AgileRadioCom-LLC/ARC-Re-Packaging-Design/README.md

# RPKG
Repo for ArcSynerCom RPKG Files
# ARC-Re-Packaging-Design
