AgileRadioCom-LLC/ARC-Re-Packaging-Design/DECISIONS_LOG.md

# UZEV ADRV9009 Carrier — Decisions Log

This log captures every decision made that affects the design, with provenance.
Newest entries at the top. Each entry cites its source of truth.

## DEC-051 — Phase 8 netlist export complete
Date: 2026-06-17  |  Source: EEschema GUI, Tools → Generate Netlist File (KiCad format)
Status: COMPLETE. Netlist MD5: 7762ec8dbcc8da5028d237ab52b527b6

Exported as: Desktop/Netlist Files/4uzev_adrv9009_carrier.net (Jun 17 10:32 EDT)
Copied to:   uzev_carrier.net in project root (same MD5)
Tool: Eeschema 5.1.5+dfsg1-2build2, format version D, 192K, 175 components.

Verification:
  - All 8 Phase 7 footprints (FB1, J5, R68-R71, U6, U7) present and correct in netlist
  - Zero components with empty footprint field
  - KiCad (version D) format — ready for Pcbnew import

---

## DEC-050 — Phase 7 footprint assignment complete (power.sch)
Date: 2026-06-16  |  Source: Phase 7 audit; project UZEV_Connectors.pretty; system lib
Status: COMPLETE. power.sch MD5: 5cc2bc8720f66a9cf5d3e3c98180e88b

All 8 previously-MISSING F2 footprint fields in power.sch assigned atomically
via Python read-modify-write (os.replace). No other files changed.

Assignments made:
  FB1  (120R@100MHz 0603)       -> Inductor_SMD:L_0603_1608Metric        [system lib]
  J5   (USB_C_Receptacle)       -> UZEV_Connectors:USB_C_Receptacle_GCT_USB4135  [project lib]
  R68  (100k PG pull-up)        -> Resistor_SMD:R_0402_1005Metric        [system lib]
  R69  (100k PG pull-up)        -> Resistor_SMD:R_0402_1005Metric        [system lib]
  R70  (100k PG pull-up)        -> Resistor_SMD:R_0402_1005Metric        [system lib]
  R71  (100k PG pull-up)        -> Resistor_SMD:R_0402_1005Metric        [system lib]
  U6   (TPS25730D)              -> UZEV_Connectors:WQFN-38_TPS25730D     [project lib]
  U7   (TPS7A1633)              -> UZEV_Connectors:HVSSOP-8_TPS7A1633    [project lib]

All .kicad_mod files verified on disk before assignment. Zero MISSING, PLACEHOLDER,
or unresolved-library gaps remain in any sheet. Phase 7 complete.

---

## DEC-042 — 2026-06-12 — DEF-20 Edit 2b: EN daisy-chain rewire (DEF-20 CLOSED)

**Status:** APPLIED — ERC-25 0/0. Semantic net check passed.

**What:** Completed the §4.16 EN sequencing daisy-chain in power.sch. 11 ops:

(1) Added 4 × Text Labels naming the LDO PG nets at their pull-up nodes:
    L1_PG @ (7950,5600), L2_PG @ (7950,8300),
    L5_PG @ (27950,5600), L6_PG @ (27950,8300).
    These are required because KiCad Text Labels only name the net if the
    label coordinate sits on copper; without them the downstream EN labels
    would be electrically orphaned (same bug class as DEF-19 mid-span issue).

(2) Swapped 5 × SOM_PG_OUT GLabel → Text Label at B1–B5 EN far-ends:
    B1.EN (2600,5600) → L6_PG, B2.EN (2600,8300) → L1_PG,
    B3.EN (2600,11000) → L2_PG, B4.EN (12600,5600) → L2_PG,
    B5.EN (12600,8300) → L2_PG.

(3) Removed 2 × NoConn at B6.EN (23000,5600) and B7.EN (23000,8300).

(4) Added SOM_PG_OUT GLabel + wire (22600,5600)→(23000,5600) for B6.EN.

(5) Added L5_PG Text Label + wire (22600,8300)→(23000,8300) for B7.EN.

**Semantic net check (all PASS):**
- L6_PG: L6.PG(27950,8300) ↔ B1.EN(3000,5600) via label pair ✓
- L1_PG: L1.PG(7950,5600) ↔ B2.EN(3000,8300) via label pair ✓
- L2_PG: L2.PG(7950,8300) ↔ B3.EN + B4.EN + B5.EN via 4 labels ✓
- L5_PG: L5.PG(27950,5600) ↔ B7.EN(23000,8300) via label pair ✓
- SOM_PG_OUT: JX1.D47 (connectors.sch GLabel) ↔ B6.EN(23000,5600) ✓
              support_io.sch LED tap also on net ✓; no carrier pull-up added ✓

**Resulting §4.16 sequencing:**
- SOM_PG_OUT → B6.EN (G1: MGTRAVCC) → B7.EN (G1: MGTRAVTT) via L5_PG
- L6.PG → B1.EN (G2: MGTAVCC) → B2.EN (G2: MGTAVTT) via L1_PG
- L2.PG → B3.EN (G3: VCCO_HP_65) + B4.EN (G3: VCCO_HP_64) + B5.EN (G3: FMC_3P3V)
- MGTVCCAUX: passive tap off VCCO_HP_65 (Group 3, DS925-governed deviation — logged in DEF-20)

**File state:** power.sch PRE MD5=12e2bb6741618147d0cdcb2569b06f33 →
POST MD5=dcf8803f3f9b118bd183d47b4730725e (3812→3826 lines).

**Source:** Designer's Guide §4.16 p.37 (group order); DS925 p.65 (MGTAVCC before MGTAVTT).

---

## DEC-041 — 2026-06-12 — DEF-20 Edit 2a: LDO PG pull-up resistors R68–R71

**Status:** APPLIED — ERC-24 0/0.

**What:** Added 4 × 100kΩ pull-up resistors (R68–R71) on the PG pins of the
four LDOs that feed the DEF-20 sequencing chain (L1, L2, L5, L6). Each
pull-up connects pin1 to VIN (via GLabel) and pin2 to the LDO PG pin via a
two-segment wire (vertical stub + horizontal run). The four NoConn markers
previously suppressing ERC on those PG pins were removed.

**Why:** TPS7A85 PG is open-drain (type O in LDO_ENPG lib). An open-drain
output cannot drive a downstream EN input without an external pull-up to a
defined rail. Without these resistors the PG output is undefined high-Z when
the LDO is healthy, making the daisy-chain EN wiring (Edit 2b) non-functional.
Pattern mirrors existing BUCK PWRGD pull-ups R50–R53, R60, R67.

**Resistors placed (power.sch):**
- R68: P=(8700,5475), L1.PG=(7950,5600), VIN at pin1=(8700,5325)
- R69: P=(8700,8175), L2.PG=(7950,8300), VIN at pin1=(8700,8025)
- R70: P=(29000,5475), L5.PG=(27950,5600), VIN at pin1=(29000,5325)
- R71: P=(29000,8175), L6.PG=(27950,8300), VIN at pin1=(29000,8025)

**Wire clearances verified:** All horizontal runs pass through confirmed-clear
column gaps (C3, C19, C71, C78 gaps) and stop before FB-divider/remote-sense
columns at x=7950 and x=29500.

**UIDs:** 6C00011C–6C00011F (sequential after prior max 6C00011B).

**Footprint:** left empty pending Phase 7 sweep (DEC-028/029).

**File state:** power.sch PRE MD5=4f8ee3235c8896199ddbaddbdd203af3 →
POST MD5=12e2bb6741618147d0cdcb2569b06f33 (3748→3812 lines).

**Source:** TPS7A85 datasheet (open-drain PG specification); pattern from
R50–R53 (DEC-037) and R60/R67 (DEC-039).

**Next:** DEF-20 Edit 2b — daisy-chain EN rewiring (5 GLabel→TextLabel swaps
+ 7 new net connections). DEF-20 remains OPEN until 2b ERC passes.

---

## DEC-040 — 2026-06-12 — DEF-19 Edit 1 ERC fix: wire splits + stub NoConns

**Status:** APPLIED — ERC-22 0/0, save-cycle ERC-23 0/0. Verified stable.

**What:** Resolved 16 ErrType(2) "Pin not connected" errors introduced by
DEF-19 Edit 1 (B6/L5 MGTRAVCC + B7/L6 MGTRAVTT subcircuits). Two categories:

Part A — 12 cap pin mid-span errors (C68, C70, C71, C75, C77, C78, pins 1+2
each): root cause = pin tip fell mid-span on vertical wire stub (not at an
endpoint). Fix = split each wire at the pin coordinate into two collinear
sub-segments + explicit `Connection ~` junction marker at the split point.
Junction markers are required to survive KiCad GUI save; bare collinear seams
get re-merged (R50–R53 regression pattern, proven). All 12 pins are genuinely
connected — these were ERC flags only, not dead terminals.

Part B — 4 stub pin errors (B6.EN, B7.EN, L5.PG, L6.PG): root cause = one-
ended Text Label stub leaves the connected Input/Output pin flagged by ERC.
Fix = replace each wire+label pair with `NoConn ~` at the pin coordinate +
`Text Notes` preserving net name + "(DEF-20)" annotation for sequencing
traceability. Pattern matches existing L1–L4 PG/EN treatment.

**Script:** /tmp/def19_erc21_fix.py (atomic, os.replace, idempotency guard,
pre/post MD5). Pre-MD5: 44e850c0ee103e69fc867e278ea072a2.
Post-MD5: 4f8ee3235c8896199ddbaddbdd203af3. Lines: 3716 → 3748.

**Side finding logged as DEF-23** (pre-existing, out of scope here).

---

## DEC-035 — 2026-05-26 — Replace barrel jack J5 with USB-C PD input (HUSB238)

**Status:** APPLIED — audit 9/9 passed, ERC pending (GUI).

**Context:** Board needs a single standard power input. Barrel jacks are non-standard in field deployments; USB-C PD chargers (laptop bricks) are ubiquitous. Requirement: 12V primary supply, 15V fallback. No firmware — hardware-only PD negotiation.

**Decision:**
- Remove J5 (UZEV_Connectors:Barrel_Jack) from power.sch.
- Add USB-C receptacle (J5, re-used designator): GCT USB4135-GF-A, 16-pin mid-mount SMD, rated to 5A. Only VBUS, CC1, CC2, GND connected; SBU/D+/D- NC.
- Add HUSB238 PD sink controller (U6, Hynetek). Hardware pin-strap selects "highest available PDO ≤ 15V". On a 12V charger → 12V contract; on 15V/20V charger → 15V contract. No firmware. VOUT → VIN net (replaces barrel jack output).
- Add decoupling: 10µF/25V ceramic (C_VBUS) + 100nF/25V ceramic (C_VBUS2) on VBUS before HUSB238.
- HUSB238 CFG pins tied per datasheet table for "≤15V highest" profile (resistors to VSS or direct tie — confirmed from HUSB238 datasheet during implementation).
- Update text note line "Barrel jack -> VIN..." to "USB-C PD (HUSB238, 12V/15V) -> VIN...".

**Rationale:** HUSB238 is the simplest hardware-only PD sink — no I2C, no MCU. Single chip. CFG pins fully determine negotiated voltage. Widely used in open-hardware PD designs.

**Implementation steps:**
1. Add USB_C_Receptacle and HUSB238 symbols to UZEV_Connectors.lib (new DEF blocks).
2. Add USB_C_Receptacle and HUSB238 footprints to UZEV_Connectors.pretty/.
3. Edit power.sch: remove J5 barrel jack block + #PWR04 + its wire; add new USB-C + HUSB238 section.
4. Update phase7_prepcb_audit.py hashes.

**New components added to power.sch:**
- J5 — USB_C_Receptacle (USB4135-GF-A footprint) — replaces barrel jack
- U6 — HUSB238 (SOT-23-9_Hynetek_HUSB238 footprint)
- C60 — 10µF/25V 1210 on VBUS (bulk decoupling)
- C61 — 100nF/25V 0402 on VBUS (HF decoupling)
- R40 — 10kΩ 0402 PG pullup (VOUT → PG pin)
- #PWR062–#PWR066 (5 GND symbols)

**Implementation note:** `dec035_step3_sch.py` used a stamp-based block-removal regex that expanded across $Comp boundaries, accidentally deleting C4/C5/C6/#PWR01-03 (VIN rail caps). `dec035_step3_repair.py` restored these and renamed the VBUS decoupling caps from C7/C8 (collision with existing B3 buck caps) to C60/C61.

**HUSB238 CFG pins:** Tied to GND in schematic. Exact bit-table for "highest available ≤ 15V" must be confirmed from HUSB238 datasheet PDF before fab. Update schematic if CFG configuration differs from GND-tie.

**Files modified:**
- `UZEV_Connectors.lib`: md5=`63fe2e2e3c9c84424d2f50d959ecd432` size=65554
- `UZEV_Connectors.pretty/USB_C_Receptacle_GCT_USB4135.kicad_mod`: created
- `UZEV_Connectors.pretty/SOT-23-9_Hynetek_HUSB238.kicad_mod`: created
- `power.sch`: md5=`8eeabb3d55a62b4177046839b82a2275` size=51906
- `phase7_prepcb_audit.py`: hash table updated

---

## DEC-034 — 2026-05-26 — Add external buck converter circuit components to schematic

**Status:** APPLIED — all post-checks passed, phase7_prepcb_audit 9/9 passed.

**Context:** Buck_ENPG symbol (TPS54320 × 4 B1-B4, TPS54531 × 1 B5) had only VIN/GND/VOUT/EN/PG/FB pins in the schematic. External application circuit components (inductor, bootstrap cap, compensation network, soft-start cap, catch diode) were missing — required for PCB layout and BOM.

**Step 1 — Extend Buck_ENPG symbol (UZEV_Connectors.lib):**
Added 5 pins to Buck_ENPG DRAW block; body extended from S -300 300 300 -300 to S -300 450 300 -450:
- SW 7 — 500 350 200 L P (switched node, power)
- BOOT 8 — 0 650 200 D P (bootstrap, power)
- COMP 9 — -500 -250 200 R P (compensation, power)
- RT 10 — -500 -400 200 R I (freq-set resistor, input)
- SS 11 — 200 -650 200 U I (soft-start cap, input)
Script: `dec034_step1_lib.py`. Pre-md5: `55a6352265bd284d8ffab7a67f2f0e08`.
Post-md5: `6331f14394645f511d8ec71a2a17cd45` size=64487.

**Step 2 — Add external components to power.sch:**
Added 36 components + wires + junctions for all 5 bucks. Script: `dec034_step2_sch.py`.
Per-buck placement at (Px,Py) with pins at SW=(Px+500,Py-350), BOOT=(Px,Py-650), COMP=(Px-500,Py+250), RT=(Px-500,Py+400), SS=(Px+200,Py+650):

| Component | Value | Footprint | Count |
|---|---|---|---|
| IND1–IND5 | 4.7µH | Inductor_SMD:L_1210_3225Metric | 5 |
| C40–C44 (C_BOOT) | 100nF | C_0402_1005Metric | 5 |
| C45–C49 (C_COMP B1-B4) | 15nF / (B5) 2200pF | C_0402_1005Metric | 5 |
| C50–C54 (C_HF B1-B4) | 330pF / (B5) 22pF | C_0402_1005Metric | 5 |
| C55–C59 (C_SS) | 10nF | C_0402_1005Metric | 5 |
| R31–R35 (R_COMP B1-B4) | 1.78kΩ / (B5) 37.4kΩ | R_0402_1005Metric | 5 |
| R36–R39 (R_RT, B1-B4 only) | 100kΩ | R_0402_1005Metric | 4 |
| D2 (catch diode, B5 only) | CDBC540-G | Diode_SMD:D_SOD-123 | 1 |
| #PWR042–#PWR061 | GND | — | 20 |

COMP wire route: (Px-500,Py+250)→(Px-600,Py+350)→(Px-1900,Py+350) [y=Py+350 clears R_RT body at Py+400].
B5 RT pin: NoConn ~ 13000 8600.

**Step 2b — Fix ref collisions:**
C20-C39 conflicted with existing refs in adrv9009_signals.sch (C21-C28) and support_io.sch (C29, D1).
Script: `dec034_step2b_fixrefs.py` renamed C20-C39→C40-C59 and D1(stamp 6C000093)→D2.

**Stamp range used:** 0x6C00005E–0x6C000094 (55 stamps).

**Files modified:**
- `UZEV_Connectors.lib`: Buck_ENPG symbol extended. md5=`6331f14394645f511d8ec71a2a17cd45` size=64487
- `power.sch`: 36 components added. md5=`7c33f35db7145168e8f9760c04a47975` size=49068
- `phase7_prepcb_audit.py`: EXPECTED_HASHES updated for UZEV_Connectors.lib and power.sch

---

## DEC-033 — 2026-05-25 — Phase 7: Footprint corrections for B5, L1-L4, B1-B4

**Status:** APPLIED — static verification passed (0 empty footprints, old strings absent). ERC pending (GUI).

**Context:** Phase 7 footprint inventory revealed three footprint assignment errors in power.sch.
All corrections derived from TI primary-source package outline and land pattern drawings.

**Change 1 — B5 (TPS54531, FMC_3P3V rail, 5A buck):**
- Old: `Package_TO_SOT_SMD:PowerPAD_SO-8_EP_3.9x4.9mm_P1.27mm`
- New: `Package_SO:SOIC-8-1EP_3.9x4.9mm_P1.27mm_EP2.95x4.9mm_Mask2.71x3.4mm`
- Source: tps54531.pdf p.34, DDA0008B Package Outline — EP 2.95×4.9mm copper, 2.71×3.4mm mask.
  Old footprint had wrong EP geometry and wrong library prefix.

**Change 2 — L1-L4 (TPS7A85, 4A LDO × 4):**
- Old: `Package_DFN_QFN:VQFN-20-1EP_3.5x3.5mm_P0.5mm_EP2.1x2.1mm`
- New: `Package_DFN_QFN:QFN-20-1EP_3.5x3.5mm_P0.5mm_EP2x2mm`
- Source: tps7a85.pdf pp.46-47, RGR0020A Land Pattern Example — EP 2.0×2.0mm recommended.
  EP difference 0.05mm undersize; conservative and within IPC tolerance. Standard footprint
  already present in KISYSMOD.

**Change 3 — B1-B4 (TPS54320, 3A buck × 4, Architecture B):**
- Old: `Package_DFN_QFN:VQFN-14-1EP_3.5x4.5mm_P0.65mm_EP2.1x3.1mm` (wrong on all three
  dimensions: body was 3.5×4.5 not 3.5×3.5; pitch was 0.65 not 0.5; EP was 2.1×3.1 not 2.05×2.05)
- New: `UZEV_Connectors:VQFN-14-1EP_3.5x3.5mm_P0.5mm_EP2.05x2.05mm` (custom, created this session)
- Source: tps54320.pdf pp.40-41, RHL0014A Package Outline + Land Pattern Example.
  Pin arrangement 2+5+2+5 (top+left+bottom+right). Pin 1 at top-left confirmed by dotted
  surface mark and 45° chamfer. CCW numbering confirmed from land pattern figure. EP 2.05×2.05mm,
  signal pad size 0.24×0.6mm (top/bottom rows) and 0.6×0.24mm (left/right columns), pad reach
  1.65mm from center, pitch 0.5mm.
  Custom .kicad_mod written to UZEV_Connectors.pretty/ with segmented EP paste pads (4×0.75mm sq).

**Files modified:**
- `power.sch`: 9 footprint field substitutions (1 B5, 4 L1-L4, 4 B1-B4)
- `UZEV_Connectors.pretty/VQFN-14-1EP_3.5x3.5mm_P0.5mm_EP2.05x2.05mm.kicad_mod`: created

**Hashes post-DEC-033:**
- `power.sch`: md5=`126da442c9bdf1cb99d62f1e8e0778c3` size=32493

---

## DEC-032 — 2026-05-25 — ADD_REV1: Add micro-SD card slot (PS SD1, MIO45-51)

**Status:** APPLIED — ERC 14 confirmed 0 errors, 0 warnings.

**Context:** DEC-021 reserved the micro-SD slot as the sole carrier-side storage addition.
DEC-022 designated it DNP for flight builds. MIO45-51 on UltraZed-EV JX3 connector carry
PS SD1 (1.8V UHS-I interface). No SD1 circuitry existed on the board prior to this decision.

**Decision:** Add J8 (Micro_SD_Card_Det, Hirose DM3AT-SF-PEJM5 footprint) in support_io.sch.
Wire MIO45-51 from J3 stubs in connectors.sch to J8 via global labels. DNP J8 and ESD array
(PRTR5V0U2X or equiv) for flight builds per DEC-021.

**Signal mapping (PS SD1, MIO pin → JX3 ball → GLabel → J8 pin):**
| MIO | JX3 ball | GLabel | J8 pin |
|-----|---|---|---|
| 45  | A23 | SD1_CD_N  | DET_A (pin 10) |
| 46  | B24 | SD1_CLK | CLK (pin 5)  |
| 47  | A25 | SD1_CMD | CMD (pin 3)  |
| 48  | B26 | SD1_D0 | DAT0  (pin 7)  |
| 49  | A27 | SD1_D1 | DAT1  (pin 8)  |
| 50  | B28 | SD1_D2 | DAT2  (pin 1)  |
| 51  | A29 | SD1_D3 | DAT3/CD (pin 2) |

**Changes applied (atomic Python script `add_rev1_sd_card.py` + manual PWR_FLAG fix):**

| Sheet | Change |
|---|---|
| connectors.sch | Removed 7 NoConns on J3 MIO45-51 pins |
| connectors.sch | Added wire stubs + GLabels SD1_CD_N/CLK/CMD/D0-D3 on J3 MIO45-51 |
| support_io.sch | Added J8 Micro_SD_Card_Det at P=(3500,12800) |
| support_io.sch | Added power:+3V3 #PWR_SD01 at (2600,12700) for J8 VDD |
| support_io.sch | Added power:GND #PWR_SD02 at (2600,12900) for J8 VSS |
| support_io.sch | Added power:GND #PWR_SD03 at (4300,13300) for J8 SHIELD |
| support_io.sch | Added PWR_FLAG #FLG_SD01 at (2600,12700) to drive +3V3 net (ERC fix) |
| support_io.sch | Added 7 GLabel+wire pairs (SD1_* nets) connecting to J8 left-side pins |
| support_io.sch | Added NoConn at (2600,13300) for J8 DET_B (pin 9) |

**Files modified:**
- `connectors.sch`
  - Before md5: `4a62b831b36487f0c14ae96b93290207` (post-DEC-031)
  - After md5: `0377a743d1d3fc07bb2aeb4394f67ba2`
- `support_io.sch`
  - Before md5: `054467de6de13ad08470abd19f86b090`
  - After md5: `34c0a2aeb89bbd37e8e34374e4718a6d`

**ERC:** 14uzev_adrv9009_carrier.erc — 0 errors, 0 warnings
**Netlist:** 2uzev_adrv9009_carrier.net — all 7 SD1 nets verified (SD1_CLK: J3-B24+J8-5; SD1_CMD: J3-A25+J8-3; SD1_D0: J3-B26+J8-7; SD1_D1: J3-A27+J8-8; SD1_D2: J3-B28+J8-1; SD1_D3: J3-A29+J8-2; SD1_CD_N: J3-A23+J8-10)

**Bitstream impact:** None (schematic only; PS SD1 enabled in Zynq PS config, not PL).

---

## DEC-031 — 2026-05-25 — Fix tx_sync_1 net merge failure (direct naming)

**Status:** APPLIED — ERC 13 confirmed 0 errors, 0 warnings. Netlist verified.

**Context:** DEC-030 added GLabels around pre-existing floating wires in adrv9009_signals.sch
to bridge FMC_H31_LA28_P ↔ HP_DP_38_P and FMC_H32_LA28_N ↔ HP_DP_38_N. Despite identical
format to all working signals, KiCad 5.1.5 did not merge the nets — the four pins still
appeared as isolated one-node stubs in the netlist (nets 237/238/254/255). ERC also reported
all four pins as unconnected (ErrType 2). Root cause: the tx_sync_1 wires in
adrv9009_signals.sch pre-existed from DEC-007 as purely decorative floating stubs with no
labels; adding GLabels around pre-existing floating wires in this context did not produce
net merging in KiCad's legacy resolver.

**Fix:** Bypass adrv9009_signals.sch routing entirely. Give both connector stubs the same
GLabel name directly in connectors.sch so they merge on the connectors sheet without
requiring a cross-sheet bridge.

**Changes applied (atomic Python script `fix_dec031_tx_sync1_direct.py`):**

| Sheet | Change |
|---|---|
| connectors.sch | Renamed GLabel HP_DP_38_P → FMC_H31_LA28_P on J1-B36 stub at (6600,7050) |
| connectors.sch | Renamed GLabel HP_DP_38_N → FMC_H32_LA28_N on J1-B37 stub at (5400,7150) |
| adrv9009_signals.sch | Reverted DEC-030 GLabels: removed 4 GLabels, restored original floating wires + notes |

**Resulting net names:**
- `FMC_H31_LA28_P` — nodes: J4-H31, J1-B36
- `FMC_H32_LA28_N` — nodes: J4-H32, J1-B37
- `HP_DP_38_P` / `HP_DP_38_N` — eliminated from netlist

**Files modified:**
- `connectors.sch`
  - Before md5: `799a9828c934434be5dd4c1e49bcbca4` (DEC-030 state)
  - After md5: `4a62b831b36487f0c14ae96b93290207`
- `adrv9009_signals.sch`
  - Before md5: `254ff6d046b4a41afaf7bbee64680f1a` (DEC-030 state)
  - After md5: `e0d870dacab2bcf0028b8c255f9fb0f6`

**ERC:** 13uzev_adrv9009_carrier.erc — 0 errors, 0 warnings
**Netlist:** 1uzev_adrv9009_carrier.net — FMC_H31_LA28_P has J4-H31 + J1-B36; FMC_H32_LA28_N has J4-H32 + J1-B37

**Bitstream impact:** None (signal routing only).

---

## DEC-030 — 2026-05-22 — Fix tx_sync_1 missing GLabels and connector stubs

**Status:** APPLIED — ERC VERIFICATION REQUIRED

**Context:** CRIT-1 Sheet 3 audit (Step 4, transition doc) revealed that the ADRV9009
tx_sync_1 differential pair (FMC H31_LA28_P/H32_LA28_N → JX1 B36/B37) was completely
unrouted. DEC-007 placed tie wires at Y=6200 and Y=6450 in adrv9009_signals.sch but
omitted all four GLabels (FMC side and HP_DP side). Neither the FMC connector pin nor
the JX1 pin was wired in connectors.sch; both positions had NoConn flags from DEC-029.

**Root cause:** DEC-007 did not include tx_sync_1 in its signal set. The wire stubs were
placed but without net labels, leaving them as netlist-invisible floating wires.

**Authoritative mapping (from UZEV_Connectors.lib unit 2 lines 101–102):**
- JX1 B36 = HP_DP_38_P (lib: x=400, y=-1050, unit 2, P=(6000,6000))
- JX1 B37 = HP_DP_38_N (lib: x=-400, y=-1150, unit 2, P=(6000,6000))

**Changes applied (atomic Python script `fix_dec030_tx_sync1.py`):**

| Sheet | Change |
|---|---|
| adrv9009_signals.sch | Added GLabel FMC_H31_LA28_P at (12000,6200) orientation 0 |
| adrv9009_signals.sch | Added GLabel HP_DP_38_P at (13400,6200) orientation 2 |
| adrv9009_signals.sch | Added GLabel FMC_H32_LA28_N at (12000,6450) orientation 0 |
| adrv9009_signals.sch | Added GLabel HP_DP_38_N at (13400,6450) orientation 2 |
| connectors.sch | Removed NoConn at (23900,21000) — FMC H31 pin |
| connectors.sch | Removed NoConn at (23900,21100) — FMC H32 pin |
| connectors.sch | Added wire (23900,21000)→(23700,21000) + GLabel FMC_H31_LA28_P |
| connectors.sch | Added wire (23900,21100)→(23700,21100) + GLabel FMC_H32_LA28_N |
| connectors.sch | Removed NoConn at (6400,7050) — JX1 B36 pin |
| connectors.sch | Removed NoConn at (5600,7150) — JX1 B37 pin |
| connectors.sch | Added wire (6400,7050)→(6600,7050) + GLabel HP_DP_38_P |
| connectors.sch | Added wire (5600,7150)→(5400,7150) + GLabel HP_DP_38_N |

**Files modified:**
- `adrv9009_signals.sch`
  - Backup: `adrv9009_signals.sch.bak.before_dec030`
  - Before md5: `e0d870dacab2bcf0028b8c255f9fb0f6`
  - After md5: `254ff6d046b4a41afaf7bbee64680f1a`
- `connectors.sch`
  - Backup: `connectors.sch.bak.before_dec030`
  - Before md5: `f8a98eae84bb475b77ef83cc5effc7b4`
  - After md5: `799a9828c934434be5dd4c1e49bcbca4`

**Bitstream impact:** None (signal routing only; FPGA logic unchanged).

---

## DEC-029 — 2026-05-06 — NoConn flag sweep: all four sheets

**Status:** APPLIED

**Context:** ERC 10 confirmed 0 errors, 0 warnings. Final pre-netlist cleanup: added NoConn
markers to all unused connector and IC pins across all sheets to suppress future ErrType(2)
regression.

**NoConn counts added:**
| Sheet | File | Flags added |
|---|---|---|
| Connectors | connectors.sch | 753 |
| Power | power.sch | 35 |
| Support I/O | support_io.sch | 22 |
| ADRV9009 Signals | adrv9009_signals.sch | 0 (no unused pins) |

**Files modified:**
- `connectors.sch`: 753 `NoConn ~` lines appended
  - Backup: `connectors.sch.bak.before_dec029`
  - Before md5: `166f82731273d96b3b10ba57255747f0`
  - After md5: `f8a98eae84bb475b77ef83cc5effc7b4`
- `power.sch`: 35 `NoConn ~` lines appended
  - Backup: `power.sch.bak.before_dec029`
  - Before md5: `f8cdc93a8259730bfe302772a32c3bc2`
  - After md5: `4922751bd9b52f966b395b021c877bc9`
- `support_io.sch`: 22 `NoConn ~` lines appended
  - Backup: `support_io.sch.bak.before_dec029`
  - Before md5: `81f38d8fde00ad0a205b612d3806d728`
  - After md5: `054467de6de13ad08470abd19f86b090`

**ERC result:** ERC 10 (`10uzev_adrv9009_carrier.erc`, 2026-05-06) — 0 errors, 0 warnings.
DEF-11 closed. All sheets ERC-clean.

**Bitstream impact:** None.

---

## DEC-028 — 2026-05-06 — Phase 5c: Rfb feedback resistor networks added to power.sch

**Status:** APPLIED — closes DEF-11

**Context:** DEF-11 required Rfb divider networks for all 5 buck stages (TPS54320 × 4,
TPS54531 × 1) and all 4 LDO stages (TPS7A85 × 4) to set their respective output voltages.
18 resistors (R13–R30) in 9 Rfb divider pairs placed adjacent to their respective IC FB pins.
Lower resistor in each pair is 100kΩ; upper resistor sets the ratio. All use
`Resistor_SMD:R_0402_1005Metric` footprint.

**Rfb divider pairs (upper/lower, 100kΩ lower for all):**

| Refdes pair | Upper value | Target rail | IC | Formula target |
|---|---|---|----|---|
| R13 / R14 | 88.7kΩ / 100kΩ | VMGTAVCC_PRE = 1.5V | B1 TPS54320 | 0.8×(1+88.7/100) |
| R15 / R16 | 124kΩ / 100kΩ | VMGTAVTT_PRE = 1.8V | B2 TPS54320 | 0.8×(1+124/100) |
| R17 / R18 | 215kΩ / 100kΩ | VVCCO65_PRE = 2.5V | B3 TPS54320 | 0.8×(1+215/100) |
| R19 / R20 | 215kΩ / 100kΩ | VVCCO64_PRE = 2.5V | B4 TPS54320 | 0.8×(1+215/100) |
| R21 / R22 | 316kΩ / 100kΩ | FMC_3P3V = 3.3V | B5 TPS54531 | 0.8×(1+316/100) |
| R23 / R24 | 12.4kΩ / 100kΩ | MGTAVCC = 0.9V | L1 TPS7A85 | see note |
| R25 / R26 | 49.9kΩ / 100kΩ | MGTAVTT = 1.2V | L2 TPS7A85 | see note |
| R27 / R28 | 124kΩ / 100kΩ | VCCO_HP_65 = 1.8V | L3 TPS7A85 | see note |
| R29 / R30 | 124kΩ / 100kΩ | VCCO_HP_64 = 1.8V | L4 TPS7A85 | see note |

Note on TPS7A85 formula: TPS7A85 Vref = 1.21V; Vout = 1.21×(1 + Rupper/Rlower). Rail-to-
resistor pair assignment for L1–L4 inferred from schematic position; exact calculation
provenance not captured at time of application (logged retroactively).

**GND symbols added:** #PWRFB01–#PWRFB09 (one per divider pair, power:GND type).

**Files modified:**
- `power.sch`: 18 $Comp resistor blocks + 9 GND symbols + 9 wires added
  - Backup: `power.sch.bak.before_dec028`
  - Before md5: `fd2cceec6786c3b7208c30171019d2d4`
  - After md5: `f8cdc93a8259730bfe302772a32c3bc2`

**Bitstream impact:** None.

---

## DEC-027 — 2026-05-06 — Fix C10/C11 wire endpoints + add PWR_FLAG for GND net

**Status:** APPLIED — ERC VERIFICATION REQUIRED

**Context:** ERC 6uzev showed: (1) ErrType(3) #PWR012 Net 829 not driven. (2) ErrType(2) both
pins of C10 and C11 unconnected (MGTVCCAUX bypass caps). C10/C11 were placed by the DEC-019
rewrite script with wire endpoints at ±100 mils from center, but Device:C pins are at ±150 mils —
same 50-mil generator error pattern as DEC-017 resistors.

**Fixes applied (atomic Python script `fix_dec023_erc_errors.py`):**

| Fix | Change | File line |
|-----|---|---|
| C10 top wire | `1800 12800 1800 13000` → `1800 12800 1800 12950` | 689 |
| C10 bottom wire | `1800 13200 1800 13300` → `1800 13250 1800 13300` | 691 |
| C11 top wire | `2600 12800 2600 13000` → `2600 12800 2600 12950` | 716 |
| C11 bottom wire | `2600 13200 2600 13300` → `2600 13250 2600 13300` | 718 |
| GND PWR_FLAG | Added #FLG_V02 + #PWR041 at (4800,2900)/(4800,3100), wire (4800,2900)→(4800,3100) | ~130 |

**Caveat — #PWR012 ErrType(3):** Per DEC-026 precedent, isolated GND clusters require physical
wire ties (not just PWR_FLAGs) to merge into the global GND net. If Net 829 is a truly isolated
cluster rather than the undriven global GND net, the PWR_FLAG will not clear the ErrType(3).
A wire tie from (3500,11500) to the nearest proven-global GND node may be needed.

**Files modified:**
- `power.sch`: 4 wire corrections + 1 PWR_FLAG/GND pair + 1 wire added
  - Backup: `power.sch.bak.before_dec023`
  - Before md5: `2f028166e39c7a5a2d44cb800053879c` (DEC-026 state)
  - After md5: `24e76144fe0863d578843a83150ab76d`

**Bitstream impact:** None.

---

## DEC-026 — 2026-05-05 — Add GND tie wires for L1 and L4 LDO component GND nodes

**Status:** APPLIED

**Context:** ERC file 5 showed ErrType(3) Net 828 persisting at #PWR029 (L1 LDO GND,
7500,6050) despite DEC-025 duplicate-refdes fix. Root cause: L1 and L4 LDO component
GND pins connect only to their local GND symbol via a short stub wire — no physical wire
ties these clusters to the global GND network. KiCad 5 ERC does not auto-merge this
isolated cluster via the power:GND net-name mechanism for this specific topology. Fix
applied symmetrically to both L1 and L4 to prevent error migration.

**Wires added:**
- (7500,6050)→(8150,6050): L1 GND horizontal leg
- (8150,6050)→(8150,5850): L1 GND joins #PWR005 (L1 output cap GND)
- (17500,6050)→(18150,6050): L4 GND horizontal leg
- (18150,6050)→(18150,5850): L4 GND joins #PWR022 (L4 output cap GND)

**Files modified:**
- `power.sch`: 4 Wire Wire Line entries added
  - Backup: `power.sch.bak.before_dec026.20260505_162458`
  - New md5: `2f028166e39c7a5a2d44cb800053879c` (23859 bytes)

**Bitstream impact:** None.

---

## DEC-025 — 2026-04-30 — Rename duplicate #PWR001–#PWR004 second instances in power.sch

**Status:** APPLIED

**Context:** ERC file 4 (`4uzev_adrv9009_carrier.erc`) showed ErrType(3) persisting at
`#PWR0104` @ (190.50mm, 153.67mm) = (7500, 6050) mils in Sheet /Power/. KiCad internally
disambiguated the duplicate `#PWR004` (two instances: (2400,3100) and (7500,6050)) by
renaming the second to `#PWR0104` in the ERC report — treating it as a separate component
not merged into the global GND net. Root cause confirmed: duplicate `#PWR001`–`#PWR004`
refdes across VIN section and buck stage section, caused by the DEC-019 rewrite script
reusing VIN-section refdes for the B1/L1 stage symbols.

**Decision:** Rename SECOND instance of each duplicate to next available refdes (#PWR026–
#PWR029). First instances (in VIN section) retain their original references.

**Renames applied (by UID):**
| UID | Old ref | New ref | Position |
|-----|---|---|---|
| 6C00000E | #PWR001 | #PWR026 | (2800, 5850) — B1 bypass cap GND |
| 6C00000F | #PWR002 | #PWR027 | (3500, 6100) — B1 buck GND |
| 6C000011 | #PWR003 | #PWR028 | (5525, 5850) — B1/L1 filter cap GND |
| 6C000012 | #PWR004 | #PWR029 | (7500, 6050) — L1 LDO GND |

**Expected ERC impact:** ErrType(3) Net 828 clears. All GND symbols now have unique
references; KiCad merges all into global GND net without isolation.

**Files modified:**
- `power.sch`: 4 × F0 + L field renames (2-byte net change each)
  - Backup: `power.sch.bak.before_dec025.20260430_114015`
  - New md5: `8bf622bdc2e8f676081f33431419a8d3` (23711 bytes)

**Bitstream impact:** None (cosmetic/ERC only).

---

## DEC-024 — 2026-04-30 — Delete PWR_FLAG symbols #FLG_P01–#FLG_P05 from power.sch

**Status:** APPLIED

**Context:** ERC report (`3uzev_adrv9009_carrier.erc`) showed 5 ErrType(5) errors:
power output conflict on nets MGTAVCC (248), MGTAVTT (252), VCCO_HP_65 (269),
VCCO_HP_64 (264), FMC_3P3V (68). Root cause: DEC-019 defined custom `UZEV_Connectors_LDO_ENPG`
and `UZEV_Connectors_Buck_ENPG` symbols with Pin 3 VOUT as type `w` (Power output).
Retained legacy PWR_FLAG symbols (#FLG_P01–P05) on the same nets are also type `w`.
Two Power output pins on one net = ErrType(5) conflict.

**Decision:** Delete #FLG_P01–P05 (redundant PWR_FLAGs on LDO/Buck output nets). Retain
#FLG_V01 on VIN net — VIN has no other `w` driver, so #FLG_V01 is still required.

**Symbols deleted (by UID):**
| Refdes | UID | Net |
|---|-----|-----|
| #FLG_P01 | 6C00000C | MGTAVCC (L1 output) |
| #FLG_P02 | 6C000017 | MGTAVTT (L2 output) |
| #FLG_P03 | 6C000022 | VCCO_HP_65 (L3 output) |
| #FLG_P04 | 6C000031 | VCCO_HP_64 (L4 output) |
| #FLG_P05 | 6C00003B | FMC_3P3V (B5 output) |

**Expected ERC impact:** 5 ErrType(5) errors clear. ErrType(3) Net 828 and ErrType(2)
count unaffected by this change.

**Files modified:**
- `power.sch`: 5 × $Comp blocks removed (1308 bytes, 55 lines removed)
  - Backup: `power.sch.bak.before_dec024.20260430_103357`
  - New md5: `9c65dda45f38383c24edc5ea67c20973` (23709 bytes)

**Bitstream impact:** None (cosmetic/ERC only).

Format:
  ## YYYY-MM-DD HH:MM — ID — One-line summary
  **Decision**: What was decided
  **Source**: Where the authority came from
  **Rationale**: Why
  **Files touched**: Which files were modified (with backup names)
  **Verified by**: How the decision was checked

---

## 2026-04-29 — DEC-023 — DEF-12 fix: C4/C5/C6 duplicate refdes renamed; hash drift accepted

**Status:** VALID

**Decision (two parts):**

**Part A — DEF-12: duplicate refdes resolution in power.sch**
Three capacitors introduced by the DEC-019 rewrite script were assigned refdes C4/C5/C6,
colliding with the pre-existing VIN bulk caps of the same names. Renamed by UID:

| UID | Old refdes | Value | New refdes | Role |
|-----|---|---|---|---|
| 6C000018 | C4 | 100nF | C17 | Buck stage bypass cap |
| 6C00001B | C5 | 47uF  | C18 | Buck stage output cap |
| 6C00001E | C6 | 10uF  | C19 | Buck stage output cap |

Pre-existing C4 (33uF, uid=6C000002), C5 (33uF, uid=6C000003), C6 (100nF, uid=6C000004)
unchanged — these are VIN bulk input caps and retain their original refdes.

**Part B — hash drift acceptance for power.sch and support_io.sch**
Both files show hash changes from last logged values with no content regression:
- power.sch: logged 36675a02 (post DEC-019) → observed e27e72b4 → post-DEC-023 68d2f8c7.
  Content verified: Rev 2.0, 64 $Comp, correct wires/GLabels.
- support_io.sch: logged ac1a54d9 (post DEC-018) → observed 1f0c192e.
  Content verified: DEC-018 text fixes present (lines 88/407/409 correct), R6-R9 wiring intact,
  J7 all 6 pins connected. Drift is KiCad cosmetic re-save (same pattern as DEC-012, DEC-016).

**Source:** Schematic file parse; UID-targeted substitution; grep verification.

**Rationale:** Duplicate refdes causes ERC errors and BOM ambiguity. Rename to next
available refdes (C17–C19) is the minimal correct fix. Hash drift is cosmetic; content
integrity confirmed by element count, Rev field, and text grep.

**Files modified:**
- `power.sch`: F 0 renamed in 3 blocks; backup `power.sch.bak.before_dec023.20260429_145750`
  - Pre-edit md5:  e27e72b4955047253ba50e47003d020d
  - Post-edit md5: 68d2f8c782ca73a4c25d81c39a4bccdf  size=25019

**Bitstream impact:** None.

---

## 2026-04-29 — DEC-022 — SOM-onboard QSPI confirmed as primary boot source; SD card sole carrier-side addition

**Status:** ACTIVE

**Decision:**
- SOM-onboard QSPI flash (256Mb Micron, PS MIO0–5, not exposed to JX connectors) is the
  confirmed primary and sole boot storage for both development and production flight builds.
  It is vibration-tolerant (soldered on SOM), survives UAV flight environment, and is the
  standard FSBL/PetaLinux boot source for the UltraZed-EV platform.
- No carrier-side QSPI is required or possible (PS MIO0–5 not routed to JX).
- SD card slot (micro-SD, PS SD1 on MIO46–51) is the sole carrier-side storage addition
  for Rev 1. Purpose: Petalinux rootfs / development images / field firmware updates.
  DNP (Do Not Populate) for flight builds per DEC-021.
- eMMC deferred to Rev 2 (SOM onboard 4GB eMMC is available but not the primary boot
  path; carrier eMMC would require MIO pins already used or unavailable).

**Source:** Avnet UltraZed-EV Designer's Guide (SOM hardware block diagram);
UG1085 Chapter 29 (SD/eMMC MIO assignments); user directive 2026-04-29.

**Rationale:** Consolidates DEC-021 QSPI clarification. Eliminates ambiguity between
"QSPI on carrier" (impossible) and "QSPI boot available" (true via SOM). Documents SD
card as the single new carrier storage component, with clear DNP flight-build path.

**Files touched:**
- `zcu106_parity_audit.md`: QSPI Table 2 row note updated to standard wording;
  QSPI note block replaced with concise DEC-022 reference; summary table updated.
- `transition_docs/TRANSITION_2026-04-29.md`: Section 6 Step 2 updated with UG1085
  citation and SD1 MIO pin table; boot path note updated.
- `bringup_boot_flow.md`: Created — FSBL/QSPI/PetaLinux bring-up procedure.

**Bitstream impact:** None.

---

## 2026-04-29 — DEC-021 — Mission-driven scope triage: QSPI + SD added, eMMC/GbE/USB deferred

**Status:** ACTIVE

**Context:** UAV datalink mission use case drives interface scope. Bring-up via JTAG+Vitis.
Production flight requires autonomous boot from vibration-tolerant, soldered storage.

**Decision — dispositions locked:**

| Interface | Disposition | Rationale |
|---|---|---|
| JTAG (J7) | KEEP | Already in schematic (DEC-015/017). Required for bring-up. |
| UART (J6) | KEEP | Already in schematic. Required for console. |
| QSPI flash boot | PROVIDED_BY_SOM | UltraZed-EV SOM has 256Mb Micron QSPI soldered on module (PS MIO0–5). Vibration-tolerant, soldered. Satisfies flight boot requirement. MIO0–5 not on JX connectors, so carrier cannot and need not provide external QSPI. |
| SD card slot | ADD_REV1 | Dev convenience + field firmware updates. DNP for flight builds. Add micro-SD to support_io.sch, route MIO46–51 from JX3. |
| eMMC | DEFER_REV2 | SOM has 4GB onboard eMMC. External eMMC on carrier does not earn its complexity for this mission profile. |
| GbE | DEFER_REV2 | Useful for ground-station dev; not required for UAV flight operation. |
| USB 2.0 OTG | DEFER_REV2 | Useful for ground dev only. |
| I2C | NICE_TO_HAVE | Board-ID EEPROM useful; add if space permits. |
| PMBus | NICE_TO_HAVE | Power monitoring useful; add if space permits. |
| DisplayPort | DEFER_FOREVER | FBVB900E package does not bond out PS DP pins. |
| SATA | DEFER_FOREVER | PS GTR lanes not routed to JX on UltraZed-EV SOM. |

**Source:** User directive 2026-04-29. Cross-referenced against zcu106_parity_audit.md
(updated this session) and Avnet UltraZed-EV Designer's Guide Table 26 (MIO pin availability).

**Rationale:** QSPI boot is the only non-negotiable for autonomous flight operation.
The SOM already provides it. SD card gives field maintainability without mechanical
fragility risk (DNP for flight). Everything else is ground-station convenience and
deferred until Rev 2 proves the radio link.

**Files touched:**
- `zcu106_parity_audit.md`: Disposition column added to all three tables; QSPI moved
  from Table 3 (impossible) to Table 2 with PROVIDED_BY_SOM disposition + explanatory note;
  mission-driven disposition summary table added.
- `transition_docs/TRANSITION_2026-04-29.md`: Section 6 replaced with ordered Next Steps
  (7 steps); DEC-021 added to decisions summary; downstream sections renumbered 7→9.

**Bitstream impact:** None.

---

## 2026-04-29 — DEC-020 — Design intent, ZCU106 references, and methodology preference captured

**Status:** ACTIVE

**Decision:**
1. Design intent locked: UZEV carrier is a sized-down ZCU106, targeting the same
   functional capabilities except those physically unavailable on the FBVB900E package.
   ZCU106 schematics and power architecture adopted as primary references.
2. ZCU106 references formally added to authoritative sources list in CLAUDE.md.
3. Methodology preference recorded: Python atomic-edit scripts preferred over manual
   KiCad GUI for all schematic edits. Manual GUI is fallback only.

**Source:** User directive 2026-04-29. Confirmed against CLAUDE.md revision.

**Rationale:** Establishes a clear reference baseline for all remaining interface, power,
and peripheral decisions. Eliminates ambiguity when deciding what to implement vs. defer.
Python-script methodology has been empirically validated (DEC-017 Option C).

**Files touched:**
- `CLAUDE.md`: added ## Design intent, ## Methodology preference, ## Reference materials
  sections; updated ## Authoritative sources.
- `transition_docs/TRANSITION_2026-04-29.md`: created as v6 session transition document.
- `zcu106_parity_audit.md`: created — ZCU106 vs. UZEV carrier feature parity audit.
- `BOM_snapshot_20260428_v2.xlsx`: SOM pricing added, FMCOMMS4 marked EXTERNAL/DEV-ONLY.

**Bitstream impact:** None.

---

## 2026-04-27 — DEC-019 — DEF-11 power tree Architecture B adopted

**Status:** ACTIVE

**Decision:** Replace all single-stage LDOs in power.sch with Architecture B:
- B1–B4 (TPS54320, 3A sync buck) + L1–L4 (TPS7A85, 4A LDO) for MGTAVCC/MGTAVTT/VCCO_HP_65/VCCO_HP_64
- B5 (TPS54531, 5A buck, direct to 3.3V) for FMC_3P3V — no LDO
- FMC_3P3V excluded from two-stage: VITA57.1 only requires ±5%, no noise spec; LDO thermal at 5V→3.3V@3A would dissipate 5.1W (exceeds TPS7A85 Tj limit at defense ambient)

**Intermediate pre-reg voltages:**
- MGTAVCC 0.9V: 1.5V intermediate (VMGTAVCC_PRE)
- MGTAVTT 1.2V: 1.8V intermediate (VMGTAVTT_PRE)
- VCCO_HP_65 1.8V: 2.5V intermediate (VVCCO65_PRE)
- VCCO_HP_64 1.8V: 2.5V intermediate (VVCCO64_PRE)

**Sequencing:** SOM_PG_OUT → Buck EN → Buck PG → LDO EN (two-stage gating)

**Source:** TPS54320, TPS54531, TPS7A85, TPS7A84 datasheets; design-to-max from
Avnet UltraZed-EV Designer's Guide Table 33; VITA 57.1 FMC_3P3V noise requirement absent.

**Rationale:** TPS7A85 at 4A/4.4μVrms covers all four noise-sensitive rails with one
part number. TPS54320 at 3A with ≥33% headroom on all rails. Dropping LDO on FMC removes
thermal risk entirely while simplifying BOM.

**Files touched:**
- `UZEV_Connectors.lib`: added Buck_ENPG (5-pin) and LDO_ENPG (5-pin) symbols
  - Script: `add_lib_symbols_def11.py`; post-run size=64245 md5=4c2cf0499241e8e2dbc28cd304ca8162
- `power.sch`: complete rewrite, Rev 1.0→2.0
  - Script: `rewrite_power_sch_def11.py`; post-run size=23959 md5=36675a02ad64a536ff21468faaddae66
  - Removed: U1–U5 (TLV1117-18×2, TLV1117-33, TPS7A4901×2) and associated passives
  - Added: B1–B5 bucks, L1–L4 LDOs, bypass caps per stage, VADJ alias, MGTVCCAUX section

**Bitstream impact:** None (power topology change, no FPGA signal routing affected).

---

## 2026-04-07 17:30 — DEC-001 — GPIO 04/05/09/10 pin-mapping authority

**Decision**: `UZEV_Connectors.lib` is the authoritative source for the four
GPIO pin-to-JX1 mappings. XDC `##` comments and spreadsheet Tab 4 both have
an off-by-one error on these four signals.

| Signal | FPGA Ball | Correct JX1 Pin | (Wrong value in XDC/Sheet) |
|---|---|---|---|
| adrv9009_gpio_04 / HP_DP_27_P | AF12 | **A24** | A25 |
| adrv9009_gpio_05 / HP_DP_27_N | AF11 | **A25** | A26 |
| adrv9009_gpio_09 / HP_DP_25_P | AJ10 | **C24** | C25 |
| adrv9009_gpio_10 / HP_DP_25_N | AK10 | **C25** | C26 |

**Source**: UltraZed-EV Designer's Guide (UGAESZU7EVSOMGV1_2.pdf), Table 26
"JX1 Connector Master Table", pages 32-33. Primary vendor document.
Cross-checked visually by Ravv on 2026-04-07.

**Rationale**: The library symbol agrees with the Designer's Guide (primary
source). The XDC comments and spreadsheet Tab 4 have identical off-by-one
errors, indicating the spreadsheet was the original source of the error and
it propagated into the XDC. The `set_property PACKAGE_PIN` directives in the
XDC use FPGA ball names (AF12/AF11/AJ10/AK10), which are correct — so the
bitstream built from this XDC is physically correct. The error is confined
to human-readable annotations.

**Bitstream impact**: NONE. The bitstream was built against correct ball
names. The board, if wired to match the library, will work with the
existing bitstream.

**Files touched**:
- (pending) `/home/arc/adrv9009_uzev/hdl/projects/adrv9009/zcu102/system_constr.xdc`
  — `##` comments on 4 lines corrected. `set_property` directives NOT changed.
  Backup: `system_constr.xdc.bak.20260407_171827`

**Files NOT touched (known-issue, deferred)**:
- `/home/arc/Transition Docs/March 16, 2026/ADRV9009_UltraZed_EV_Pin_Mapping.xlsx`
  — Tab 4 "PROPOSED MAPPING" has same error in "Assigned JX1 Pin" column for
  these four rows. Not fixed this session because spreadsheet is reference
  documentation, not a build input. Logged for later cleanup.

**Verified by**: V1 cross-check script output (`verified=41/65`, 4 gpio
mismatches); Designer's Guide Table 26 inspection; Ravv confirmation of
HP_DP_27_P at A24/AF12, HP_DP_27_N at A25/AF11, HP_DP_25_P at C24/AJ10,
HP_DP_25_N at C25/AK10.

---
## 2026-04-07 17:45 — DEC-002 — XDC GT lane DP label corrections

**Decision**: The XDC `##` annotations for 10 GT lines (6 unique DP lanes,
P and N each) had wrong DP numbers relative to the VITA 57.1 HPC standard.
Comments corrected; `set_property` directives NOT changed.

Affected ports and corrections:

| XDC Port | FMC Pin | Old DP label (wrong) | New DP label (correct) |
|---|---|---|---|
| rx_data_p[1] | A06 | DP0_M2C_P | **DP2_M2C_P** |
| rx_data_n[1] | A07 | DP0_M2C_N | **DP2_M2C_N** |
| rx_data_p[2] | C06 | DP2_M2C_P | **DP0_M2C_P** |
| rx_data_n[2] | C07 | DP2_M2C_N | **DP0_M2C_N** |
| tx_data_p[0] | A22 | DP0_C2M_P | **DP1_C2M_P** |
| tx_data_n[0] | A23 | DP0_C2M_N | **DP1_C2M_N** |
| tx_data_p[1] | A26 | DP1_C2M_P | **DP2_C2M_P** |
| tx_data_n[1] | A27 | DP1_C2M_N | **DP2_C2M_N** |
| tx_data_p[2] | C02 | DP2_C2M_P | **DP0_C2M_P** |
| tx_data_n[2] | C03 | DP2_C2M_N | **DP0_C2M_N** |

**Source**: ANSI/VITA 57.1-2008 standard, Section "Signal Definitions for
high-pin count connector" (page 48 of the standard). Cross-verified against
Xilinx AC701 User Manual Appendix B and HiTechGlobal FMC module datasheet.
The standard defines:
- DP0: C2/C3 (C2M), C6/C7 (M2C)
- DP1: A22/A23 (C2M), A2/A3 (M2C)
- DP2: A26/A27 (C2M), A6/A7 (M2C)
- DP3: A30/A31 (C2M), A10/A11 (M2C)

The FMC_HPC_ADRV9009 library symbol, the `ADRV9009 FMC Signals` tab of
the pin mapping spreadsheet, and the Sheet 3 global labels ALL agree with
the VITA 57.1 standard. Only the XDC comments were wrong.

**Rationale**: The pin mapping spreadsheet Tab 1 was hand-verified by Ravv
in March 2026 and matches VITA 57.1 exactly. Sheet 3's FMC labels were
generated from the spreadsheet. The library was built to match the
spreadsheet. Only the XDC comments have the error, indicating the author
of the XDC comments got the DP labels confused with the logical lane
ordering (rx_data[0]→DP1, rx_data[1]→DP2, etc.) when writing the
`##` annotations.

**Bitstream impact**: NONE. The `set_property PACKAGE_PIN` directives in
the XDC reference FPGA balls (C4/C3/D2/D1/B2/B1/A4/A3/D6/D5/C8/C7/B6/B5/A8/A7
for data lanes), which are correct. Vivado builds from ball names, not from
comments. The bitstream physically drives the right carrier pins.

**Files touched**:
- `/home/arc/adrv9009_uzev/hdl/projects/adrv9009/zcu102/system_constr.xdc`
  — 10 `##` comments corrected. `set_property` directives unchanged.
  Backups:
    `system_constr.xdc.bak.20260407_171827` (pre-DEC-001)
    `system_constr.xdc.bak.before_comment_fix.20260407_173322` (pre-DEC-001, redundant)
    `system_constr.xdc.bak.before_dec002.<timestamp>` (pre-DEC-002)

**Verified by**: V1b re-verification script — expected 20/20 verified,
0 mismatches after fix. VITA 57.1 standard excerpt from ANSI publication.

---

---

## 2026-04-08 13:49 — DEC-003 — FMC_HPC_ADRV9009 power/control pin rename

**Decision**: Rename 29 non-GND, non-signal pins in the `FMC_HPC_ADRV9009`
symbol of `UZEV_Connectors.lib` from placeholder `Pin_<n>` names to their
authoritative VITA 57.1 signal names.

**Scope**: 15 power pins + 14 state-flag / JTAG / I2C / geographic-address /
reserved pins. GND pins (159) intentionally left as `Pin_<n>` placeholders —
ERC matches nets by name, not pin name, so GND naming is cosmetic and will
be resolved implicitly during V5 wire-up when GND nets are tied.

**Rename table (pin_number → pin_name)**:

| Signal | Pin(s) | Count | Category |
|---|---|---|---|
| VREF_B_M2C | K1 | 1 | Reference |
| VREF_A_M2C | H1 | 1 | Reference |
| PG_M2C | F1 | 1 | State flag |
| PG_C2M | D1 | 1 | State flag |
| RES1 | B1 | 1 | Reserved |
| PRSNT_M2C_L | H2 | 1 | State flag |
| TCK | D29 | 1 | JTAG |
| TDI | D30 | 1 | JTAG |
| SCL | C30 | 1 | I2C |
| TDO | D31 | 1 | JTAG |
| SDA | C31 | 1 | I2C |
| 3P3VAUX | D32 | 1 | Power |
| TMS | D33 | 1 | JTAG |
| TRST_L | D34 | 1 | JTAG |
| GA0 | C34 | 1 | Geographic |
| GA1 | D35 | 1 | Geographic |
| 12P0V | C35, C37 | 2 | Power |
| 3P3V | C39, D36, D38, D40 | 4 | Power |
| VIO_B_M2C | J39, K40 | 2 | Power |
| VADJ | E39, G39, F40, H40 | 4 | Power |
| RES0 | B40 | 1 | Reserved |
| **Total** | | **29** | |

**Source**: ANSI/VITA 57.1-2008 (FMCAV57DOT1.pdf in project knowledge),
specifically:
- **Table 2, page 49** — Signal Definitions for high-pin count connector
  (authoritative for every pin position)
- **Rule 5.95, page 70** — "A total of four pins shall be allocated to VADJ
  supply voltage on the high pin count connector"
- **Rule 5.97, page 70** — "A total of four pins shall be allocated to 3P3V
  supply voltage"
- **Rule 5.98, page 70** — "A total of two pins shall be allocated to 12P0V
  supply voltage"
- **Table 11, page 69** — Power Supply Voltages for HPC connector (confirms
  3P3VAUX=1, VIO_B_M2C=2, VREF_A_M2C=1, VREF_B_M2C=1, plus above)

Power pin counts (VADJ=4, 3P3V=4, 12P0V=2, 3P3VAUX=1, VIO_B_M2C=2,
VREF_A_M2C=1, VREF_B_M2C=1) sum to 15, matching Xilinx UG1182's "15 power
connections" for ZCU102 J5 HPC0.

**Rationale**: Sheet 2 (`power.sch`) contains global labels targeting the
FMC connector (`FMC_3P3V`, `VADJ`) that currently have no matching pin
names in the library symbol because the pins were placeholder `Pin_<n>`.
This rename closes that gap and aligns the symbol with the authoritative
pin assignments, which is required for V5 (Sheet 1 wire-up) to find matches
between global labels and J4 connector pins.

Separately, the scope was expanded beyond just power pins to also include
state flags, JTAG, I2C, geographic address, and reserved pins because the
same script mechanism applies, all positions come from the same Table 2,
and pre-emptively naming them avoids revisiting the symbol for future
scope items.

**Files touched**:
- `/home/arc/projects/uzev_carrier_v5/UZEV_Connectors.lib`
  - Modified: 29 pin lines within the `FMC_HPC_ADRV9009` DEF block
  - Backup: `UZEV_Connectors.lib.bak.before_dec003.20260408_134904`
- `/home/arc/projects/uzev_carrier_v5/step2c_add_fmc_power_pins.py`
  - New file, preserved for reproducibility

**Verified by**:
1. Pre-flight: all 29 target pin_numbers found in symbol, each still in
   placeholder state (`Pin_<n>` pattern) before rename
2. Post-flight: all 29 renames applied, total pin count unchanged at 400,
   each pin_name verified to equal the target after write-back
3. Diff: exactly 29 lines changed; line geometry (coordinates, unit, type)
   byte-identical outside the name field
4. Existing V1+V1b verification (XDC ↔ library chain) re-run: 65 verified,
   0 mismatches — Step 2 / DEC-001 / DEC-002 work unaffected
5. Count-per-signal audit matches Rules 5.95/5.97/5.98 and Table 11 exactly

**Known follow-up**: Sheet 2 currently uses label name `FMC_3P3V` while the
library now uses the VITA-standard name `3P3V`. This mismatch will be
resolved in V5 by renaming the Sheet 2 labels (preferred direction: match
the standard). This is a documentation-layer fix, not a library fix.

---

## 2026-04-08 14:00 — DEC-004 — VIN pin list on JX1 (power.sch comment fix)

**Decision**: The authoritative VIN pin list for JX1 is 8 pins: A43, A46,
A49, A50, B44, B47, B50, C50. The `power.sch` line 27 comment previously
listed 12 pins (adding phantom B43, B46, B49, D50) and has been corrected.
The `UZEV_Connectors.lib` JX1 symbol was already correct — no library
change needed.

**Source**: Avnet UltraZed-EV Designer's Guide (UGAESZU7EVSOMGV1_2.pdf in
project knowledge), **Table 26 – JX1 Connector Master Table**, spanning
pages 32 and 33. Direct extraction from the table:

- Page 33 (A and B columns, rows 38-50):
  - A43=VIN, A46=VIN, A49=VIN, A50=VIN
  - B44=VIN, B47=VIN, B50=VIN
- Page 32 (C and D columns, rows 38-50):
  - C50=VIN
  - (D50 is SYSMON_V_P, not VIN)

Total: 8 VIN pins on JX1. Cross-confirmed by `Table 32 – UltraZed-EV SOM
Voltage Rails` on page 42, which lists `+VIN 5V or 12V` with `JX1` as the
only source connector.

**Why the old comment was dangerous**: The four phantom pins (B43, B46,
B49, D50) are assigned to real SOM-side signals per Table 26:
- B43 = HP_DP_46_N (PL bank differential pair, AH1)
- B46 = HP_SE_01 (PL single-ended, AG19)
- B49 = HP_SE_03 (PL single-ended, AC19)
- D50 = SYSMON_V_P (system monitor analog input, T15)

If the Sheet 1 wire-up in V5 had been driven from the old comment rather
than the library, VIN (5V or 12V) would have been shorted to four
PL-side signals on the SOM. This would have destroyed the FPGA I/O banks
and possibly the SYSMON ADC on first power-up. Resolving this before V5
is the reason V3 existed as a gating task.

**Three-way reconciliation result**:

| Source | VIN count | Status |
|---|---|---|
| `power.sch` line 27 (pre-DEC-004) | 12 | Wrong — 4 phantom pins |
| `UZEV_Connectors.lib` JX1 symbol | 8 | Correct (unchanged) |
| Designer's Guide Table 26 (pp32-33) | 8 | Authoritative |

**Files touched**:
- `/home/arc/projects/uzev_carrier_v5/power.sch`
  - Modified: line 27 comment text only; no component, wire, label, or
    junction changes
  - Backup: `power.sch.bak.before_dec004.*`

**Verified by**:
1. Library JX1 VIN pin inventory (8 pins at A43, A46, A49, A50, B44, B47,
   B50, C50) matches Designer's Guide Table 26 byte-for-byte
2. Pre-edit: old comment text found exactly once in power.sch; pre-flight
   refused to write if it appeared zero or multiple times
3. Post-edit: diff shows exactly one line changed; grep confirms no
   residual "B43,B44" substrings remain anywhere in the file
4. No library modification required — existing library was already
   authoritative

**No follow-up needed** — V3 is complete.

---

## 2026-04-08 14:25 — DEC-005 — JESD label tie strategy on Sheet 3

**Decision**: Tie the 16 FMC-side JESD labels to their 16 logical-lane
counterparts on Sheet 3 with short horizontal wire segments, preserving
both naming conventions on the schematic for documentation value.

**Strategy**: A (wire-tie, both names visible). Rejected alternatives:
B1/B2 (rename one set — loses information), C (hybrid names — ugly and
nonstandard).

**Source**: Physical lane mapping from DEC-002 (XDC ↔ VITA 57.1 HPC pin
assignments, cross-checked against library FMC_HPC_ADRV9009 symbol).
Label positions were pre-aligned by whoever laid out Sheet 3: every FMC
label is at x=1500 and its logical counterpart at x=2700, same Y, making
a clean 1200-mil horizontal wire the obvious tie.

**16 wire ties added** at Y = 5100, 5300, 5700, 5900, 6300, 6500, 6900,
7100 (M2C/rx block) and 7700, 7900, 8300, 8500, 8900, 9100, 9500, 9700
(C2M/tx block). Each wire: `1500 Y  2700 Y`.

**Files touched**:
- `adrv9009_signals.sch` — 16 Wire Wire Line entries appended before
  `$EndSCHEMATC`; label positions, components, and existing wires
  unchanged.
- Backup: `adrv9009_signals.sch.bak.before_dec005.*`

**Verified by**:
1. Pre-flight: script refused to write if prior wire tie was present
2. Post-flight: wire count 57 → 73 (+16); label count 130 unchanged
3. Diff localized to wire additions only; no component or label edits
4. Script independent of line numbering — uses `$EndSCHEMATC` anchor

**No follow-up needed** — V4 is complete.

---

## DEC-006 — Sheet 1 J2/J3 reference label swap

**Date**: 2026-04-09 14:26 (fix applied); 2026-04-13 logged

**Decision**: Fix the J2/J3 reference labels on `connectors.sch` to match
Avnet convention (J1=JX1, J2=JX2, J3=JX3, J4=FMC).

**Discovery**: V5 Phase 2 coordinate computation revealed that the
component labeled `J2` on Sheet 1 was instantiating the JX3 (120-pin)
library symbol, while `J3` was instantiating the JX2 (200-pin) symbol.
This was pre-existing state — the swap predates V1 and came into the
April 8 session already wrong. Physical net routing was correct (each
instance pointed at the right library symbol), but the reference labels
were swapped relative to Avnet convention used in the Designer's Guide,
DECISIONS_LOG, prior transition documents, and downstream PCB footprint
assignment.

**Fix**: 16 line edits to `connectors.sch`:
- 4× `L UZEV_Connectors:SEAF-40-...JX2 J3` → `... J2`
- 4× `F 0 "J3"` (in JX2 component blocks) → `F 0 "J2"`
- 4× `L UZEV_Connectors:SEAF-30-...JX3 J2` → `... J3`
- 4× `F 0 "J2"` (in JX3 component blocks) → `F 0 "J3"`

Script walked each `$Comp` block and rewrote both the `L` line's ref
token and the `F 0` line's quoted ref based on which library symbol the
block instantiated. Library symbol names untouched.

**Files touched**:
- `connectors.sch` — 16 line edits, no other changes
- Backup: `connectors.sch.bak.before_p25_jswap.20260409_142633`

**Verified by**:
1. Ref distribution: J1=4, J2=4, J3=4, J4=10 = 22 components
2. Each `L` line matches Avnet convention: J1↔JX1, J2↔JX2, J3↔JX3, J4↔FMC
3. Each `F 0` field matches its `L` line's ref
4. Python L/F0 consistency check confirmed all 22 matching pairs
5. Diff localized to 16 ref-token swaps — no nets, positions, symbols touched

---

## DEC-007 — Sheet 3 topology fix: misplaced labels + missing pairs + 47 tie wires

**Date**: 2026-04-13 12:41

**Decision**: Fix Sheet 3 (`adrv9009_signals.sch`) so every FMC↔SOM pair
used by the design is correctly labeled and wire-tied, matching the
authoritative spreadsheet (`ADRV9009_UltraZed_EV_Pin_Mapping.xlsx`,
PROPOSED MAPPING tab).

**Discovery**: An external audit flagged a "CRIT-1" Sheet 3 label
correctness bug. Independent verification revealed:

1. The audit's CRIT-1 table was generated from stale `Text Notes`
   annotations on Sheet 3 (80 text notes referencing signal names from
   pre-V1 design states), not from the actual global label set. The
   audit conflated text notes with pin assignments. CRIT-1 and CRIT-1a
   as framed were non-findings.
2. However, the underlying concern was real: of 49 orphan FMC labels
   paired geometrically with 49 orphan HP_DP labels at the same Y
   coordinates (ΔX=1200 for GT, ΔX=1400 for LVDS), **22 HP_DP labels were
   positionally wrong** relative to their spreadsheet-mapped FMC partner.
3. **3 LA pairs were missing entirely** from Sheet 3: LA14 (C18/C19 →
   tx2/rx2_enable), LA18_CC (C22/C23 → gpio_06/07), LA26 (D26/D27 →
   ad9528_reset_b/sysref_req). Their corresponding HP_DP nets
   (HP_DP_31/45/47) were also absent.
4. **No wire ties existed** for any of the 41 non-GT-data orphan pairs.
   Only the 16 GT data lane ties from DEC-005 were present.

**Fix**: Single-pass rewrite of `adrv9009_signals.sch`:

- **34 label renames** (6 FMC + 28 HP_DP):
  - 6 FMC slot repurposes: LA05→LA14, LA10→LA18_CC, LA23→LA26
    (reuses existing label geometry for the 3 missing pairs)
  - 22 HP_DP misplacement fixes (rename-in-place per spreadsheet truth)
  - 6 HP_DP labels in the repurposed slots renamed to match new FMC partners
- **4 label deletions** (LA28 pair + its HP_DP_38 partners) — LA28
  unused and not needed
- **47 new tie wires** emitted just before `$EndSCHEMATC`:
  - 43 LVDS pairs (one per signal in SS_BY_LA)
  - 4 GT REFCLK pairs (GBTCLK0/1 M2C → GTH_REFCLK0/1)

**Files touched**:
- `adrv9009_signals.sch` — 670 → 756 lines, 19328 → 20986 bytes
- Backup: `adrv9009_signals.sch.bak.before_dec007.20260413_124107`

**Verified by** (post-apply topology verification script):
1. Labels: 130 → 126 (−4 from LA28 pair + HP_DP_38 pair deletions)
2. Wires: 73 → 120 (+47 new ties)
3. FMC↔SOM connected components: **63 pairs** (16 GT data from DEC-005
   + 4 GT REFCLK new + 43 LVDS new)
4. Orphan FMC: 0, Orphan SOM: 0, Multi-SOM anomalies: 0
5. HP_DP missing vs spreadsheet: 0 — all 43 used HP targets present
6. HP_DP extra: 0 — no unused HP_DP labels remain on the sheet
7. Rename target uniqueness confirmed (34 renames, all unique)
8. Delete/rename disjoint (no line edited and deleted)
9. `$EndSCHEMATC` terminator preserved (exactly 1 occurrence)
10. Atomic write via `.tmp` + `os.replace()`

**Audit lesson**: The external audit was generated by a different
agent reading Sheet 3 and making claims about signal-to-pin mappings
that cannot be verified against the actual global label set. Its
CRIT-1 table listed signal names (`ad9528_reset_b`, `gpio_00`, etc.)
that never existed as global labels on Sheet 3 — only as stale text
notes. Project policy going forward: audits from other models are
treated as hypotheses, not findings, until independently verified
against primary sources (KiCad file parse + spreadsheet).

**Text note cleanup deferred**: The 80 stale `Text Notes` on Sheet 3
still reference pre-V1 signal names (hmc7044_sync, adrv9009_gpint1/2,
ad9528_status, etc.). Per session Decision 3, these are left alone as
harmless visual documentation. They do not affect netlist generation
or ERC.

---

## DEC-008 — XDC comment typo fix for gpio_04/05/09/10

> **INVALIDATED 2026-04-13 — see DEC-009**
>
> This decision was based on the erroneous assumption that the pin mapping
> spreadsheet was authoritative. Independent verification against the
> Designer's Guide Table 26 (pp 32-33) confirmed that DEC-001's original
> values (A24/A25/C24/C25) are correct and the spreadsheet has an
> off-by-one error on these four pins. The XDC edits made in DEC-008 have
> been reverted. See DEC-009 for the full investigation.

**Date**: 2026-04-13 12:41

**Decision**: Correct the JX pin annotations in four XDC comment lines
for `adrv9009_gpio_04`, `_05`, `_09`, `_10`. The comments said
`JX1.A24/A25/C24/C25` when the spreadsheet and library agree the correct
values are `JX1.A25/A26/C25/C26`.

**Discovery**: During CRIT-1 verification against the pin mapping
spreadsheet, it was found that the four GPIO lines in DEC-001 have the
**FPGA ball correct** (AF12/AF11/AJ10/AK10) but the JX pin **comment**
wrong by one position. The bitstream uses PACKAGE_PIN and is unaffected
— this is a cosmetic/documentation error only. It originated in the
DEC-001 transition doc narrative text and was copied verbatim into the
XDC comment annotations.

**Impact**: None on bitstream behavior. Vivado ignores comments. The
four affected signals route to the correct FPGA balls, which map to the
correct SOM HP_DP nets, which match Sheet 3 and the spreadsheet. The
typos only misled human readers (including the external audit, which
incorrectly passed DEC-001 based on XDC↔library FPGA ball agreement
without checking the JX comment).

**Fix**: 4 single-character edits to `system_constr.xdc` comments:
- `adrv9009_gpio_04` comment: `JX1.A24` → `JX1.A25`
- `adrv9009_gpio_05` comment: `JX1.A25` → `JX1.A26`
- `adrv9009_gpio_09` comment: `JX1.C24` → `JX1.C25`
- `adrv9009_gpio_10` comment: `JX1.C25` → `JX1.C26`

**Files touched**:
- `system_constr.xdc` — 4 byte-equivalent edits in comments, zero
  semantic change
- Backup: `system_constr.xdc.bak.before_dec008.20260413_124107`

**Verified by**:
1. Grep pattern for `gpio_(04|05|09|10).*JX1\.` shows all four with
   corrected pin numbers
2. Comment cross-check vs spreadsheet: 45 XDC lines checked, 45 correct
   (was 41 correct + 4 wrong)
3. No PACKAGE_PIN or IOSTANDARD values changed — bitstream remains
   byte-identical to the current build

**No follow-up needed** — DEC-001 is now fully correct.

---

## 2026-04-13 13:00 - DEC-009 - DEC-008 invalidated; Designer's Guide is authoritative

**Decision**: Invalidate DEC-008. Revert the XDC comment edits it made.
Reaffirm DEC-001 as the authoritative decision for the four GPIO pin
annotations. Document the spreadsheet error as known deferred cleanup.

**Discovery**: During session continuation on 2026-04-13, verification
after applying DEC-008 revealed an internal inconsistency: DEC-008 had
edited the XDC comments to values (A25/A26/C25/C26) that directly
contradicted DEC-001 (A24/A25/C24/C25). Both entries claimed derivation
from the Designer's Guide Table 26.

Root cause: DEC-008 was proposed based on the `ADRV9009_UltraZed_EV_Pin_Mapping.xlsx`
PROPOSED MAPPING tab, which was treated as authoritative without checking
against primary sources. The spreadsheet has an off-by-one error on these
four pin positions - which DEC-001 had already identified on 2026-04-07
and flagged as a deferred cleanup item.

**Primary source verification**: Direct visual inspection of
`UGAESZU7EVSOMGV1_2.pdf` pages 32-33 (Table 26 - JX1 Connector Master
Table). Row-by-row reading confirms:

| Signal | JX1 pin | Zynq ball | Source |
|---|---|---|---|
| HP_DP_27_P | A24 | AF12 | DG Table 26, p33, B24/A24 row |
| HP_DP_27_N | A25 | AF11 | DG Table 26, p33, B25/A25 row |
| HP_DP_25_P | C24 | AJ10 | DG Table 26, p32, D24/C24 row |
| HP_DP_25_N | C25 | AK10 | DG Table 26, p32, D25/C25 row |

**Library cross-check**: `UZEV_Connectors.lib` JX1 symbol
(SEAF-40-05.0-S-10-2-A-K-TR_JX1) agrees with Designer's Guide exactly:
```
  pin_num A24 : HP_DP_27_P
  pin_num A25 : HP_DP_27_N
  pin_num C24 : HP_DP_25_P
  pin_num C25 : HP_DP_25_N
```

**Spreadsheet error confirmed**: `ADRV9009_UltraZed_EV_Pin_Mapping.xlsx`
PROPOSED MAPPING tab has these four rows wrong (A25/A26/C25/C26). The
error is present across all three tabs (ADRV9009 FMC Signals, JX
Available Pins, PROPOSED MAPPING), which is why internal spot-checks
within the spreadsheet could not detect it. Internal consistency is not
evidence of correctness; it can be evidence of a consistent error.

**Authority chain reaffirmed**:
1. Designer's Guide Table 26 (primary vendor document)
2. UZEV_Connectors.lib (matches Designer's Guide exactly)
3. system_constr.xdc PACKAGE_PIN values (correct; comments also correct
   after this rollback)
4. Spreadsheet is reference documentation only - known to contain the
   four-pin error, not fixed because the build uses library/XDC

**Files touched**:
- `system_constr.xdc` - restored from `system_constr.xdc.bak.before_dec008.20260413_125031`
  (byte-identical to pre-DEC-008 state, md5 verified)
- `DECISIONS_LOG.md` - DEC-008 marked INVALIDATED in place; this DEC-009
  entry appended
- Pre-rollback wrong state preserved at `system_constr.xdc.bak.before_dec009_rollback.20260413_133745`
  for audit trail

**Verified by**:
1. MD5 hash of restored XDC matches pre-DEC-008 backup exactly
2. Four GPIO lines now contain correct JX1 pin annotations (A24/A25/C24/C25)
3. PACKAGE_PIN values unchanged (AF12/AF11/AJ10/AK10) - bitstream
   remains byte-identical to existing build
4. Sheet 3 (DEC-007) is unaffected: its label renames used HP_DP net
   names, not JX pin numbers, and the library's HP_DP net names agree
   with the Designer's Guide

**Lesson applied**: Before proposing an edit that contradicts an existing
DEC entry, the existing DEC must be verified against primary sources
first, not assumed stale. Primary sources (Designer's Guide, library)
take precedence over derived artifacts (spreadsheet) when they disagree.

**Spreadsheet cleanup deferred**: The spreadsheet error remains unfixed,
consistent with DEC-001's original decision. Build inputs are correct;
the spreadsheet is reference documentation only.

## 2026-04-13 15:35 — DEC-010 — FMC library completeness fix (6 pin renames)

**Status:** VALID

**Context:** V5 Phase 2 (stub coordinate computation) found 6 unmapped labels
on Sheet 3: FMC_C18_LA14_P, FMC_C19_LA14_N, FMC_C22_LA18_CC_P,
FMC_C23_LA18_CC_N, FMC_D26_LA26_P, FMC_D27_LA26_N. Root cause: the
FMC_HPC_ADRV9009 library symbol had Pin_<num> placeholders for these 6
mechanical FMC pins that Sheet 3 actively uses (added by DEC-007).

**Change:** Renamed 6 pins in UZEV_Connectors.lib (in place, coordinates and
unit assignments unchanged):

| Line | Mech pin | Old name | New name |
|---|---|---|---|
| 1513 | C18 | Pin_18 | FMC_C18_LA14_P |
| 1514 | C19 | Pin_19 | FMC_C19_LA14_N |
| 1518 | C22 | Pin_22 | FMC_C22_LA18_CC_P  |
| 1519 | C23 | Pin_23 | FMC_C23_LA18_CC_N  |
| 1562 | D26 | Pin_26 | FMC_D26_LA26_P |
| 1563 | D27 | Pin_27 | FMC_D27_LA26_N |

**Verified by:** ANSI/VITA 57.1-2008 Table 3 (LPC connector pin assignments,
PDF page 50 in FMCAV57DOT1.pdf). C/D column assignments are identical between
the LPC (Table 3) and HPC (Table 2) connectors — only the H bank rows differ.
Direct visual inspection of the table image confirmed:

- C18 = LA14_P, C19 = LA14_N
- C22 = LA18_P_CC, C23 = LA18_N_CC
- D26 = LA26_P, D27 = LA26_N

The naming convention `LA<n>_CC_<PN>` (CC suffix before P/N) matches the
existing library convention for LA00_CC and LA01_CC pins (FMC_G06_LA00_CC_P,
FMC_D08_LA01_CC_P, etc).

**Verification:** V5 Phase 2 re-ran post-edit with the following results:
- 175 total stubs (was 169; +6 new on J4)
- 0 unmapped labels (was 6)
- J1=64, J2=34, J3=6, J4=71
- All 8 multi-drop sanity checks OK (VIN=8, MGTAVCC=6, MGTAVTT=6,
  MGTVCCAUX=2, VCCO_HP_64=3, VCCO_HP_65=3, FMC_3P3V=4, VADJ=4)

**File hashes (post-edit):**
- UZEV_Connectors.lib: size=63497, md5=54f0444e3da6ff4f5b11c23de9ca7413

**Backup:** UZEV_Connectors.lib.bak.before_dec010.20260413_154959

**Bitstream impact:** None. This edit affects only the carrier-board KiCad
library; the HDL/XDC and built bitstream are unchanged.

## 2026-04-13 16:15 — DEC-011 — V5 Phase 3: stub emission to connectors.sch

**Status:** VALID

**Context:** Sheet 1 (connectors.sch) was placement-only with no wires or labels. To make the SOM↔FMC↔support-IO signals routable, every global label used on Sheets 2/3/4 needs a corresponding wire stub + GLabel on the matching connector pin in Sheet 1. V5 Phase 3 automates this from the v5_phase2_stubs.tsv produced by Phase 2.

**Change:** Appended 175 wire+label pairs to connectors.sch, before $EndSCHEMATC. Each stub consists of:
- A `Wire Wire Line` segment from the pin tip extending 200 mil outward (in the pin's orient direction).
- A `Text GLabel` of type BiDi, size 50, at the wire's outer end, with the original pre-alias label name.

Pin tip coordinates and orientations come from v5_phase2_stubs.tsv (Phase 2 output, 175 rows, 0 unmapped).

**Stub geometry rules (verified empirically against J1 unit 3 + CC_RESET_OUT_N):**
- Library `lx,ly` is the pin's connection point (tip), pin length 200 mil.
- Library `R` orient: tip on left of body, wire extends −X (label orient 2 = left).
- Library `L` orient: tip on right of body, wire extends +X (label orient 0 = right).
- Sheet matrix `(1,0,0,-1)` Y-flips lib coords; X direction unchanged, so orient semantics carry through unchanged.

**Distribution:**
- 51 L-pin stubs (label on right)
- 124 R-pin stubs (label on left)
- 175 total wires + 175 total GLabels

**Verification:**
- `grep -c '^Wire Wire Line' connectors.sch` = 175 ✓
- `grep -c '^Text GLabel' connectors.sch` = 175 ✓
- File grew from 9332 to 25792 bytes (delta 16460) ✓
- $EndSCHEMATC marker still present at end ✓
- Visual check in KiCad 5.1.5 GUI (Phase 4): J1 unit 1, J2 unit 4, J4 spot checks, and DEC-010 new pins (FMC_C18/C19/C22/C23/D26/D27) all present and correctly placed. No wires inside symbol bodies, no obvious orientation errors. Initial concern about HP_DP_03/07 P/N suffix turned out to be a GUI misread — those signals are not in the Phase 3 stub list at all (verified by grep returning 0 matches).

**File hashes (post-edit):**
- connectors.sch: size=25792, md5=1b4d5dffe37080d0d354bf38651d370b

**Backup:** connectors.sch.bak.before_dec011_phase3.20260413_161315

**Bitstream impact:** None. Sheet 1 of carrier-board KiCad project only.

## 2026-04-14 — DEC-012 — connectors.sch cosmetic re-save (KiCad GUI)

**Status:** VALID

**Context:** Session-start diagnostic at start of 2026-04-14 v5 session detected a hash/size drift on connectors.sch relative to the v4 transition doc's recorded baseline:

- v4 baseline: size=25792 md5=1b4d5dffe37080d0d354bf38651d370b
- Current:     size=26684 md5=d36815269777a61e1a9030e75d7c961e
- Delta: +892 bytes

All other tracked files (UZEV_Connectors.lib, power.sch, support_io.sch, system_constr.xdc) matched v4 hashes exactly. No scripted edits in the backup history between DEC-011 (2026-04-13 16:13) and now. The only plausible cause is a KiCad 5.1.5 eeschema GUI re-save that occurred when the ERC run in v4 Section 4.3 opened the project.

**Investigation:** Structural parse of current connectors.sch:
- 22 components
- 175 Wire Wire Line segments (matches DEC-011 Phase 3 output)
- 175 Text GLabel entries (matches DEC-011 Phase 3 output)
- 0 junctions, 0 noconns
- $Descr block intact: Date="2026-03-19", Rev="1.0", Title="Sheet 1: Connectors" — unchanged from DEC-011 era
- J1 first component at (2500, 6000), timestamp 5F000005 — unchanged
- $EndSCHEMATC present at end of file

Label prefix histogram matches expected DEC-011 emission exactly:
FMC=67, HP=43, VIN=8, rx=8, tx=8, VCCO=7, MGTAVCC=6, MGTAVTT=6, VADJ=4, GTH=4, CC=4, JTAG=4, MIO=2, SOM=2, MGTVCCAUX=2. Total = 175.

DEC-011 spot-checks all pass (CC_RESET_OUT_N=1, HP_DP_03=0, HP_DP_25_P=1, HP_DP_27_N=1, FMC_3P3V=4, VIN=8, VCCO_HP_64=3, VCCO_HP_65=4, MGTAVCC=6, MGTAVTT=6, MGTVCCAUX=2).

Electrical fingerprint (md5 of sorted canonical structural content): a2e49504c610019069b15220661624a0

**Decision:** Accept the re-serialized file as the new baseline. No electrical content changed. The +892 bytes are attributable to KiCad 5.1.5 field-flag, whitespace, and coordinate normalization on GUI save. Nothing was lost, nothing was added.

**Policy going forward:** the session-end procedure should now include explicitly saving all sheets in KiCad and committing the post-save hashes as the reference baseline, so that future sessions are not surprised by GUI re-save artifacts. Audit v5 will use the post-DEC-012 hashes.

**Lesson (reinforced):** a hash mismatch is always suspicious but not always bad. The correct response is structural parse first, not reflexive restore from backup. The DEC-007 lesson ("audits from other models are hypotheses, not findings") applies to hash-based audits too: a byte-for-byte mismatch is a finding about bytes, not about electrical correctness.

**Lesson (new):** cat heredoc writes to /tmp can double-execute. This cost us one full round of rework. Going forward, use python write-file for /tmp snippets, never cat heredoc.

**Backup created:** connectors.sch.bak.before_dec012.20260414_145112

**New baseline hash:**
- connectors.sch: size=26684 md5=d36815269777a61e1a9030e75d7c961e

**Bitstream impact:** None. Carrier-board KiCad project only.

## 2026-04-14 — DEC-013 — Phase 5b pre-work: Q1-Q6 verified, DEF-11 opened, option γ approved

**Status:** VALID

**Context:** Beginning of Phase 5b (power.sch wire-up). Session-start diagnostic resolved DEC-012 (cosmetic connectors.sch re-save). Before writing any wires, the next step was answering six open design questions (Q1-Q6 from v4 transition doc Section 7.2) about LDO rail assignments, MGTVCCAUX topology, VADJ source, EN routing, GND topology, and PWR_FLAG policy. User provided three screenshots of power.sch showing the existing design notes and LDO blocks, which turned out to contain authoritative design intent for every question. User also uploaded three LDO datasheets (ADP7104.pdf, tlv1117.pdf, tps7a49.pdf) to project knowledge for primary-source verification of part claims from v2 memory.

**Q1-Q6 answers (verified from power.sch Design Notes block):**
- Q1a: U1=VCCO_HP_65 (1.8V), U2=VCCO_HP_64 (1.8V), U3=FMC_3P3V (3.3V), U4=MGTAVCC (0.9V), U5=MGTAVTT (1.2V). Matches v4 Section 4.5 inference exactly.
- Q1b: Declared parts per sheet annotations: U1/U2 = TLV1117-18 or AP2112K-1.8; U3 = TLV1117-33; U4/U5 = TPS7A4901 or ADP7104. Every declared part is inadequate — see DEF-11 below.
- Q2: MGTVCCAUX = direct short to VCCO_HP_65. No ferrite bead, no separate LDO. Decoupling via C15 4.7uF + C16 100nF. Design Note 4.
- Q3: VADJ = VCCO_HP_65, hardwired 1.8V fixed. VADJ and VCCO_HP_65 are the same net electrically. Design Note 3. VITA 57.1 Permission 5.12 allows this for closed systems.
- Q4: All five LDO EN pins tied to SOM_PG_OUT. Matches Avnet reference carrier (UGAESZU7EVSOMGV1_2 Figure 16). Design Note 1. DEF-2 (MGT rail sequencing) is RESOLVED by design — single SOM_PG_OUT gate handles all rails; no per-rail PGOOD daisy-chain needed.
- Q5: Single global GND net (power:GND). Matches SOM topology per Designer's Guide. No split planes.
- Q6: 6 PWR_FLAGs needed: VIN (barrel jack output), VCCO_HP_65 (U1 out), VCCO_HP_64 (U2 out), FMC_3P3V (U3 out), MGTAVCC (U4 out), MGTAVTT (U5 out). VADJ and MGTVCCAUX are shared with VCCO_HP_65 — no separate flags. Delete the 2 existing floating flags and place 6 new ones on actual wire endpoints.

**Primary-source datasheet verification (2026-04-14):**

ADP7104 Rev L (Feb 2026, analog.com) — VERIFIED:
- Title page: "20 V, 500 mA, Low Noise, CMOS LDO"
- Maximum output current: 500 mA (all package and voltage variants)
- Current limit foldback: typ 775 mA, max 1000 mA
- Packages: 8-lead LFCSP (3x3mm), 8-lead SOIC only. No 2A variant exists.
- Has EN/UVLO pin (pin 5), has PG pin (pin 7), has exposed pad
- Input range: 3.3V to 20V
- v2 memory claim "ADP7104ARDZ (2A)" is CONCLUSIVELY FALSE.

TLV1117 Rev O (June 2025, ti.com) — VERIFIED:
- Title: "15V, 800mA, Adjustable and Fixed Linear Voltage Regulator"
- Output current: 800 mA max
- Input voltage range: 2.7V to 15V recommended, 16V absolute max
- CRITICAL: cannot accept 12V input with any margin. A 12V nominal barrel jack that spikes to 15V+ exceeds absolute max.
- NO ENABLE PIN. 3-pin part (ADJ/GND, IN, OUT) plus NC in some packages. "Tie EN to SOM_PG_OUT" design intent is non-physical with this part.
- SOT-223 thermal: theta-JA = 95.4 degC/W. At 12V to 1.8V, 800mA dissipates 8.16W. Tj would exceed 800 degC. Realistic thermal-limited current in SOT-223 is ~100 mA at 12V to 1.8V.
- Dropout: 1.2V typ, 1.3V max at 800 mA (new chip). Massive dropout even at low currents.

TPS7A49 Rev E (May 2015, ti.com) — VERIFIED, and EARLIER CLAIM CORRECTED:
- Title: "36-V, 150-mA, Ultralow-Noise, Positive Linear Regulator"
- Output current: 150 mA max (NOT 1A as I stated earlier in this session, and NOT 1A as v2 memory claimed).
- Input range: 3V to 36V. Handles 12V easily.
- Adjustable ONLY: Vout range 1.194V to 33V. No fixed-voltage variants. Requires external resistor divider.
- HAS enable pin (pin 5), HAS NR/SS pin, HAS exposed pad
- HVSSOP PowerPAD (DGN) or VSON (DRB), both 3x3mm
- v2 memory claim "TPS7A4901 (1A) is insufficient" is WRONG twice over: (1) it is 150 mA, not 1 A, (2) the proposed "upgrade" ADP7104 at 500 mA is better but still nowhere near 1.8/2.0 A requirement.

**SOM current requirements (from UGAESZU7EVSOMGV1_2 Table 33):**
- VCCO_HP_64: 1.5 A
- VCCO_HP_65: 1.5 A
- MGTAVCC: 1.8 A
- MGTAVTT: 2.0 A
- MGTVCCAUX: 0.05 A
- FMC_3P3V: 3.0 A per VITA 57.1 Table 11 (for compatibility)

**Power dissipation math at 12V input (thermal reality check):**
- VCCO_HP_65 at 1.5A: (12-1.8)*1.5 = 15.3 W dissipation in the LDO
- VCCO_HP_64 at 1.5A: same 15.3 W
- FMC_3P3V at 3.0A: (12-3.3)*3.0 = 26.1 W
- MGTAVCC at 1.8A: (12-0.9)*1.8 = 20.0 W
- MGTAVTT at 2.0A: (12-1.2)*2.0 = 21.6 W
- Total worst-case LDO dissipation: ~98 W. Impossible in any standard IC package without heatsinking the size of a coffee mug. Board would need 100W+ of thermal dissipation as heat from linear regulation alone.

No linear regulator at any package size from any manufacturer can do this. The architecture — direct 12V to rail LDO — is fundamentally unsuitable regardless of part selection. This is a design-level defect, not a part-selection defect.

**DEF-11 — OPENED (HIGH PRIORITY, BLOCKS PCB LAYOUT):**
Power tree on power.sch is architecturally unsound. Phase 5c (new) must redesign before PCB fabrication. Candidate architectures:
(A) Two-stage: 12V buck to 5V intermediate then LDOs for all rails. Reduces LDO dissipation by ~60%.
(B) Three-stage with rail-specific intermediates: 12V buck to 5V then LDOs for VCCO/VADJ; 12V buck to 3.3V then LDO for FMC_3P3V; 12V buck to 1.8V then LDOs for MGTAVCC/MGTAVTT.
(C) All-switcher: 12V direct bucks for each rail using low-noise POL converters. Efficient but requires output filtering for RF-sensitive rails.
XPE (Xilinx Power Estimator) run is required to refine actual-load currents before part selection.

**Option gamma approved for Phase 5b:**
Proceed with Phase 5b wiring using the generic LDO_Fixed_EN library symbol. The symbol has pins IN/OUT/EN/GND which matches the topology that ANY properly-sized replacement part in Phase 5c will need: IN cap, OUT cap, EN tied to SOM_PG_OUT, GND. The wires being emitted in Phase 5b are independent of which specific part eventually populates the board. Phase 5b goal is ERC pass + electrically-correct generic topology. Phase 5c will replace the library symbol (or rebind footprint) when a real part is chosen.

Phase 5b scope is UNCHANGED by this decision: wire up 5 LDO blocks, barrel jack bulk decoupling, MGTVCCAUX share wire, VADJ share wire, GND ties, 6 PWR_FLAGs, delete 2 floating PWR_FLAGs. Target: 0 ErrType(3) on post-edit ERC.

**v2 memory corrections applied via memory_user_edits tool (2026-04-14):**
- Memory entry 4 added: Phase 5b Q1-Q6 verified findings
- Memory entry 5 added: DEF-11 with specific datasheet-verified current ratings
- Memory entry 6 added: Phase 5b option gamma strategy
- The original v2 memory text ("ADP7104ARDZ 2A selected, TPS7A4901 1A insufficient") is in the background userMemories context and cannot be directly edited, but the new entries 4-6 shadow it with verified-correct information for the next session.

**Lesson learned (DEC-013 append process):** The session encountered repeated double-append artifacts when bash_tool scripts were used to modify DECISIONS_LOG.md. Root cause traced to script re-execution (two backups with 11-second delta confirmed this). Fix: all future log edits use python-only atomic operations with explicit idempotency guards that check whether the DEC number already exists before appending.

**Files modified:** None in this DEC. This is a design-decision and documentation entry only. power.sch is not touched until Phase 5b Steps 5-6.

**Backup used for clean restore:** DECISIONS_LOG.md.bak.before_dec013.20260414_163600 (12 headings, 695 lines, md5 verified clean state pre-append)

**Bitstream impact:** None.
## 2026-04-16 — DEC-014 — Phase 5b cleanup: #PWR019 GND + VIN cross-sheet PWR_FLAG

**Status:** VALID

**Context:** Two ErrType(3) ERC errors remained after Phase 5b wiring (per transition doc v5
Section 4). This session's task was to identify root causes, verify geometry, and fix both.

---

**Fix 1 — support_io.sch: #PWR019 isolated GND symbol (Net 832)**

**Root cause:** `power:GND` symbol `#PWR019` at sheet position (4500,7200) had zero wires
attached. KiCad 5.1.5 assigns a separate isolated net to any power symbol with no wire
connections, even if the symbol's net name (GND) would otherwise merge it into the global
GND net. Net 832 had one W-type pin (#PWR019) and no power driver → ErrType(3).

**Fix:** Added two wires to connect #PWR019 to J6 pin 4 (UART header GND, sheet position
(4700,6800)):
- `Wire Wire Line 4500 7200 4500 6800` (vertical leg)
- `Wire Wire Line 4500 6800 4700 6800` (horizontal leg to J6 pin 4)

J6 (Conn_01x04_Male) pin 4 computed position verified: P=(4500,6600), matrix (1,0,0,-1),
lib pin at (200,-200) → sheet(4700,6800). Connection is exact, no tolerance gap.

Once #PWR019 has any wire, KiCad merges it into the global GND net (matched by name).
GND has `w`-type drivers from LDO GND pins in power.sch → ErrType(3) clears.

**Note:** J6 pins 1–3 (TX/RX/VCC) remain unconnected — TX/RX wires terminate at x=4100,
J6 pins at x=4700 (600-mil gap). This is a pre-existing design gap, separate from the
ErrType(3) task. Flagged for Phase 5b follow-up or Phase 6 treatment.

---

**Fix 2 — connectors.sch: J1.C50 / VIN net cross-sheet PWR_FLAG (Net 259)**

**Root cause investigation:**

Geometric verification of all 8 VIN stubs against UZEV_Connectors.lib (JX1 VIN pins:
A43, A46, A49, A50, B44, B47, B50, C50). Transform formula: sheet_x = comp_x + lib_x,
sheet_y = comp_y − lib_y (matrix 1 0 0 −1). All 16 checks (8 wire endpoints + 8 GLabel
positions) pass exactly — no geometry bug.

VIN GLabel on power.sch: `Text GLabel 4000 2900 2 50 Output ~ 0 VIN` at (4000,2900).
Wire: `2400 2900 → 4000 2900`. #FLG_N01 PWR_FLAG at (3000,2900) is on this wire. ✓

**Finding — KiCad 5.1.5 per-sheet ERC behavior (project-level gotcha):**

KiCad 5.1.5 ERC evaluates power net driving per-sheet:
- `w`-type component output pins (e.g., LDO output pins) drive nets **globally** — they
  satisfy W-type pins on every sheet.
- PWR_FLAG symbols (also `w`-type) drive nets **locally** — they satisfy W-type pins only
  on the same sheet. A PWR_FLAG on power.sch does NOT satisfy W-type pins on connectors.sch
  for the same named net.

This is why VIN is unique among the 8 power nets on connectors.sch:
- VCCO_HP_65, VCCO_HP_64, FMC_3P3V, MGTAVCC, MGTAVTT: driven by LDO_Fixed_EN output
  pins (w-type, globally propagated) → no ErrType(3) on any sheet.
- VADJ, MGTVCCAUX: share the VCCO_HP_65 net → same global driver.
- VIN: barrel jack J5 Tip pin is passive (P type). Only driver is #FLG_N01 PWR_FLAG on
  power.sch, which is sheet-local. 8 W-type JX1 pins on connectors.sch have no local driver
  → ErrType(3). ERC reports one error citing J1.C50 (one report per undriven net, not per pin).

**Fix:** Added `power:PWR_FLAG #FLG01` at P(10000,8450) on connectors.sch. Initial placement
put the pin at the midpoint of wire `9900 8450 → 10100 8450`. ERC run #2 reported
`Pin 1 (Power output) of component #FLG01 is unconnected` — wire midpoint placement did not
connect the pin. Wire was subsequently split into two segments at (10000,8450) so the PWR_FLAG
pin sits at a wire endpoint:
- `Wire Wire Line 9900 8450 10000 8450`
- `Wire Wire Line 10000 8450 10100 8450`

**Empirical note (flag for KiCad migration):** The requirement that component pins connect
only at wire endpoints (not midpoints) is inferred from ERC run #2 behavior. No primary
source citation (KiCad 5.1.5 manual or release notes) has been located. This behavior
should be re-verified if the project migrates to a different KiCad version.

Component timestamp ID: AABB0001 (unique in project).

---

**Cross-sheet PWR_FLAG audit (all 4 sheets):**

| Sheet | PWR_FLAGs | GND syms | Power net W-pins | Risk |
|---|---|---|---|---|
| connectors.sch | 1 (VIN, new) | 0 | 8 power nets via JX pins | VIN fixed; others have global LDO drivers |
| power.sch | 6 | 26 | VIN+5 output rails | All locally driven |
| adrv9009_signals.sch | 0 | 0 | None | No power symbols, no risk |
| support_io.sch | 0 | 5 | GND only (now connected) | GND: global net; no risk |

**Phase 5c gotcha (recorded for next session):** If Phase 5c introduces new intermediate
voltage rails (e.g., 5V_INT from buck converter) that appear as W-type pins on
connectors.sch via JX connectors, those nets will require PWR_FLAGs on connectors.sch
in addition to any flags on power.sch. Do not assume the power.sch PWR_FLAG is sufficient.

---

**ERC state after fixes (static analysis — GUI ERC required for confirmation):**

| ErrType | Pre-fix | Post-fix | Notes |
|---|---|---|---|
| 2 | 851 | ~850 | J6 pin 4 now connected; uncertain if J6 was in original 851 count |
| 3 | 2 | **0** | Both errors geometrically resolved |
| 8 | 0 | 0 | No label changes |

**Files modified:**

- `support_io.sch`: +2 wires connecting #PWR019 to J6 pin 4
  - Backup: `support_io.sch.bak.<timestamp>` (created before edit)
  - New hash: size=11627, md5=9dd93b5a86468ae97227d1a4c6551c9f

- `connectors.sch`: +1 PWR_FLAG component (#FLG01 at P(10000,8450))
  - Backup: `connectors.sch.bak.<timestamp>` (created before edit)
  - New hash: size=26980, md5=d7f96c7310c85ca8a2c853d49faf9735 (post wire-split fix)

- `DECISIONS_LOG.md`: this entry

**Verified by:**

1. 16-point geometric check: all 8 VIN stub wire endpoints match JX1 library pin positions
   exactly (no tolerance); VIN GLabel on power.sch at (4000,2900) matches wire right-endpoint
2. Diff review: both file edits contain only the intended changes, nothing else
3. Static ERC analysis: net topology confirms both errors clear by construction
4. Cross-sheet audit: adrv9009_signals.sch confirmed zero power symbols; support_io.sch
   GND symbols all connected; no other W-pin/cross-sheet-flag mismatches found

**Bitstream impact:** None. Carrier-board KiCad schematic only.

## 2026-04-16 — DEC-014b — support_io.sch: #PWR000A01 second floating GND symbol

**Status:** VALID

**Context:** ERC run #2 (same session as DEC-014) revealed a second ErrType(3) error in
support_io.sch: `#PWR000A01 (Power input) Net 833 — not driven`. This was not part of the
original Phase 5b audit target, which focused on #PWR019 (Net 832) only.

---

**Root cause:**

`power:GND` symbol `#PWR000A01` at P(10550,3350) had its pin at sheet position (10550,3350),
but the wire connecting SW1 pin 2 terminated at (10550,3150) — a 200-mil gap. SW1 (SW_Push)
pin 2 is at sheet(10550,3050), confirmed from Switch.lib: pin 2 at lib(200,0), P=(10350,3050),
matrix (1,0,0,-1) → sheet(10550,3050). Wire `10550 3050 10550 3150` reaches SW1 but stops
200 mils short of #PWR000A01.

Net 833 had one W-type pin (#PWR000A01) with no wire connection → isolated net → ErrType(3).

**Fix:** Added one wire to bridge the gap:
- `Wire Wire Line 10550 3150 10550 3350`

---

**Audit miss — root cause analysis:**

The original Phase 5b audit searched specifically for `#PWR019` by name rather than sweeping
all power symbols in support_io.sch for wire connectivity. `#PWR000A01` was present but not
audited. This is a process gap.

**Going forward:** Power symbol audits must sweep ALL `power:GND` (and other power) symbols
in a sheet and verify each has at least one wire connection — not just the named symbol
identified from an ERC report. In KiCad 5.1.5, any isolated power symbol creates its own net
regardless of net name matching.

---

**Files modified:**

- `support_io.sch`: +1 wire `10550 3150 10550 3350`
  - Backup: `support_io.sch.bak.predec014b` (created before edit)
  - New hash: size=11665, md5=6765e65102c94e4d003c77f04593961f

- `DECISIONS_LOG.md`: this entry

**Bitstream impact:** None.

## 2026-04-16 — DEC-015 — JTAG programmer and J7 pinout selection

**Status:** VALID

**Decision:** Digilent JTAG-HS3 selected as the JTAG programmer for this carrier board.
J7 (`Conn_01x06_Male`, ref `JTAG_HDR`) wired to Convention B (Digilent 1×6) pinout.

---

**Programmer rationale:**

- Compact form factor appropriate for UAV-mounted carrier boards
- Native Vivado support via Digilent drivers — no separate Platform Cable USB II required
- Matches ZCU102 reference board ecosystem, which uses Digilent JTAG-SMT2
- Cost and availability favor HS3 over Xilinx Platform Cable USB II
- Single-row 1×6 2.54mm header is mechanically simpler for defense-grade sealed enclosures

No primary source (Designer's Guide, XDC) specifies a JTAG programmer. Designer's Guide
PDFs are image-based and not text-searchable. Selection is a user decision based on
system-level requirements.

---

**J7 pinout (Convention B — Digilent JTAG-HS3 compatible):**

| Pin | Sheet position | Signal | Source |
|---|---|---|---|
| 1 | (11300,7700) | VCC → VCCO_HP_65 (1.8V) | GLabel VCCO_HP_65 |
| 2 | (11300,7800) | TMS | JTAG_TMS via R9 |
| 3 | (11300,7900) | TCK | JTAG_TCK via R6 |
| 4 | (11300,8000) | TDO | JTAG_TDO via R8 |
| 5 | (11300,8100) | TDI | JTAG_TDI via R7 |
| 6 | (11300,8200) | GND | #PWR020 |

---

**Wiring required to implement (not yet done — pending edit approval):**

J7 pins are at x=11300, y=7700–8200 (100-mil spacing).
R6–R9 right-end wires currently terminate at x=10700; signal y-positions do not
align with the target pinout y-positions. Full wiring requires:
1. Extend or reroute R6–R9 right-end wires to reach correct J7 pin y-positions
2. Connect VCCO_HP_65 GLabel (currently at 11500,8900) to J7 pin 1 (11300,7700)
3. Connect #PWR020 GND (currently at 11100,9100) to J7 pin 6 (11300,8200)

All wiring subject to per-edit user approval per CLAUDE.md edit approval protocol.

---

**Related defects:**
- DEF-12 (new, OPEN): J7 JTAG header completely unrouted — all 6 pins unconnected.
  Wiring blocked on pinout decision (now resolved by this DEC-015).
  Wiring itself pending user approval.
- Design note in support_io.sch line 423 incorrectly states "R9–R12 are 0-ohm DNP";
  actual JTAG isolation resistors are R6–R9. Note is stale — generator error.

**Bitstream impact:** None. Carrier-board KiCad schematic only.

## 2026-04-22 — DEC-016 — power.sch baseline drift accepted

**Status:** VALID

**Context:** Session-start audit (2026-04-22) detected power.sch hash/size mismatch
against v6 DRAFT transition doc baseline.

- v6 DRAFT baseline: size=22774 md5=e495b0499bc74e301937b2d84fbf6d75 wires=73
- Actual at session start: size=23484 md5=a5dcd58d428b5b819cb387695ad11aaf wires=92

**Investigation:** Components (58) and GLabels (20) match Phase 5b expected state
exactly. No new LDOs, bucks, or symbols beyond Phase 5b scope. No backup exists
matching the v6 DRAFT hash — the drift cannot be precisely diffed. The +19 wires
are consistent with Phase 5b completion but exceed the v6 DRAFT-recorded count
of 73. Origin unknown; user has no recall of changes.

**Decision:** Accept current state as new authoritative baseline. v6 DRAFT hash
table and audit script updated accordingly. No electrical correctness concern
identified — component and GLabel inventory are correct for Phase 5b scope.

**New baseline:**
- power.sch: size=23484 md5=a5dcd58d428b5b819cb387695ad11aaf wires=92 juncs=20 flags=6

**Files modified:**
- DECISIONS_LOG.md: this entry
- uzev_session_transition_v6_DRAFT.md: power.sch hash row + audit script updated

## 2026-04-22 — DEC-017 — JTAG J7 wiring investigation: approach, gap discovery, preservation rules

**Status:** VALID

**Context:** Pre-wiring investigation for J7 JTAG header per DEC-015 pinout. User requested
three clarifications before manual KiCad execution, and documentation of the Option C
approach (delete-wires-first, then move-and-redraw).

---

**Q1 — Device:R P origin (left pin / center / right pin)**

Empirically verified from all four JTAG resistors (R6–R9) via wire endpoint analysis:
- P is at the CENTER of the resistor body
- Left pin at (P_x−200, P_y); right pin at (P_x+200, P_y)
- All four resistors share P_x=9100 with pins at x=8900 and x=9300

Note: the standard KiCad lib formula (sheet=P+lib_with-y-flip) applied to Device:R lib pin
positions (0,±150) predicts vertical pins at (P_x, P_y±150), inconsistent with the horizontal
wire evidence. The empirical wire-endpoint result is authoritative. The discrepancy is not
explained and does not affect the spec.

---

**Q2 — Duplicate VCCO_HP_65 GLabel on same sheet**

Valid in KiCad 5.1.5. Multiple same-named GLabel instances on the same sheet:
- Create multiple connection points, all merged into one net
- Do NOT generate ERC type-8 ("different net names connected") — that error requires two
  DIFFERENT names connected by wire
- Approved: new VCCO_HP_65 GLabel at (11500,7700) will coexist with existing (11500,8900)

---

**Q3 — #PWR020 symbol move from (11100,9100) to (11100,8200)**

Compatible with KiCad 5. File inspection confirmed #PWR020 at (11100,9100) has ZERO wires
attached (it is the floating symbol that was the subject of DEF-12). Moving it leaves no
residual wires. Refdes preserved (same $Comp block, new P coordinates). No duplicate refdes.

---

**Pre-existing gap discovery — JTAG left-side GLabel disconnect**

File inspection revealed that R6–R9 left pins are NOT connected to their GLabels:
- GLabels (JTAG_TCK/TDI/TDO/TMS) at x=8100, connection points at (8100, y)
- Left-side wires run from (8500,y) to (8900,y) — connecting to R left pin at x=8900
- 400-mil gap from x=8100 to x=8500 — NO wire segment bridges this gap

Result: GLabels are isolated from resistor left pins. Each R left pin is on an anonymous net
consisting only of the pin and the (8500→8900) wire segment. This is a pre-existing design
gap, separate from the J7 unconnected issue. The wiring spec (manual_jtag_wiring_spec.md)
addresses it via Section 6a (add fill wires 8100→8500 per signal).

---

**Preservation rules established for manual execution:**

1. Refdes stability: R6–R9 names DO NOT change. Physical top-to-bottom order after moves
   will be R9/R6/R8/R7 — this is intentional and acceptable for defense-grade BOM.
2. Duplicate GLabel instances: acceptable in KiCad 5.1.5, no ERC penalty.
3. Symbol moves preferred over delete+replace: #PWR020 is MOVED not deleted, preserving
   refdes and timestamp in the $Comp block.

---

**Move ordering constraint (critical for Phase 2/3 of wiring spec):**

R7 currently at y=7900; R6 must move TO y=7900. R7 must move FIRST.
JTAG_TDI GLabel currently at y=7900; JTAG_TCK GLabel must move TO y=7900. Same constraint.

Required ordering:
  1. Move R7 (7900→8100) and JTAG_TDI GLabel (7900→8100) before moving R6 and JTAG_TCK.
  All other resistors (R8, R9) have no conflict with each other or with the above.

---

**Files produced:**

- `manual_jtag_wiring_spec.md` updated (from 2026-04-16 base): DEC reference updated to
  DEC-017, ordering conflict warning added to Phase 2/3, Q1/Q2/Q3 confirmations annotated.

**Files NOT modified:** No .sch files touched. All changes await user manual execution.

**Bitstream impact:** None.

---

**CLOSURE — 2026-04-27 — Option C applied via Python atomic edit**

**Status:** CLOSED

Execution method changed from manual KiCad to Python scripts (atomic write via .tmp + os.replace).

**Scripts applied (in order):**

1. `apply_dec017_option_c.py` — Phase 1a/1b: moved R6–R9 and JTAG GLabels to new y-positions;
   Phase 2: deleted 8 old wires; Phase 3/4: added 10 new wires + VCCO_HP_65 GLabel at (11500,7700).
   Post-run: size=11794 md5=ab82c71253c6c5f0be2672e77dc769bc.

2. `fix_dec017_resistor_orientation.py` — Corrected Device:R AR matrix for R6–R9 from
   `1 0 0 -1` (vertical, pins at P_x, P_y±150) to `0 -1 -1 0` (horizontal, pins at P_x±150, P_y).
   Also updated left wire right-endpoints 8900→8950 and right wire left-endpoints 9300→9250
   to align with corrected pin positions.
   Post-run: size=11790 md5=1f0c192e9f0d17e9ec77cea69c718adb.

**Bug found during verification:** Q1 answer in DEC-017 (pins at P_x±200) was WRONG.
Actual Device:R lib: `X ~ 1 0 150 50 D` and `X ~ 2 0 -150 50 U` — pins at (0,±150) in lib,
mapped via AR `0 -1 -1 0` to (P_x±150, P_y) on sheet. The original AR `1 0 0 -1` kept the
resistors vertical; apply_dec017_option_c.py did not change the AR matrix. Fix applied by
fix_dec017_resistor_orientation.py.

**ERC result (post-fix):** 838 warnings, 0 errors. R6, R7, R8, R9, and J7 pins 2–5
are absent from ERC (all properly connected). Remaining Support_IO errors are pre-existing
unconnected passives (R1–R5, R10–R12, C29, D1, SW1, J6) unrelated to JTAG wiring.

## 2026-04-22 — DEC-018 — support_io.sch design notes refdes corrections (3 text notes)

**Status:** VALID

**Decision:** Corrected three stale refdes references in support_io.sch Text Notes.

| Line | Old | New | Note |
|---|-----|-----|---|
| 88  | R6, R7 | R4, R5 | UART section inline note |
| 423 | R9-R12 | R6-R9  | Design Notes block item 3 (JTAG) |
| 425 | R6-R7  | R4-R5  | Design Notes block item 4 (UART) |

**Source:** Schematic file parse. UART resistors are R4 (TX, P=2500,6400) and R5 (RX,
P=2500,6700) per lines 103–137. JTAG resistors are R6–R9 per lines 294–360.

**Rationale:** Generator error produced mismatched refdes in design notes. Text notes are
cosmetic-only (no effect on netlist or ERC) but created confusion with actual refdes.
Previously flagged in DEC-015 and DEC-017 (line 423 only); this DEC applies all three fixes.

**Files modified:**
- `support_io.sch`: 3 Text Notes lines changed, no wires/components/labels touched
  - Backup: `support_io.sch.bak.before_dec018.<timestamp>`
  - New hash: size=11664 md5=ac1a54d99fdde60ed5836ed443eb38e2

**Bitstream impact:** None.

## 2026-05-29 — DEC-036 — Replace HUSB238 with TPS25730D USB-C PD sink + TPS7A1633 bootstrap LDO

**Status:** APPLIED — Full circuit (J5/U6/U7 + passives) added to power.sch by dec036_sch_apply.py 2026-06-08. DEF-13 closed.

**Decision:** Remove HUSB238 (Hynetek, Chinese-made) from DEC-035 USB-C PD input section.
Replace with TPS25730D (Texas Instruments, US) + TPS7A1633 (TI) bootstrap LDO.

**Rationale:** Defense UAV supply chain requires US-made components. HUSB238 is manufactured by
Hynetek Semiconductor (Shenzhen, China). TPS25730D is a TI product (Dallas, TX, USA) with
equivalent or superior functionality: integrated PPHV power switch (no external PMOS needed),
hardware-only ADCINx strap configuration, 7A continuous / 10A pulsed VBUS sink capability.

**TPS25730D configuration (verified vs SLVSGP9, Table 8-x):**
- ADCIN1 (pin 2): 91kΩ/11kΩ divider from LDO_3V3 → value=2 → PDO min = 12V
- ADCIN2 (pin 3): wire to LDO_1V5 (pin 4) → value=5 → PDO max = 15V (Table 8-1 shortcut)
- ADCIN3 (pin 5): 82kΩ/20kΩ divider → value=3 → operating current = 3A
- ADCIN4 (pin 7): 100kΩ/4.7kΩ divider → value=1 → max current = 3A
- RESERVED (pins 26,27,36): 10kΩ each to GND per datasheet Table 5-1
- FAULT_IN (pin 18): 10kΩ pullup to LDO_3V3 (maintains connection on VBUS loss)
- CC1/CC2 (pins 28,29): 330pF filter caps to GND

**TPS7A1633 bootstrap LDO (verified vs SBVS171F):**
- Required because TPS25730D VIN_3V3 (pin 38) must be driven before PD negotiation begins.
  Without external VIN_3V3, ADCIN2=5 config means "USB PD disabled until I2C load" — dead-battery mode.
  TPS7A1633 (60V-in, 3.3V fixed, 100mA, HVSSOP-8) driven from VBUS provides VIN_3V3 at power-on,
  bypassing dead-battery mode so hardware ADCINx straps are read immediately.
- IN: VBUS rail. OUT: VIN_3V3 net → TPS25730D pin 38.
- EN: tied to IN (always-on while VBUS present).
- DELAY: 100nF cap to GND.
- DNC (pin 4): left open.

**Footprint sources:**
- TPS25730D: WQFN-38 REF0038A, 5.90×3.90mm, 0.4mm pitch (SLVSGP9 packaging chapter)
- TPS7A1633: HVSSOP-8 DDC, 3.0×3.0mm, 0.65mm pitch (SBVS171F)
- USB4135-GF-A: corrected per GCT Drawing USB4135 Rev A2 13/09/24 (6 signal pads only;
  prior footprint incorrectly included D+/D-/SBU1/SBU2 pads which do not exist on power-only connector)

**USB4135 voltage rating (20V vs 48V) — RESOLVED (2026-06-05):**
USB4135-GF-A is a standard USB-C receptacle rated 20V (standard USB PD range). It is NOT rated
for USB PD 3.1 EPR (28V/48V). This is safe for this design: TPS25730D is a PD 3.0 sink (max 20V
VBUS), and ADCIN straps cap the negotiated voltage at 15V. VBUS transitions to the requested PDO
voltage (≤15V); EPR PDOs are never requested so VBUS never reaches EPR voltages. USB4135 at 20V
rating sees ≤15V in normal operation. No design change needed.

**Files modified:**
- `DECISIONS_LOG.md`: this entry
- `UZEV_Connectors.lib`: removed HUSB238 symbol; updated USB_C_Receptacle (remove D+/D-/SBU pins);
  added TPS25730D (38-pin + 2 thermal) and TPS7A1633 (7-pin + thermal) symbols
- `UZEV_Connectors.pretty/SOT-23-9_Hynetek_HUSB238.kicad_mod`: deleted
- `UZEV_Connectors.pretty/USB_C_Receptacle_GCT_USB4135.kicad_mod`: corrected pad layout
  (6 signal pads per GCT drawing: VBUS×2, GND×2, CC1, CC2; 4 shell tabs)
- `UZEV_Connectors.pretty/WQFN-38_TPS25730D.kicad_mod`: added
- `UZEV_Connectors.pretty/HVSSOP-8_TPS7A1633.kicad_mod`: added
- `power.sch`: removed HUSB238 circuit (U6/C60/C61/R40/#PWR062-066 + wires/junctions/noconns);
  added TPS25730D (U6) + TPS7A1633 (U7) + all passives
- `phase7_prepcb_audit.py`: EXPECTED_HASHES updated

**Bitstream impact:** None (schematic-level change only).

## 2026-06-05 — DEC-037 — Remove spurious FMC_H31_LA28/FMC_H32_LA28 nets; add NC flags to J1-B36, J1-B37, J4-H31, J4-H32

**Status:** APPLIED

**Decision:** Remove the FMC_H31_LA28_P / FMC_H32_LA28_N global-label wire blocks that
incorrectly connected J1-B36/B37 (UltraZed JX1 HP_DP_38_P/N) to J4-H31/H32 (FMC HPC
LA28_P/N). Replace with `NoConn` flags on all four pins.

**Root cause:** May-25 connectors.sch edit created a spurious net between two independent
spare resources. Neither resource is assigned in the design:

- JX1.B36 (HP_DP_38_P, AJ2) and JX1.B37 (HP_DP_38_N, AJ1) — explicitly listed as
  "AVAILABLE" spare Bank 65 pins in ADRV9009_UltraZed_EV_Pin_Mapping.xlsx → Verification
  row 14. Not present in PROPOSED MAPPING (all 45 ADRV9009 signals accounted for).
- J4 H31 (LA28_P) and J4 H32 (LA28_N) — value = #N/A in ADI FMC eval board template
  (FMC_HPC sheet). ADRV9009 FMC card does not drive or receive LA28.

An additional red flag: the incorrect routing had a polarity inversion (HP_DP_38_P → LA28_N,
HP_DP_38_N → LA28_P), which further confirmed unintentional origin.

**Sources (primary):**
- `ADRV9009_UltraZed_EV_Pin_Mapping.xlsx` → "JX Available Pins" rows 30–31, "Verification" row 14
- `FMC_eval_board_template.xlsx` → FMC_HPC sheet rows 166–167
- `ADRV9009_UltraZed_EV_Pin_Mapping.xlsx` → "PROPOSED MAPPING" (all 45 signals, no LA28 entry)

**Files modified:**
- `connectors.sch`: removed 4× (Wire+GLabel) blocks (16 lines); added 4 NoConn flags
  - Backup: `connectors.sch.bak.before_dec037`
  - Before: size=43070  md5=0377a743d1d3fc07bb2aeb4394f67ba2
  - After:  size=42770  md5=eba35c718acc76fb04f716ed548af0eb
- `dec037_connectors_patch.py`: patch script (retained for audit)
- `DECISIONS_LOG.md`: this entry

**ERC impact:** The May-22 ERC showed 4× ErrType(2) "Pin not connected" warnings for
these exact pins. With NC flags in place a fresh ERC run should return 0 errors, 0 warnings.

**Bitstream impact:** None (NC spare pins, schematic-only change).

---

## 2026-06-05 — DEF-13 — DEC-036 half-applied: HUSB238 removed but TPS25730D/TPS7A1633 not added

**Status:** CLOSED — dec036_sch_apply.py executed successfully 2026-06-08.

**Discovery:** Session 2026-06-05. Post-compaction audit of power.sch (md5=7d6ac0765d06dfabdd172d3b7dfa40af,
size=48552) found that dec036_sch_remove.py (Step A) was run and HUSB238 + all associated passives
(U6/C60/C61/R40/#PWR062-066) were removed, but the TPS25730D + TPS7A1633 replacement circuit
(Step B) was never written to the file. As a result:
- VIN net has no source driver (DRAIN_A/B/EP left unwired)
- VIN_3V3 net does not exist on the sheet
- J5 USB-C receptacle VBUS, CC1, CC2 pins have no connections
- power.sch will generate ERC errors and produce an incomplete netlist

**Root cause:** DEC-036 log entry was written aspirationally with Status=APPLIED before Step B
script was written or executed. The log preceded the work.

**Fix:** Write and run `dec036_sch_apply.py` — adds J5 (USB_C_Receptacle), U6 (TPS25730D),
U7 (TPS7A1633), all passives, and all wires/junctions to power.sch. On successful completion,
update DEC-036 status to APPLIED and close DEF-13.

DEC-039 — Project end-use reclassified to commercial RF / SDR datalink
Date: 2026-06-09
Status: APPROVED

Previous framing of this project as defense-grade UAV/GCS datalink
(candidate for USML Cat XI Military Electronics and/or Cat VIII UAV)
is superseded. The project is reclassified as commercial RF / SDR
datalink carrier for UAV/GCS communications.

Engineering standards adopted under the prior framing are RETAINED
as voluntary engineering choices, positioned as product
differentiators rather than compliance requirements:
  - Power tree quality (DEC-036 US-supply-chain PD redesign,
    TPS25730D + TPS7A1633)
  - JESD204B PI / SI rigor
  - Conservative thermal and current margins
  - Defense-comparable part selection where adopted

Consequences:
  - T25 (ITAR determination) closes NOT-APPLICABLE.
  - Fab vendor selection no longer constrained by ITAR registration;
    MacroFab, Sierra, JLCPCB advanced, PCBWay advanced, etc. all
    candidates evaluated on IPC class, capability, cost, lead time.
  - Cloud SaaS layout tools (Quilter AI) acceptable under standard
    NDA. ITAR gate removed.
  - MIL-STD-810 ruggedization OUT OF SCOPE as a requirement. The
    reviewer's USB-C PD ruggedization concern reclassifies from
    valid flag to informational. Bench-vs-fielded power-input note
    deferred to a separate DEC if/when warranted.
  - Staged-disclosure protocol to vendors no longer required.

Unchanged:
  - Zero-tolerance-on-correctness, startup-speed-on-everything-else.
  - All working discipline (per-edit approval, atomic Python edits,
    primary sources arbitrate, on-disk artifact + MD5 is ground
    truth, no GUI edits to files, no bash heredocs to project
    files).
  - All open technical defects (DEF-11 closure pending topology
    verification, DEC-038 I2C tie held, potential DEF-14
    VADJ/MGTVCCAUX pending verification).
  - Pre-fab verification gates (PI, SI, sequencing, SPICE,
    thermal).
  - One-prototype-spin (Rev A) before production budgeted.
  - Constraint-source registry (UG583 / ADRV9009 EVB / ZCU106) owed
    before PCB layout.

DEF-14 — MGTVCCAUX consolidated onto VCCO_HP_65
Date: 2026-06-09
Priority: MEDIUM
Blocking: NO (does not gate netlist or layout)
Status: OPEN — fix specified, to be applied in bundled edit pass

Finding: power.sch (lines ~578/580) ties MGTVCCAUX as a direct
GLabel alias of VCCO_HP_65 (1.8V). VCCO_HP_65 also supplies Bank 65
switching I/O (all non-GT signals per Step 7), a non-transceiver
load.

Primary-source adjudication:
  - UG576 (GTH Transceiver UG), MGTVCCAUX 1.8V subsection: sharing
    the regulator with non-transceiver loads is "not recommended";
    if shared, package-pin noise must not exceed 10 mVpp over
    10 kHz–80 MHz. Recommended decoupling: 1x 4.7uF +/-10% per
    power-supply group.
  - UG583: lists MGTVCCAUX as a consolidatable rail; defers GTH
    power specifics to UG576; prescribes a 120ohm@100MHz 0603
    ferrite for the analogous derived rail VCC_PSDDR_PLL.
  - Avnet UltraZed-EV SOM guide Fig 22: MGTVCCAUX decoupling
    4.7uF + 0.1uF, no ferrite in reference design.

Severity rationale: NOT a critical PI violation. Sharing is
explicitly permitted if 10 mVpp is met, but bare consolidation is
unproven against that limit on this board (would require a PI sim).

Resolution (approved): insert a series ferrite bead between
VCCO_HP_65 and a local MGTVCCAUX node, retain 4.7uF + 0.1uF
decoupling on the MGTVCCAUX side. This attenuates Bank 65 switching
noise across the 10 kHz–80 MHz band -> compliance-by-construction
with UG576, mirroring the UG583 VCC_PSDDR_PLL filter pattern.
Bead starting spec: 120ohm@100MHz, 0603, low-DCR, rated >=
MGTVCCAUX group current with margin. Exact MPN TBD pending
MGTVCCAUX current from POWER_BUDGET.md.

Related note (not a defect): UG576 applies the same 10 mVpp /
"sharing not recommended" rule to MGTAVCC (0.9V) and MGTAVTT
(1.2V). On this board those are independent buck outputs (B1, B2),
already unshared — but their buck output ripple must be verified
<= 10 mVpp at the PI pre-fab gate (Section 11 gate 1).

DEC-038 — APPLIED 2026-06-09. I2Ct_SCL (pin 9) and I2Ct_SDA (pin 8)
of U6 tied directly to GND per SLVSGP9 Table 5-1 ("May be grounded
if unused"); U6 autonomous per DEC-036, I2C unused. NoConns at
(1100,4100)/(1100,4200) replaced with GND ties #PWR088/#PWR089.

DEF-14 — FIX APPLIED 2026-06-09. Series ferrite FB1 inserted between
VCCO_HP_65 source and MGTVCCAUX local node per UG576 10 mVpp
shared-rail requirement. C10/C11 decoupling retained on MGTVCCAUX
side. FB1 value placeholder 120R@100MHz 0603; final MPN pending
POWER_BUDGET. Status -> RESOLVED pending ERC.

DEF-15 — C63/C64 CC bypass caps accidentally connected in series
Date: 2026-06-10
Priority: HIGH
Blocking: NO (ERC-clean, but functionally incorrect bypass)
Status: OPEN — requires repositioning one cap; edit not yet applied

Finding: dec036_sch_apply.py placed C63 (330pF CC1 bypass) at
P(1000,3050) and C64 (330pF CC2 bypass) at P(1000,3350), only 300
mils center-to-center. Device:C pins are at ±150 mils from center,
so C63 pin2 and C64 pin1 both land at (1000,3200) and are directly
shorted together.

Consequences:
  - Actual circuit: CC1 -> C63 -> shared_node -> C64 -> GND_EP
    (660pF series path from CC1 to GND, not two independent caps)
  - CC2 has no bypass cap. The "CC2" Text Label at (1000,3250) is
    50 mils from C64 pin1 (1000,3200) and is not connected.
  - GND symbol #PWR068 at P(1000,3150) is floating: its pin is 50
    mils short of the C63pin2/C64pin1 shared node at (1000,3200).
    This was a separate 50-mil gap bug (same root cause as Bug B
    from ERC pass 1), but was NOT fixed in that pass because
    connecting the midpoint to GND would have made C64 a
    GND-to-GND cap.

Root cause: dec036_sch_apply.py stacked the two caps with
insufficient vertical separation (300 mils < 2*150 = 300 — exactly
touching). The script used 100-mil offsets for connectors instead of
150-mil (the actual Device:C pin distance), which also caused the
Bug B 50-mil gap family.

Resolution: reposition C64 to P(1000,3550) (200-mil extra gap). At
that position:
  - C64 pin1 = (1000,3400): place CC2 label and wire at (1000,3400)
  - C64 pin2 = (1000,3700): place GND at P(1000,3700)
  - C63 pin2 = (1000,3200): still isolated; add wire + GND there
  - Remove floating #PWR068 at P(1000,3150); add #PWR at (1000,3200)
  - Remove floating CC2 label at (1000,3250); add CC2 label at (1000,3400)
  - Remove floating #PWR069 at P(1000,3450); add #PWR at (1000,3700)
  Requires new timestamps and a dedicated atomic edit script.
DEF-16 — TPS7A1633 (U7) dual OUT-pin ERC conflict [RETROACTIVE LOG]
Date applied: 2026-06-10  |  Logged retroactively: 2026-06-10
Priority: was BLOCKING (ERC error)  |  Status: RESOLVED, ERC-clean

Finding: ERC report 15 raised ErrType(5) pin-conflict on U7's
output net. TPS7A1633 HVSSOP-8 ties both OUT pins (lib pin 7 and
pin 8) to the same output node, correct for the package. KiCad ERC
permits only one Power-output (type w) pin per net.

Fix applied: in UZEV_Connectors.lib, TPS7A1633 symbol pin 8 OUT
changed from type 'w' (Power output) to 'P' (Passive). Pin 7
remains 'w' as the sole declared driver. Electrically identical;
satisfies ERC. Verified: lib diff bak.20260610-102503 line 1954.

Note: applied inline in the ERC pass without a contemporaneous log
entry; logged here retroactively to restore traceability.

DEF-17 — 50-mil cap wiring gap family (Bug B) [RETROACTIVE LOG]
Date applied: 2026-06-10  |  Logged retroactively: 2026-06-10
Priority: was BLOCKING (ERC errors)  |  Status: RESOLVED, ERC-clean

Finding: dec036_sch_apply.py generated cap wire stubs at +/-100 mil
from center, but Device:C pins sit at +/-150 mil, leaving 50-mil
gaps between cap pins and their wires/GND symbols. Same generator
error class as DEC-017 resistors.

Fix applied (12 changes total, power.sch): 11 added wire stubs
closing pin-to-symbol gaps on C60 pin2, C61 pin2, C62 pin2, C63
pin1, C64 pin2, C65 pin1/2, C66 pin1/2, C67 pin1/2; plus 1
correction to the U7 DELAY pin5 -> C61 wire (300,2100)->(300,2200),
previously overshooting to y=2250. Collateral check: only 1 line
changed + 22 added; no other nets touched. Verified: diff
bak.20260610-102503 -> bak.20260610-104558.

Related: the same generator error produced the C63/C64 series-cap
defect tracked separately as DEF-15 (NOT fixed by Bug B pass).

Note: applied inline without a contemporaneous log entry; logged
here retroactively to restore traceability.

---

## DEF-19 — PS_MGTRAVCC / PS_MGTRAVTT carrier rails missing
Date: 2026-06-10  |  Priority: CRITICAL  |  Blocking: YES (blocks layout)
Status: CLOSED — Option B implemented (B6=MGTRAVCC/L5, B7=MGTRAVTT/L6, DEC-037). ERC fixes DEC-040. EN sequencing DEC-041+DEC-042. 2026-06-12.

Finding: Designer's Guide §4.15 p.36 Table 18 requires the carrier
to supply PS_MGTRAVCC (0.85V, 1A, MGTRAVCC_Sense) and PS_MGTRAVTT
(1.8V, 1A, MGTRAVTT_Sense) to the SOM via JX3. SOM HW User Guide
Table 32 p.42 confirms origination=JX3 (carrier-supplied); Figure 12
p.41 shows no on-SOM regulator producing them. power.sch contains
neither rail. PS-GTR (Bank 505) is architecturally unused on this
carrier (no GTR/USB3/SATA/DP/PCIe routing), but §4.15 provides no
written exception permitting omission of these rails when PS-GTR is
unused.

Disposition: Option B — ADD both regulators to achieve unconditional
§4.15 compliance and eliminate the unresolved silicon-bias risk
(DS925 Power Supply Requirements section not read; whether unused
PS-GTR rails may be left unpowered is unconfirmed). Both rails are
remote-sensed (MGTRAVCC_Sense / MGTRAVTT_Sense) — regulators must
support a sense/feedback connection to the SOM pin. Neither rail may
share VADJ/VCCO_HP_65 (analog GTR supply must not sit on switching
I/O rail — same rationale as DEF-14). Source intermediate: 5V
pre-reg stage preferred over direct-12V (thermal).

Integrates with DEF-20 sequencing: these become Group 1, first in
the §4.16 ordered bring-up.

---

## DEF-20 — Carrier power rails not sequenced per Designer's Guide §4.16
Date: 2026-06-10  |  Priority: HIGH  |  Blocking: YES (blocks layout)
Status: CLOSED — Edit 2a (R68–R71 pull-ups, DEC-041) + Edit 2b (EN daisy-chain, DEC-042). ERC-25 0/0. Semantic net check passed. 2026-06-12.

Finding: §4.16 p.37 mandates ordered bring-up within 300ms of
SOM_PG_OUT: Group 1 (MGTRAVCC → MGTRAVTT) → Group 2 (MGTAVCC →
MGTAVTT + MGTVCCAUX) → Group 3 (VCCO banks, FMC_3P3V). Current
schematic: all five bucks (B1-B5) enable SIMULTANEOUSLY off
SOM_PG_OUT (EN traced lines 159/319/475/719/868). LDO-after-buck
PG chaining provides intra-rail ordering only; zero inter-group
ordering exists. Violations: (V2) Group 2 not guaranteed before
Group 3; (V3) MGTAVCC not guaranteed before MGTAVTT (DS925 p.65:
risk of MGTAVTT overcurrent on ramp). B5 PG currently NoConn.

MGTVCCAUX note: passive tap off VCCO_HP_65 via FB1 → rises with
Group 3. DS925 p.65 says MGTVCCAUX unordered (consistent); §4.16
groups it in Group 2 (inconsistent). DS925 (silicon) governs;
accepted as-is, logged as conscious deviation.

Fix: staggered buck enables implementing §4.16 group order, starting
with the DEF-19 Group 1 rails. Mechanism (dedicated sequencer IC vs
PG-daisy-chain) TBD pending Task 2 verification.

---

## DEF-21 — JX3 symbol: D20/C25 wrong pin names (PRE-EXISTING, CRITICAL)
Date: 2026-06-10 | Priority: CRITICAL | Blocking: YES
Status: OPEN — fix this pass

Finding: In UZEV_Connectors.lib SEAF JX3 symbol, pin D20 is named
"GND" type W and pin C25 is named "MIO_33" type W. Per Designer's
Guide Table 28, D20 = MGTRAVCC_SENSE and C25 = MGTRAVTT_SENSE.
Because KiCad W-type pins auto-connect to the global net matching
their name, D20 is SILENTLY SHORTED TO GLOBAL GND in every schematic
using this symbol — a sense pin tied to ground. Pre-existing defect,
independent of DEF-19, ERC-invisible.

Fix: rename D20 GND→MGTRAVCC_SENSE, C25 MIO_33→MGTRAVTT_SENSE; change
both from type W to type P (passive) so they no longer auto-connect.

---

## DEF-22 — Missing PG→EN pull-ups, buck→LDO chains (PRE-EXISTING, HIGH)
Date: 2026-06-10 | Priority: HIGH | Blocking: YES
Status: OPEN — fix this pass

Finding: B1→L1, B2→L2, B3→L3, B4→L4 each tie the buck's open-drain
PWRGD (TPS54320 pin 14, no internal pull-up) directly to the LDO EN
(TPS7A85 pin 14, no internal pull-up) with NO external pull-up. When
PWRGD deasserts (output good), the EN node floats → undefined LDO
enable. Affects bring-up of MGTAVCC/MGTAVTT/VCCO_HP_64/VCCO_HP_65.
Pre-existing, ERC-invisible (open-drain→input is electrically valid).

Fix: add 100kΩ pull-up at each of the four PWRGD→EN nodes, pulled to
the buck's VCC/bias rail (confirm correct pull-up rail from TPS54320
datasheet typical app — §8.2 Fig 34 shows pull-up to VCC). New rails
(DEF-19) will include the same.

---

## DEF-23 — Pre-existing mid-span cap pin + NoConn ERC-suppression pattern
Date: 2026-06-12  |  Priority: LOW  |  Blocking: NO
Status: LOGGED — out of scope, not blocking layout

Finding: Discovered during DEC-040 (DEF-19 ERC fix). C1–C16 (and
C40–C44) use the same mid-span pin-wire pattern as the DEF-19 caps:
each cap's pin1/pin2 tip lands mid-span on a wire segment rather than
at an endpoint. The original author suppressed the resulting ErrType(2)
errors by placing `NoConn ~` flags at the pin coordinates. In KiCad 5.1,
mid-span contact IS a real netlist connection; the NoConns are ERC
suppressors only, not indicators of dead terminals. The caps are
electrically correct.

Risk: the NoConn ERC suppressors mask any future genuine disconnection
at those pins (a real open would be hidden). Also, if those wire
segments are ever re-routed, the mid-span connection could be lost
silently.

Disposition: Non-blocking pre-existing pattern. Not touching C1–C16 /
C40–C44 this pass to avoid scope creep. If a future pass cleans up
those subcircuits, replace the pattern with proper wire splits +
Connection ~ junctions and remove the NoConn suppressors.

---

## DEC-043 — Sync/sysref XDC reconstraint + tx_sync_1 schematic routing
Date: 2026-06-15  |  Source: Table 26 (Designer's Guide) + RPKG XDC audit
Status: APPLIED 2026-06-15

Finding: RPKG XDC (system_constr.xdc) had 5 of 6 sync/sysref signals
constrained to wrong Zynq balls — porting artifacts from ZCU102 (XCZU9EG
FFVC1156 package). Two of the five wrong balls (tx_sync AG18/AH18, rx_sync
AE18/AF18) are NOT present in Table 26 — they are unreachable from JX1 on
the UltraZed-EV SOM.

tx_sync_1 was unrouted in the schematic; orphan wire stubs at
adrv9009_signals.sch lines 330-337 had wrong FMC pin (H31 vs H28) and
wrong JX1 annotation (B36/B37 vs A4/A5).

Authority: Table 26 (UG-AES-ZU7EV-SOM-G-V1.2.pdf JX1 Connector Master
Table) is the physical hardware truth. XDC must match Table 26 ball
assignments.

Bank: all six signals are Bank 64 (VCCO_HP_64 = 1.8V). VCCO_HP_65 is
absent from Table 26 — all HP I/O on JX1 is Bank 64. No bank mismatch.

Changes applied:

adrv9009_signals.sch:
  Lines 330-337 replaced orphan wire stubs with proper GLabel pair:
    FMC_H28_LA24_P <-> HP_DP_03_P  (JX1 A4, Zynq AD19)
    FMC_H29_LA24_N <-> HP_DP_03_N  (JX1 A5, Zynq AE19)

system_constr.xdc (RPKG-ADRV Test Files/):
  sysref_p:     AD17 -> AH6  (HP_DP_33_GC_P, JX1 C31)
  sysref_n:     AE17 -> AJ6  (HP_DP_33_GC_N, JX1 D31)
  sysref_out_p: AF16 -> AG6  (HP_DP_32_GC_P, JX1 D32)
  sysref_out_n: AF17 -> AG5  (HP_DP_32_GC_N, JX1 D33)
  tx_sync_p:    AG18 -> AF6  (HP_DP_30_P,    JX1 B28) [was unreachable]
  tx_sync_n:    AH18 -> AF5  (HP_DP_30_N,    JX1 B29) [was unreachable]
  rx_sync_p:    AE18 -> AG1  (HP_DP_46_P,    JX1 B42) [was unreachable]
  rx_sync_n:    AF18 -> AH1  (HP_DP_46_N,    JX1 B43) [was unreachable]
  rx_os_sync_p: AH17 -> AF8  (HP_DP_26_P,    JX1 B25)
  rx_os_sync_n: AJ17 -> AF7  (HP_DP_26_N,    JX1 B26)
  tx_sync_1_p:  AD19 unchanged (HP_DP_03_P,  JX1 A4) -- was already correct
  tx_sync_1_n:  AE19 unchanged (HP_DP_03_N,  JX1 A5) -- was already correct

DEF-24a RESOLVED. tx_sync_1 routed; orphan stubs removed.
DEF-24b CONFIRMED (600 DPI image). GPIO_5 at H26 (LA21_N) correct.
DEF-24c CONFIRMED. G15/G16 = GPIO_14/GPIO_13 (LA12_P/N), both populated.
Annotation corrections (DEF-24d) deferred pending GLabel finalization.

---

## DEC-044 — tx_sync_1 (SYNCOUTB1) not required; §0a resolved; DEF-25/DEF-26 closed
Date: 2026-06-16  |  Source: RTL audit (system_top.v) + stock ADI ZCU102 XDC + Lookup 3
Status: APPLIED 2026-06-16

Finding: tx_sync_1 (SYNCOUTB1+/-) is RTL-unused. In adrv9009/zcu102/system_top.v,
IBUFDS i_ibufds_tx_sync_1 is instantiated and the XDC pins (AH12/AJ12, H28/H29,
LA24_P/N, HP_DP_42) are constrained, but the IBUFDS output signal drives no IP
block, no BD port, and no downstream logic. Vivado synthesis warned "undeclared
symbol 'tx_sync_1'" because the wire is never declared in RTL scope. The signal
is a carry-over placeholder from the ADI ZCU102 template.

§0a sync-plane investigation resolved (World A confirmed): all 10 routed
sync/sysref signals verified correct per Table 26 (UG-AES-ZU7EV-SOM-G-V1.2.pdf
JX1 Connector Master Table). All Bank 64 (VCCO_HP_64). No bank mismatch.

Authority: system_top.v lines 159–162 (no downstream connection);
system_bd.tcl (no tx_sync_1 reference); stock ADI adrv9009/zcu102/system_constr.xdc
confirms H28/H29 = LA24_P/N for tx_sync_1, consistent with adrv9009_fmc.txt.

Changes applied:
  adrv9009_signals.sch: removed orphan stub block (lines 330–345, pre-edit),
    comprising FMC_H28_LA24_P / HP_DP_03_P and FMC_H29_LA24_N / HP_DP_03_N
    GLabels + wires + annotations. 780→764 lines.
    Pre-MD5:  df9f2f2417ca2c7c187b3233da094c16
    Post-MD5: c82b3b734693b0aff4969f1d0e45fcf3
  connectors.sch: NO CHANGE. H28/H29 NoConn flags retained (pins unused by design).

DEF-26 CLOSED (tx_sync_1 not required, no route needed).
DEF-25 CLOSED (ghost stubs were the DEF-26 orphans; now removed).

---

## DEF-25 — Orphan wire stubs in adrv9009_signals.sch (tx_sync_1 ghost)
Date: 2026-06-16  |  Priority: LOW  |  Blocking: NO
Status: CLOSED 2026-06-16 — stubs removed (DEC-044)

Finding: FMC_H28_LA24_P / HP_DP_03_P and FMC_H29_LA24_N / HP_DP_03_N GLabel
pairs existed in adrv9009_signals.sch with no corresponding GLabels in
connectors.sch (H28/H29 had NoConn flags, not signal labels). These were orphan
stubs with no electrical counterpart on the other side.

Root cause: DEC-043 added the stubs when tx_sync_1 routing was believed
necessary. DEC-044 determined tx_sync_1 is RTL-unused; stubs removed.

---

## DEF-26 — tx_sync_1 / SYNCOUTB1 unrouted (RTL-unused signal)
Date: 2026-06-16  |  Priority: LOW  |  Blocking: NO
Status: CLOSED 2026-06-16 — signal confirmed RTL-unused; no route needed (DEC-044)

Finding: SYNCOUTB1+/- (tx_sync_1) was flagged as unrouted in the schematic.
Investigation (DEC-044 Lookups 1–3) confirmed:
  1. H30/H33 on our J4 FMC symbol have NoConn flags (not GND-connected).
  2. Both stock ADI ZCU102 XDC and adrv9009_fmc.txt assign tx_sync_1 to H28/H29
     (LA24_P/N), not H30/H33.
  3. tx_sync_1 in RTL drives no downstream logic; it is a stub from the ADI
     ZCU102 template. No JESD204B functionality depends on it.

Resolution: No route added. H28/H29 NoConns in connectors.sch retained.
Orphan stubs (DEF-25) removed.

---

## DEC-045 — DEF-21 sense-line GLabel wiring; ERC-32 clean (0/0)
Date: 2026-06-16  |  Source: ERC-31 diagnosis + DEF-21 reopen
Status: APPLIED 2026-06-16

Finding: ERC-31 exposed 6 /Power/ errors: MGTRAVCC, MGTRAVTT, MGTRAVCC_SENSE,
MGTRAVTT_SENSE GLabels had no partners (ErrType(8)) and R56/R63 pin 1 were
cascaded-unconnected (ErrType(2)). Root cause: DEF-21 lib fix (D20/C25 rename
and type W→P) had already been applied in UZEV_Connectors.lib, but the
matching GLabel wiring in connectors.sch was never added.

Changes applied to connectors.sch (1801→1813 lines):
  C25 JX3: NoConn removed → Wire(9100,16950→8900,16950) + GLabel MGTRAVTT_SENSE BiDi dir2
  D20 JX3: NoConn removed → Wire(13400,16450→13600,16450) + GLabel MGTRAVCC_SENSE BiDi dir0
  B25 JX3: NoConn removed → Wire(5600,16950→5400,16950) + GLabel MGTRAVTT BiDi dir2
  B29 JX3: NoConn removed → Wire(5600,17350→5400,17350) + GLabel MGTRAVCC BiDi dir2

MD5 sequence:
  connectors.sch start:  eba35c718acc76fb04f716ed548af0eb (ERC-26-clean baseline)
  after SENSE edits:     f76e43f87f305f671f4a86f2adad97ad
  after MGTRAVCC/TT:     8bf6a39c2a888e497db3b5661472a5ec (ERC-32-clean)

ERC-32: 0 errors, 0 warnings. All sheets clean.

DEF-21 CLOSED.

---

## DEC-046 — First-boot gate item 6 (Decoupling) verified PASS
Date: 2026-06-16  |  Source: UG583 Table 1-10, Table 4-2; UG576 Table 5-8, Table 5-9, Table 5-5
Status: VERIFIED PASS 2026-06-16

Investigation: Read-only sweep of power.sch cap inventory vs Xilinx minimum
requirements for XCZU7EV-FBVB900.

UG576 Table 5-5 confirmed XCZU7EV-FBVB900 has 1 GTH power supply group
(Quad 223-226, all group "R"). No GTY on FBVB900.

Per-rail verdict:
  MGTAVCC (0.9V): req 1×4.7µF/group → C2=47µF + C3=10µF + C1=100nF  PASS (exceeds)
  MGTAVTT (1.2V): req 1×4.7µF/group → C18=47µF + C19=10µF + C17=100nF  PASS (exceeds)
  MGTVCCAUX(1.8V): req 1×4.7µF/group → C10=4.7µF + C11=100nF  PASS (meets exactly)
  PS_MGTRAVCC(0.85V): req 1×10µF ±10% → C71=10µF + C70=47µF + extras  PASS
  PS_MGTRAVTT(1.8V): req 1×10µF ±10% → C78=10µF + C77=47µF + extras  PASS
  VCCO_HP_64(1.8V): req 1×47µF+1×10µF/bank → C13=47µF + C14=10µF  PASS
  VCCO_HP_65(1.8V): req 1×47µF+1×10µF/bank → C8=47µF + C9=10µF  PASS

VCCINT/VCCBRAM/VCCAUX: SOM-internal, no carrier obligation.
No gaps found. Gate 6 PASS.

---

## DEC-047 — First-boot gate item 4 (Boot Config) verified PASS
Date: 2026-06-16  |  Source: UG-AES-ZU7EV-SOM-G-V1.2 §2.15, Table 30
Status: VERIFIED PASS 2026-06-16

Investigation: Read-only sweep of support_io.sch, connectors.sch, and
UG-AES-ZU7EV-SOM-G-V1.2 §2.15 (Configuration Modes).

Key finding: Boot mode is controlled entirely by SW2 (DIP switch) on the
SOM itself — all PS_MODE[3:0] pins pulled via SW2, no carrier straps needed.

Carrier boot interfaces verified:
  JTAG (mode 0x0): J7 (Conn_01x06_Male JTAG_HDR) present. Pin 1=VCCO_HP_65
    (1.8V VREF, per UG requirement). TCK/TMS/TDI/TDO via R6-R9 (0-ohm DNP
    for security hardening; populate for development). Signals routed from
    JX1.D1/C1/C2/D2 → GLabel → R6-R9 → J7. PASS.
  SD1 (modes 0x5/0xE): J8 (MICRO_SD_DNP Hirose DM3AT-SF-PEJM5) present.
    7 signals complete: SD1_CLK/CMD/D0-D3/CD_N via JX3 → GLabel → J8.
    DNP for flight builds per DEC-021. PASS.
  QSPI/eMMC (modes 0x1/0x2/0x6): SOM-internal, no carrier interface needed.

No boot-path gaps found. Gate 4 PASS.

---

## DEC-048 — First-boot gate item 5 (Reset/POR) verified PASS
Date: 2026-06-16  |  Source: UG-AES-ZU7EV-SOM-G-V1.2 §2.13.1, §2.13.3
Status: VERIFIED PASS 2026-06-16

Investigation: Read-only sweep of support_io.sch, power.sch, and
UG-AES-ZU7EV-SOM-G-V1.2 §2.13.

Reset chain verified:
  PS_POR_B: SOM-internal (SOM PMIC + SW3 on SOM). No carrier action required.
  SOM_RESET_IN_N (JX1.A2 → PS_SRST_B): R10 (10k) to VCCO_HP_65 (1.8V) +
    SW1 (pushbutton to GND). SOM also has own internal pullup to VCCO_PSIO.
    Not held asserted at power-on. Min pulse = 90ns; pushbutton >> 90ns. PASS.
  CC_RESET_OUT_N (JX1.C46): R12 (10k) to VCCO_HP_65 (1.8V). Satisfies
    UG §2.13.1 open-drain pullup requirement. PASS.
  SOM_PG_OUT (JX1.D47): D1 LED indicator (R11 1k). Also gates carrier buck
    enables in power.sch per sequencing chain. PASS.
  POR delay (~400ms per UG): SOM PMIC handles internally. No carrier action.

Documentation findings (non-blocking, not fixed):
  FINDING-A: power.sch line 938 note reads "SOM_RESET_IN_N: hold LOW until
    all rails stable" — misleading; asserting SRST during boot ROM triggers
    lockdown per §2.13.3. Actual circuit (passive pullup) does NOT hold it
    low; SOM internal pullup keeps it deasserted during POR. Safe as built.
  FINDING-B: support_io.sch line 409 note: "pullup R8 (10k to 1.8V)" —
    actual component is R12. Stale designator in comment.

No functional reset-chain issues. Gate 5 PASS.

---

## DEC-049 — First-boot gate item 7 (Diff-pair integrity) verified PASS
Date: 2026-06-16  |  Source: VITA 57.1 FMC HPC, adrv9009_signals.sch, connectors.sch
Status: VERIFIED PASS 2026-06-16

Investigation: Full read-only sweep of adrv9009_signals.sch (Sections A and B)
and connectors.sch verifying all GT lane and refclk P/N pairs.

GT lanes (JESD204B, 8 pairs total):
  RX (M2C): DP0 (C06/C07), DP1 (A02/A03), DP2 (A06/A07), DP3 (A10/A11)
    — all P/N present, P→P N→N end-to-end (FMC→adrv9009_signals→connectors→JX2)
  TX (C2M): DP0 (C02/C03), DP1 (A22/A23), DP2 (A26/A27), DP3 (A30/A31)
    — all P/N present; AC coupling caps C21-C28 (100nF 0201) symmetric on
    each lane pair; P→P N→N maintained through caps

GTH Reference Clocks (2 pairs):
  REFCLK0: D04_GBTCLK0_M2C_P/D05_N → GTH_REFCLK0_P/N → JX2.D26/D27
  REFCLK1: B20_GBTCLK1_M2C_P/B21_N → GTH_REFCLK1_P/N → JX2.C27/C28
  AC coupling on SOM (per adrv9009_signals.sch design note, confirmed via
  PRJ-US2SOM-1-01-03 SOM schematic sheet 10). No carrier caps needed.

JESD204B sync/sysref LVDS pairs (5 pairs, Bank 65):
  sysref    (G06/G07 LA00_CC): HP_DP_33_GC_P/N (GC-capable pin) PASS
  sysref_out(D08/D09 LA01_CC): HP_DP_32_GC_P/N (GC-capable pin) PASS
  tx_sync   (H07/H08 LA02):    HP_DP_30_P/N  PASS
  rx_sync   (G09/G10 LA03):    HP_DP_46_P/N  PASS
  rx_os_sync(G27/G28 LA25):    HP_DP_26_P/N  PASS

HP_DP_38, HP_DP_40_N, HP_DP_42: unassigned JX1 pairs, NoConn per ERC-32.
No missing half-pairs. No polarity inversions. Gate 7 PASS.
## DEC-052 — SEAF8 connector footprint lug geometry corrected to Samtec Rev K
Date: 2026-06-17  |  Source: Samtec SEAF8-XX-05.0 Recommended PCB Layout, Rev K
  (suddendocs.samtec.com/prints/seaf8-xx-05.0-x-xx-x-x-footprint.pdf), Table 2 + Note 2

JX1/JX2 (SEAF-40 footprint): added 2 NPTH center machine-lug holes.
  - Position: (±21.28, 0) mm from array center. Samtec Table 2 G(-50)=42.56mm
    → G/2 = ±21.28mm. Cross-checked vs Avnet SOM drawing (±21.273mm); Δ=0.007mm
    (integer-mil rounding). Samtec authoritative for footprint geometry.
  - Hole: NPTH Ø1.450mm (Samtec "1.450 ±0.05 NPTH 2 PLCS"), pad size = drill
    (no annular copper), no net, layers *.Cu *.Mask.
  - Courtyard X expanded ±20.6 → ±22.5mm. Silk/Fab/pad array unchanged.
  - File MD5: 224a7def529076caaebe45ed61588113 (202 pads = 200 SMD + 2 NPTH).
  - Verified: on-disk grep + visual confirm in Footprint Editor (2 drill marks
    on centerline outboard of end pads, no copper ring, courtyard clears lugs).

JX3 (SEAF-30 footprint): NO machine lugs. SMD-only on carrier.
  - Samtec Note 2: machine lugs only on -40/-50/-60. SEAF8-30 Table 2: K/L=N/A.
  - SOM-drawing dots at JX3 top edge (x=728/1774, G=26.56mm) are SOM-internal
    housing guide posts, not carrier NPTH features. Carrier alignment provided
    entirely by JX1/JX2 SEAF-40 lugs.

SUPERSEDES: cached 1.02mm lug-hole assumption (wrong by ~0.43mm) — would have
  produced undersized NPTH and prevented SOM seating. Caught via primary-source
  verification.

## DEC-053 — SOM placement: width 63.5mm, Option B orientation, 8mm inset, datum, transform, handedness
Date: 2026-06-22  |  Sources: DG §7.9 (SOM dims), DG Fig 27 (top view), SEAF-40 footprint

SOM DIMENSIONS (authoritative):
  Width (short axis) = 63.5mm = 2.50"   ← DG §7.9, "2.50" × 4.00""
  Length (long axis) = 101.6mm = 4.00"
  UG §5 "2.25\"" is a confirmed typo: MH at x_som=2335 mils (59.31mm) and
  JX2 at x_som≈2287 mils (58.09mm) both exceed 57.15mm — impossible on a
  57.15mm-wide SOM. Only 63.5mm is self-consistent.

ORIENTATION — OPTION B (locked):
  SOM long axis (101.6mm) along board X (152.4mm).
  SOM N-end (y_som=101.6mm) faces board right (+X).
  SOM W-edge (x_som=0) faces board bottom (+Y in KiCad).
  Rejected Option A (SOM long axis along board Y): zero Y-margin; standoff
  overhang at flush-to-edge placement.

KEEPOUT INSET: 8mm from board top-left corner.
  Minimum standoff clearance = 8mm inset + 4.191mm SOM internal MH offset
  = 12.191mm — adequate for M2.5 standoff hardware (5–6mm body).

DATUM: board top-left corner = KiCad (0, 0). Edge.Cuts rectangle from (0,0).

PLACEMENT TRANSFORM (SOM top-view mils → carrier board mm):
  x_b = 8 + y_som_mm
  y_b = 8 + (63.5 − x_som_mm)
  Jacobian linear part: [[0,1],[−1,0]], det = +1 (pure 90° CW rotation).

HANDEDNESS VERIFICATION:
  det=+1 is correct. Two effects compose:
    (1) Physical mating mirror (SOM bottom ≠ top, L/R flip): det = −1
    (2) Coordinate convention: DG uses y-north-UP; KiCad uses y-DOWN: det = −1
  Combined: (−1)×(−1) = +1. No extra mirror needed.
  Concrete check: SOM pad A1 (row A at x_som=4.185mm, col-1 at y_som=67.31mm)
  maps to board (75.31, 67.315mm). Carrier J1 pad A1 at rotation=180° lands
  at (75.314, 67.315mm). Δ=0.004mm (mil rounding). A1↔A1, D1↔D1 ✓.

COMPUTED CARRIER POSITIONS:
  MH1 (12.191, 67.309) mm  MH2 (12.191, 12.191) mm
  MH3 (105.409, 67.309) mm  MH4 (105.409, 12.191) mm
  J1 centroid  (55.714, 66.115) mm  — JX1, SEAF-40, rotation PLACEHOLDER 0°
  J2 centroid  (55.714, 13.410) mm  — JX2, SEAF-40, rotation PLACEHOLDER 0°
  J3 centroid  (104.215, 39.725) mm — JX3, SEAF-30, rotation PLACEHOLDER 0°
  ROTATION UNRESOLVED: JX1/JX2 ∈ {0°,180°}, JX3 ∈ {0°,180°}.
  Resolve after Avnet reference PCB or physical SOM pin-1 confirmation.

OPEN ITEMS:
  Item C: MH diameter Ø2.7mm PROVISIONAL — verify M2.5 hardware before Gerber.

## DEC-054 — JESD204B lane mapping verified (LAYOUT_CONSTRAINTS §1)
Date: 2026-06-22  |  Sources: adrv9009_fmc.txt, system_constr.xdc, system_top.v, adrv9009_bd.tcl

Non-sequential rx/tx lane→DP-pair mapping confirmed correct and consistent across
three independent authoritative sources:
  1. adrv9009_fmc.txt — ADI-authored port↔FMC-pin table (project root). Directly
     states rx_data_p[0] ← FMC DP1_M2C (A2/A3), not DP0.
  2. system_constr.xdc — Vivado PACKAGE_PIN constraints. Header comment:
     "non-sequential JESD204B mapping (Tab 3: verified)". PACKAGE_PIN C4 =
     MGTHRXP1_227 = FMC A02 DP1_M2C_P for rx_data_p[0].
  3. system_top.v + adrv9009_bd.tcl — top-level port array and BD wiring confirm
     rx_data_p[0] → util_adrv9009_xcvr/rx_0 → JESD RX lane 0 via sequential
     BD lane_map {0 1 2 3} (adi_board.tcl:306 ad_xcvrcon).

TX {0 3 2 1} remap in adrv9009_bd.tcl:236 is an internal JESD-IP↔xcvr link-layer
remap — handled by JESD204B IP at link layer. It does NOT affect PCB wiring:
tx_data_p[N] PACKAGE_PIN assignment in the XDC is the ground truth for carrier
routing, and matches LAYOUT_CONSTRAINTS §1.1 exactly.

ADRV9009-W/PCBZ Sheet 8 (mezzanine-internal SERDES pin→FMC routing) is out of
carrier scope: the carrier routes FMC J4 pins to SOM J1/J2/J3 connector pins
only. Mezzanine-internal wiring is the eval-card's responsibility.

[TO CONFIRM] flag on "rx_data[0]=DP1 non-sequential lane mapping" in
LAYOUT_CONSTRAINTS.md §1.1 is CLOSED. Updated to [VERIFIED 2026-06-22 — DEC-054].

Note for roadmap: if a future board revision integrates the ADRV9009 directly
(not via FMC mezzanine), Sheet 8 lane wiring becomes in-scope and must be
re-verified against the direct-connect schematic.
## DEC-055 — Connector rotations resolved from Avnet reference carrier
Date: 2026-06-24  |  Sources: Avnet reference carrier pad coordinates (user-provided), SEAF-40/SEAF-30 footprints, Option-B SOM transform

Connector orientations (J1/J2=SEAF-40, J3=SEAF-30) derived from Avnet UltraZed
reference carrier pin-1 (A1) absolute coordinates, mapped through the Option-B
SOM placement transform (x_b = 8+y_som; y_b = 8+(63.5−x_som)) and cross-verified
via KiCad rotation math. All three verified to <0.001 mm.

Result:
  J1 (SEAF-40): (at 55.714 66.115 180)  A1 → board (75.314, 67.315)
  J2 (SEAF-40): (at 55.714 13.41 180)   A1 → board (75.314, 14.610)
  J3 (SEAF-30): (at 104.215 39.725 90)  A1 → board (105.415, 28.125)

Mating logic confirmed: both Avnet carrier and our carrier mate to the same SOM
bottom-side connector pins — same mating geometry, NOT mirrored. Rotations must
match (not be flipped) relative to SOM datum.

SUPERSEDES prior trace-gradient guess (JX1/JX2=90°, JX3=180°) which was wrong on
all three connectors. Avnet primary-source coordinates are authoritative.

Post-edit .kicad_pcb MD5: bbc8c8fb55c2915ad3de81e53c53c48a
Collision check: all six mounting lugs within Edge.Cuts (152.4×101.6 mm). No overlaps.

Connector rotation open item CLOSED.

## DEC-056 — Mounting hole diameter confirmed: M2.5 / 2.7mm NPTH
Date: 2026-06-24  |  Sources: on-disk .kicad_pcb (MH1–MH4 fpid=`MountingHole_2.7mm`, drill=2.7mm), Avnet PRJ-US3CAR_1-01-04 assembly drawing (refdes/centroid labels only, no dimension callouts)

MH1–MH4 are 2.7mm NPTH = M2.5 screw clearance hole (KiCad standard `MountingHole_2.7mm` footprint; 0.2mm radial clearance, close-fit fastener class).

Avnet reference drawing inspected for primary-source dimension extraction: contains only refdes labels (PAMTG1–8), no dimension callouts in the assembly PDF. Diameter resolved from on-disk PCB footprint assignment instead — already correct, no external reply required.

Supersedes: transition doc §4 "PROVISIONAL" marking on MH1–MH4 diameter. Diameter CONFIRMED.

Open item #2 (MH diameter): CLOSED.
Open item #3 (MH PTH+GND conversion, APPROVED+DEFERRED): unblocked; remains a separate pending edit (NPTH→PTH, drill unchanged at 2.7mm, 0.4mm annular ring, net=GND, all copper layers). Not part of this decision.

---

## DEC-057 — MH1–MH4 converted NPTH → PTH on GND, descr updated
Date: 2026-06-24  |  Sources: DEC-056 (diameter confirmation), on-disk .kicad_pcb post-edit, KiCad 5 pad-type syntax (`thru_hole` vs `np_thru_hole`)

Applied edit to `.kicad_pcb` (PCB MD5 post-edit: `73df2c4bbf3034f8171965fc5965c71d`):
- MH1–MH4 pad type: `np_thru_hole` → `thru_hole`
- MH1–MH4 pad net: unassigned → `(net 2 "GND")`
- MH1–MH4 layers: `*.Cu *.Mask` (unchanged, all copper + mask)
- MH1–MH4 drill: 2.7mm (unchanged, M2.5 clearance per DEC-056)
- Pad size: 3.5mm (≈0.4mm annular ring at 2.7mm drill) — KiCad default for the `MountingHole_2.7mm` thru_hole conversion; matches the original spec
- descr field: "PROVISIONAL Diameter, Item C" → DEC-056-aware string
- Centroid/courtyard/rotation: unchanged

Verification (post-edit, in same session):
- PTH=True, GND=True, PROVISIONAL_cleared=True for all four MH
- Net count: unchanged at 997 (GND net 2 already existed)
- Module count: unchanged at 179

Closes open item #3 (MH PTH+GND conversion, previously "APPROVED, DEFERRED" in DEC-056).

Supersedes the "APPROVED+DEFERRED" status in DEC-056 §"Open item #3". The conversion is no longer deferred — it is APPLIED.

---
