AgileRadioCom-LLC/ARC-Re-Packaging-Design/COMPONENT_INVENTORY.md

# UZEV Carrier — Component Inventory with Purpose

Total real components: 150

Purpose marked "CONFIRM" = not pinned by DEC log/datasheet; needs design-intent confirmation before third-party sign-off.

| Ref | Value | Footprint | Sheet | Purpose |
|---|---|---|---|---|
| B1 | TPS54320 | VQFN-14-1EP_3.5x3.5mm_P0.5mm_EP2.05x2.05mm | power | Buck regulator block — 12V→intermediate rail |
| B2 | TPS54320 | VQFN-14-1EP_3.5x3.5mm_P0.5mm_EP2.05x2.05mm | power | Buck regulator block — 12V→intermediate rail |
| B3 | TPS54320 | VQFN-14-1EP_3.5x3.5mm_P0.5mm_EP2.05x2.05mm | power | Buck regulator block — 12V→intermediate rail |
| B4 | TPS54320 | VQFN-14-1EP_3.5x3.5mm_P0.5mm_EP2.05x2.05mm | power | Buck regulator block — 12V→intermediate rail |
| B5 | TPS54531 | SOIC-8-1EP_3.9x4.9mm_P1.27mm_EP2.95x4.9mm_Mask2.71x3.4mm | power | Buck regulator block — 12V→intermediate rail |
| C1 | 100nF | C_0402_1005Metric | power | Decoupling cap (inferred — CONFIRM net/IC) |
| C2 | 47uF | C_1210_3225Metric | power | Bulk cap (inferred — CONFIRM rail) |
| C3 | 10uF | C_0805_2012Metric | power | Bulk cap (inferred — CONFIRM rail) |
| C4 | 33uF | C_1210_3225Metric | power | Capacitor (inferred — CONFIRM) |
| C5 | 33uF | C_1210_3225Metric | power | Capacitor (inferred — CONFIRM) |
| C6 | 100nF | C_0402_1005Metric | power | Decoupling cap (inferred — CONFIRM net/IC) |
| C7 | 100nF | C_0402_1005Metric | power | Decoupling cap (inferred — CONFIRM net/IC) |
| C8 | 47uF | C_1210_3225Metric | power | Bulk cap (inferred — CONFIRM rail) |
| C9 | 10uF | C_0805_2012Metric | power | Bulk cap (inferred — CONFIRM rail) |
| C10 | 4.7uF | C_0805_2012Metric | power | Capacitor (inferred — CONFIRM) |
| C11 | 100nF | C_0402_1005Metric | power | Decoupling cap (inferred — CONFIRM net/IC) |
| C12 | 100nF | C_0402_1005Metric | power | Decoupling cap (inferred — CONFIRM net/IC) |
| C13 | 47uF | C_1210_3225Metric | power | Bulk cap (inferred — CONFIRM rail) |
| C14 | 10uF | C_0805_2012Metric | power | Bulk cap (inferred — CONFIRM rail) |
| C15 | 100nF | C_0402_1005Metric | power | Decoupling cap (inferred — CONFIRM net/IC) |
| C16 | 47uF | C_1210_3225Metric | power | Bulk cap (inferred — CONFIRM rail) |
| C17 | 100nF | C_0402_1005Metric | power | Decoupling cap (inferred — CONFIRM net/IC) |
| C18 | 47uF | C_1210_3225Metric | power | Bulk cap (inferred — CONFIRM rail) |
| C19 | 10uF | C_0805_2012Metric | power | Bulk cap (inferred — CONFIRM rail) |
| C21 | 100nF | C_0201_0603Metric | adrv9009_signals | Decoupling cap (inferred — CONFIRM net/IC) |
| C22 | 100nF | C_0201_0603Metric | adrv9009_signals | Decoupling cap (inferred — CONFIRM net/IC) |
| C23 | 100nF | C_0201_0603Metric | adrv9009_signals | Decoupling cap (inferred — CONFIRM net/IC) |
| C24 | 100nF | C_0201_0603Metric | adrv9009_signals | Decoupling cap (inferred — CONFIRM net/IC) |
| C25 | 100nF | C_0201_0603Metric | adrv9009_signals | Decoupling cap (inferred — CONFIRM net/IC) |
| C26 | 100nF | C_0201_0603Metric | adrv9009_signals | Decoupling cap (inferred — CONFIRM net/IC) |
| C27 | 100nF | C_0201_0603Metric | adrv9009_signals | Decoupling cap (inferred — CONFIRM net/IC) |
| C28 | 100nF | C_0201_0603Metric | adrv9009_signals | Decoupling cap (inferred — CONFIRM net/IC) |
| C29 | 100nF | C_0402_1005Metric | support_io | Decoupling cap (inferred — CONFIRM net/IC) |
| C40 | 100nF | C_0402_1005Metric | power | Decoupling cap (inferred — CONFIRM net/IC) |
| C41 | 100nF | C_0402_1005Metric | power | Decoupling cap (inferred — CONFIRM net/IC) |
| C42 | 100nF | C_0402_1005Metric | power | Decoupling cap (inferred — CONFIRM net/IC) |
| C43 | 100nF | C_0402_1005Metric | power | Decoupling cap (inferred — CONFIRM net/IC) |
| C44 | 100nF | C_0402_1005Metric | power | Decoupling cap (inferred — CONFIRM net/IC) |
| C45 | 15nF | C_0402_1005Metric | power | Capacitor (inferred — CONFIRM) |
| C46 | 15nF | C_0402_1005Metric | power | Capacitor (inferred — CONFIRM) |
| C47 | 15nF | C_0402_1005Metric | power | Capacitor (inferred — CONFIRM) |
| C48 | 15nF | C_0402_1005Metric | power | Capacitor (inferred — CONFIRM) |
| C49 | 2200pF | C_0402_1005Metric | power | HF filter cap (inferred — CONFIRM net) |
| C50 | 330pF | C_0402_1005Metric | power | HF filter cap (inferred — CONFIRM net) |
| C51 | 330pF | C_0402_1005Metric | power | HF filter cap (inferred — CONFIRM net) |
| C52 | 330pF | C_0402_1005Metric | power | HF filter cap (inferred — CONFIRM net) |
| C53 | 330pF | C_0402_1005Metric | power | HF filter cap (inferred — CONFIRM net) |
| C54 | 22pF | C_0402_1005Metric | power | HF filter cap (inferred — CONFIRM net) |
| C55 | 10nF | C_0402_1005Metric | power | Capacitor (inferred — CONFIRM) |
| C56 | 10nF | C_0402_1005Metric | power | Capacitor (inferred — CONFIRM) |
| C57 | 10nF | C_0402_1005Metric | power | Capacitor (inferred — CONFIRM) |
| C58 | 10nF | C_0402_1005Metric | power | Capacitor (inferred — CONFIRM) |
| C59 | 10nF | C_0402_1005Metric | power | Capacitor (inferred — CONFIRM) |
| C60 | 10uF | C_0805_2012Metric | power | Bulk cap (inferred — CONFIRM rail) |
| C61 | 100nF | C_0402_1005Metric | power | Decoupling cap (inferred — CONFIRM net/IC) |
| C62 | 10uF | C_0805_2012Metric | power | Bulk cap (inferred — CONFIRM rail) |
| C63 | 330pF | C_0402_1005Metric | power | HF filter cap (inferred — CONFIRM net) |
| C64 | 330pF | C_0402_1005Metric | power | HF filter cap (inferred — CONFIRM net) |
| C65 | 47uF | C_1210_3225Metric | power | Bulk cap (inferred — CONFIRM rail) |
| C66 | 100nF | C_0402_1005Metric | power | Decoupling cap (inferred — CONFIRM net/IC) |
| C67 | 100nF | C_0402_1005Metric | power | Decoupling cap (inferred — CONFIRM net/IC) |
| D1 | GREEN | LED_0603_1608Metric | support_io | Diode (confirm: protection/indicator) |
| D2 | CDBC540-G | D_SOD-123 | power | Diode (confirm: protection/indicator) |
| IND1 | 4.7uH | L_1210_3225Metric | power | CONFIRM |
| IND2 | 4.7uH | L_1210_3225Metric | power | CONFIRM |
| IND3 | 4.7uH | L_1210_3225Metric | power | CONFIRM |
| IND4 | 4.7uH | L_1210_3225Metric | power | CONFIRM |
| IND5 | 4.7uH | L_1210_3225Metric | power | CONFIRM |
| J1 | JX1 | SEAF-40-05.0-S-10-2-A-K-TR_200P | connectors | Connector (confirm: SOM/FMC/JTAG/SD) |
| J1 | JX1 | SEAF-40-05.0-S-10-2-A-K-TR_200P | connectors | Connector (confirm: SOM/FMC/JTAG/SD) |
| J1 | JX1 | SEAF-40-05.0-S-10-2-A-K-TR_200P | connectors | Connector (confirm: SOM/FMC/JTAG/SD) |
| J1 | JX1 | SEAF-40-05.0-S-10-2-A-K-TR_200P | connectors | Connector (confirm: SOM/FMC/JTAG/SD) |
| J2 | JX2 | SEAF-40-05.0-S-10-2-A-K-TR_200P | connectors | Connector (confirm: SOM/FMC/JTAG/SD) |
| J2 | JX2 | SEAF-40-05.0-S-10-2-A-K-TR_200P | connectors | Connector (confirm: SOM/FMC/JTAG/SD) |
| J2 | JX2 | SEAF-40-05.0-S-10-2-A-K-TR_200P | connectors | Connector (confirm: SOM/FMC/JTAG/SD) |
| J2 | JX2 | SEAF-40-05.0-S-10-2-A-K-TR_200P | connectors | Connector (confirm: SOM/FMC/JTAG/SD) |
| J3 | JX3 | SEAF-30-05.0-S-10-2-A-K-TR_120P | connectors | Connector (confirm: SOM/FMC/JTAG/SD) |
| J3 | JX3 | SEAF-30-05.0-S-10-2-A-K-TR_120P | connectors | Connector (confirm: SOM/FMC/JTAG/SD) |
| J3 | JX3 | SEAF-30-05.0-S-10-2-A-K-TR_120P | connectors | Connector (confirm: SOM/FMC/JTAG/SD) |
| J3 | JX3 | SEAF-30-05.0-S-10-2-A-K-TR_120P | connectors | Connector (confirm: SOM/FMC/JTAG/SD) |
| J4 | FMC_HPC_ADRV9009 | Samtec_FMC_ASP-134602-01_10x40_P1.27mm_Vertical | connectors | Connector (confirm: SOM/FMC/JTAG/SD) |
| J4 | FMC_HPC_ADRV9009 | Samtec_FMC_ASP-134602-01_10x40_P1.27mm_Vertical | connectors | Connector (confirm: SOM/FMC/JTAG/SD) |
| J4 | FMC_HPC_ADRV9009 | Samtec_FMC_ASP-134602-01_10x40_P1.27mm_Vertical | connectors | Connector (confirm: SOM/FMC/JTAG/SD) |
| J4 | FMC_HPC_ADRV9009 | Samtec_FMC_ASP-134602-01_10x40_P1.27mm_Vertical | connectors | Connector (confirm: SOM/FMC/JTAG/SD) |
| J4 | FMC_HPC_ADRV9009 | Samtec_FMC_ASP-134602-01_10x40_P1.27mm_Vertical | connectors | Connector (confirm: SOM/FMC/JTAG/SD) |
| J4 | FMC_HPC_ADRV9009 | Samtec_FMC_ASP-134602-01_10x40_P1.27mm_Vertical | connectors | Connector (confirm: SOM/FMC/JTAG/SD) |
| J4 | FMC_HPC_ADRV9009 | Samtec_FMC_ASP-134602-01_10x40_P1.27mm_Vertical | connectors | Connector (confirm: SOM/FMC/JTAG/SD) |
| J4 | FMC_HPC_ADRV9009 | Samtec_FMC_ASP-134602-01_10x40_P1.27mm_Vertical | connectors | Connector (confirm: SOM/FMC/JTAG/SD) |
| J4 | FMC_HPC_ADRV9009 | Samtec_FMC_ASP-134602-01_10x40_P1.27mm_Vertical | connectors | Connector (confirm: SOM/FMC/JTAG/SD) |
| J4 | FMC_HPC_ADRV9009 | Samtec_FMC_ASP-134602-01_10x40_P1.27mm_Vertical | connectors | Connector (confirm: SOM/FMC/JTAG/SD) |
| J5 | USB_C_Receptacle | (none) | power | USB-C receptacle — power input (VBUS/GND/CC1/CC2) |
| J6 | UART_HDR | PinHeader_1x04_P2.54mm_Vertical | support_io | Connector (confirm: SOM/FMC/JTAG/SD) |
| J7 | JTAG_HDR | PinHeader_1x06_P2.54mm_Vertical | support_io | Connector (confirm: SOM/FMC/JTAG/SD) |
| J8 | MICRO_SD_DNP | microSD_HC_Hirose_DM3AT-SF-PEJM5 | support_io | Connector (confirm: SOM/FMC/JTAG/SD) |
| L1 | TPS7A85 | QFN-20-1EP_3.5x3.5mm_P0.5mm_EP2x2mm | power | Inductor — buck output filter (confirm rail) |
| L2 | TPS7A85 | QFN-20-1EP_3.5x3.5mm_P0.5mm_EP2x2mm | power | Inductor — buck output filter (confirm rail) |
| L3 | TPS7A85 | QFN-20-1EP_3.5x3.5mm_P0.5mm_EP2x2mm | power | Inductor — buck output filter (confirm rail) |
| L4 | TPS7A85 | QFN-20-1EP_3.5x3.5mm_P0.5mm_EP2x2mm | power | Inductor — buck output filter (confirm rail) |
| R1 | 2.2k | R_0402_1005Metric | support_io | Resistor (inferred — CONFIRM: divider/pullup/term) |
| R2 | 2.2k | R_0402_1005Metric | support_io | Resistor (inferred — CONFIRM: divider/pullup/term) |
| R3 | 10k | R_0402_1005Metric | support_io | Resistor (inferred — CONFIRM: divider/pullup/term) |
| R4 | 0R_DNP | R_0402_1005Metric | support_io | Resistor (inferred — CONFIRM: divider/pullup/term) |
| R5 | 0R_DNP | R_0402_1005Metric | support_io | Resistor (inferred — CONFIRM: divider/pullup/term) |
| R6 | 0R_DNP | R_0402_1005Metric | support_io | Resistor (inferred — CONFIRM: divider/pullup/term) |
| R7 | 0R_DNP | R_0402_1005Metric | support_io | Resistor (inferred — CONFIRM: divider/pullup/term) |
| R8 | 0R_DNP | R_0402_1005Metric | support_io | Resistor (inferred — CONFIRM: divider/pullup/term) |
| R9 | 0R_DNP | R_0402_1005Metric | support_io | Resistor (inferred — CONFIRM: divider/pullup/term) |
| R10 | 10k | R_0402_1005Metric | support_io | Resistor (inferred — CONFIRM: divider/pullup/term) |
| R11 | 1k | R_0402_1005Metric | support_io | Resistor (inferred — CONFIRM: divider/pullup/term) |
| R12 | 10k | R_0402_1005Metric | support_io | Resistor (inferred — CONFIRM: divider/pullup/term) |
| R13 | 88.7k | R_0402_1005Metric | power | Resistor (inferred — CONFIRM: divider/pullup/term) |
| R14 | 100k | R_0402_1005Metric | power | Resistor (inferred — CONFIRM: divider/pullup/term) |
| R15 | 124k | R_0402_1005Metric | power | Resistor (inferred — CONFIRM: divider/pullup/term) |
| R16 | 100k | R_0402_1005Metric | power | Resistor (inferred — CONFIRM: divider/pullup/term) |
| R17 | 215k | R_0402_1005Metric | power | Resistor (inferred — CONFIRM: divider/pullup/term) |
| R18 | 100k | R_0402_1005Metric | power | Resistor (inferred — CONFIRM: divider/pullup/term) |
| R19 | 215k | R_0402_1005Metric | power | Resistor (inferred — CONFIRM: divider/pullup/term) |
| R20 | 100k | R_0402_1005Metric | power | Resistor (inferred — CONFIRM: divider/pullup/term) |
| R21 | 316k | R_0402_1005Metric | power | Resistor (inferred — CONFIRM: divider/pullup/term) |
| R22 | 100k | R_0402_1005Metric | power | Resistor (inferred — CONFIRM: divider/pullup/term) |
| R23 | 12.4k | R_0402_1005Metric | power | Resistor (inferred — CONFIRM: divider/pullup/term) |
| R24 | 100k | R_0402_1005Metric | power | Resistor (inferred — CONFIRM: divider/pullup/term) |
| R25 | 49.9k | R_0402_1005Metric | power | Resistor (inferred — CONFIRM: divider/pullup/term) |
| R26 | 100k | R_0402_1005Metric | power | Resistor (inferred — CONFIRM: divider/pullup/term) |
| R27 | 124k | R_0402_1005Metric | power | Resistor (inferred — CONFIRM: divider/pullup/term) |
| R28 | 100k | R_0402_1005Metric | power | Resistor (inferred — CONFIRM: divider/pullup/term) |
| R29 | 124k | R_0402_1005Metric | power | Resistor (inferred — CONFIRM: divider/pullup/term) |
| R30 | 100k | R_0402_1005Metric | power | Resistor (inferred — CONFIRM: divider/pullup/term) |
| R31 | 1.78k | R_0402_1005Metric | power | Resistor (inferred — CONFIRM: divider/pullup/term) |
| R32 | 1.78k | R_0402_1005Metric | power | Resistor (inferred — CONFIRM: divider/pullup/term) |
| R33 | 1.78k | R_0402_1005Metric | power | Resistor (inferred — CONFIRM: divider/pullup/term) |
| R34 | 1.78k | R_0402_1005Metric | power | Resistor (inferred — CONFIRM: divider/pullup/term) |
| R35 | 37.4k | R_0402_1005Metric | power | Resistor (inferred — CONFIRM: divider/pullup/term) |
| R36 | 100k | R_0402_1005Metric | power | Resistor (inferred — CONFIRM: divider/pullup/term) |
| R37 | 100k | R_0402_1005Metric | power | Resistor (inferred — CONFIRM: divider/pullup/term) |
| R38 | 100k | R_0402_1005Metric | power | Resistor (inferred — CONFIRM: divider/pullup/term) |
| R39 | 100k | R_0402_1005Metric | power | Resistor (inferred — CONFIRM: divider/pullup/term) |
| R40 | 91k | R_0402_10COMPONENT_INVENTORY.md05Metric | power | Resistor (inferred — CONFIRM: divider/pullup/term) |
| R41 | 11k | R_0402_1005Metric | power | Resistor (inferred — CONFIRM: divider/pullup/term) |
| R42 | 82k | R_0402_1005Metric | power | Resistor (inferred — CONFIRM: divider/pullup/term) |
| R43 | 20k | R_0402_1005Metric | power | Resistor (inferred — CONFIRM: divider/pullup/term) |
| R44 | 100k | R_0402_1005Metric | power | Resistor (inferred — CONFIRM: divider/pullup/term) |
| R45 | 4.7k | R_0402_1005Metric | power | Resistor (inferred — CONFIRM: divider/pullup/term) |
| R46 | 10k | R_0402_1005Metric | power | Resistor (inferred — CONFIRM: divider/pullup/term) |
| R47 | 10k | R_0402_1005Metric | power | Resistor (inferred — CONFIRM: divider/pullup/term) |
| R48 | 10k | R_0402_1005Metric | power | Resistor (inferred — CONFIRM: divider/pullup/term) |
| R49 | 10k | R_0402_1005Metric | power | Resistor (inferred — CONFIRM: divider/pullup/term) |
| SW1 | RESET | SW_SPST_CK_RS282G05A3 | support_io | CONFIRM |
| U6 | TPS25730D | (none) | power | USB-C PD sink controller — negotiates 12–15V/3A from VBUS, drives VIN |
| U7 | TPS7A1633 | (none) | power | Bootstrap LDO — VBUS→3.3V to power PD controller before contract |
