AgileRadioCom-LLC/ARC-Re-Packaging-Design/BOM_snapshot_20260428.xlsx

Sheet: BOM
⚠ SNAPSHOT – NOT FINAL BOM | Phase 5c incomplete | DO NOT USE FOR PROCUREMENT
RefDes(es) | Qty | Value / Part Number | Footprint | Sheet | Status | Notes
C21, C22, C23, C24, C25, C26, C27, C28 | 8 | 100nF | Capacitor_SMD:C_0201_0603Metric | adrv9009_signals | STABLE
J4 | 1 | FMC_HPC_ADRV9009 | Connector_Samtec:Samtec_FMC_ASP-134602-01_10x40_P1.27mm_Vertical | connectors | STABLE
J1 | 1 | JX1 | UZEV_Connectors:SEAF-40-05.0-S-10-2-A-K-TR_200P | connectors | STABLE
J2 | 1 | JX2 | UZEV_Connectors:SEAF-40-05.0-S-10-2-A-K-TR_200P | connectors | STABLE
J3 | 1 | JX3 | UZEV_Connectors:SEAF-30-05.0-S-10-2-A-K-TR_120P | connectors | STABLE
J5 | 1 | 12V_DC_IN | Connector_BarrelJack:BarrelJack_Horizontal | power | STABLE
C6 | 1 | 100nF | 10uF | Capacitor_SMD:C_0402_1005Metric | Capacitor_SMD:C_0805_2012Metric | power | UNKNOWN_VALUE | Duplicate refdes with conflicting values: 100nF | 10uF. ERC error — needs resolution.
C4 | 1 | 33uF | 100nF | Capacitor_SMD:C_1210_3225Metric | Capacitor_SMD:C_0402_1005Metric | power | UNKNOWN_VALUE | Duplicate refdes with conflicting values: 33uF | 100nF. ERC error — needs resolution.
C5 | 1 | 33uF | 47uF | Capacitor_SMD:C_1210_3225Metric | power | UNKNOWN_VALUE | Duplicate refdes with conflicting values: 33uF | 47uF. ERC error — needs resolution.
C1, C7, C11, C12, C15 | 5 | 100nF | Capacitor_SMD:C_0402_1005Metric | power | WILL_CHANGE_IN_PHASE_5C | Power-tree bypass cap — value may be adjusted when Rfb/layout parasitics are resolved in Phase 5c.
C3, C9, C14 | 3 | 10uF | Capacitor_SMD:C_0805_2012Metric | power | WILL_CHANGE_IN_PHASE_5C | Power-tree bypass cap — value may be adjusted when Rfb/layout parasitics are resolved in Phase 5c.
C10 | 1 | 4.7uF | Capacitor_SMD:C_0805_2012Metric | power | WILL_CHANGE_IN_PHASE_5C | Power-tree bypass cap — value may be adjusted when Rfb/layout parasitics are resolved in Phase 5c.
C2, C8, C13, C16 | 4 | 47uF | Capacitor_SMD:C_1210_3225Metric | power | WILL_CHANGE_IN_PHASE_5C | Power-tree bypass cap — value may be adjusted when Rfb/layout parasitics are resolved in Phase 5c.
B1, B2, B3, B4 | 4 | TPS54320 | Package_DFN_QFN:VQFN-14-1EP_3.5x4.5mm_P0.65mm_EP2.1x3.1mm | power | WILL_CHANGE_IN_PHASE_5C | Phase 5c must add feedback resistors (Rfb divider) to set Vout; symbol is placeholder pending resistor network addition.
B5 | 1 | TPS54531 | Package_TO_SOT_SMD:PowerPAD_SO-8_EP_3.9x4.9mm_P1.27mm | power | WILL_CHANGE_IN_PHASE_5C | Phase 5c must add feedback resistors (Rfb divider) to set Vout; symbol is placeholder pending resistor network addition.
L1, L2, L3, L4 | 4 | TPS7A85 | Package_DFN_QFN:VQFN-20-1EP_3.5x3.5mm_P0.5mm_EP2.1x2.1mm | power | WILL_CHANGE_IN_PHASE_5C | TPS7A85 is adjustable-only; Rfb divider not yet in schematic. Phase 5c will add resistors and finalize Vout setpoint.
R4, R5, R6, R7, R8, R9 | 6 | 0R_DNP | Resistor_SMD:R_0402_1005Metric | support_io | STABLE
C29 | 1 | 100nF | Capacitor_SMD:C_0402_1005Metric | support_io | STABLE
R3, R10, R12 | 3 | 10k | Resistor_SMD:R_0402_1005Metric | support_io | STABLE
R11 | 1 | 1k | Resistor_SMD:R_0402_1005Metric | support_io | STABLE
R1, R2 | 2 | 2.2k | Resistor_SMD:R_0402_1005Metric | support_io | STABLE
D1 | 1 | GREEN | LED_SMD:LED_0603_1608Metric | support_io | STABLE
J7 | 1 | JTAG_HDR | Connector_PinHeader_2.54mm:PinHeader_1x06_P2.54mm_Vertical | support_io | STABLE
SW1 | 1 | RESET | Button_Switch_SMD:SW_SPST_CK_RS282G05A3 | support_io | STABLE
J6 | 1 | UART_HDR | Connector_PinHeader_2.54mm:PinHeader_1x04_P2.54mm_Vertical | support_io | STABLE

Sheet: Legend
Status | Meaning
STABLE | Part and footprint finalized; will not change before fab.
WILL_CHANGE_IN_PHASE_5C | Power tree part or associated cap — Phase 5c completes feedback resistors, Vout setpoints, and final bypass values. Values here are current-state placeholders.
NEEDS_FOOTPRINT | Footprint field is empty; cannot proceed to layout.
UNKNOWN_VALUE | Value field empty, or duplicate refdes with conflicting values (ERC error; resolve before use).
Phase 5c scope | Add Rfb dividers for TPS54320 (B1-B4) and TPS7A85 (L1-L4); finalize intermediate voltage setpoints; verify bypass cap values against datasheet Bode plots. DEF-11 blocks PCB layout until complete.
Prices / buy links | Intentionally absent. Prices stale within weeks; pull at purchase time via Digi-Key cart or distributor API.
