AgileRadioCom-LLC/ARC-Re-Packaging-Design/BOM_snapshot_20260428_v2.xlsx

Sheet: BOM
⚠ SNAPSHOT – NOT FINAL BOM | Phase 5c incomplete | DO NOT USE FOR PROCUREMENT | v2 2026-04-29
RefDes(es) | Qty | Value / Part Number | Footprint | Sheet | Status | Notes
SOM1 (module, not on carrier PCB) | 1 | AES-ZU7EV-1-SOM-G (Avnet UltraZed-EV SOM) | N/A — mounts via JX1/JX2/JX3 headers | — | STABLE | Confirmed price: $1,469 (distributor TBD). Not a carrier PCB component — ordered separately.
C21, C22, C23, C24, C25, C26, C27, C28 | 8 | 100nF | Capacitor_SMD:C_0201_0603Metric | adrv9009_signals | STABLE
J4 | 1 | FMC_HPC_ADRV9009 | Connector_Samtec:Samtec_FMC_ASP-134602-01_10x40_P1.27mm_Vertical | connectors | STABLE
J1 | 1 | JX1 | UZEV_Connectors:SEAF-40-05.0-S-10-2-A-K-TR_200P | connectors | STABLE
J2 | 1 | JX2 | UZEV_Connectors:SEAF-40-05.0-S-10-2-A-K-TR_200P | connectors | STABLE
J3 | 1 | JX3 | UZEV_Connectors:SEAF-30-05.0-S-10-2-A-K-TR_120P | connectors | STABLE
J5 | 1 | 12V_DC_IN | Connector_BarrelJack:BarrelJack_Horizontal | power | STABLE
C6 | 1 | 100nF | 10uF | Capacitor_SMD:C_0402_1005Metric | Capacitor_SMD:C_0805_2012Metric | power | UNKNOWN_VALUE | Duplicate refdes with conflicting values: 100nF | 10uF. ERC error.
C4 | 1 | 33uF | 100nF | Capacitor_SMD:C_1210_3225Metric | Capacitor_SMD:C_0402_1005Metric | power | UNKNOWN_VALUE | Duplicate refdes with conflicting values: 33uF | 100nF. ERC error.
C5 | 1 | 33uF | 47uF | Capacitor_SMD:C_1210_3225Metric | power | UNKNOWN_VALUE | Duplicate refdes with conflicting values: 33uF | 47uF. ERC error.
C1, C7, C11, C12, C15 | 5 | 100nF | Capacitor_SMD:C_0402_1005Metric | power | WILL_CHANGE_IN_PHASE_5C | Power-tree bypass cap — value may be tuned when Rfb/layout parasitics resolved in Phase 5c.
C3, C9, C14 | 3 | 10uF | Capacitor_SMD:C_0805_2012Metric | power | WILL_CHANGE_IN_PHASE_5C | Power-tree bypass cap — value may be tuned when Rfb/layout parasitics resolved in Phase 5c.
C10 | 1 | 4.7uF | Capacitor_SMD:C_0805_2012Metric | power | WILL_CHANGE_IN_PHASE_5C | Power-tree bypass cap — value may be tuned when Rfb/layout parasitics resolved in Phase 5c.
C2, C8, C13, C16 | 4 | 47uF | Capacitor_SMD:C_1210_3225Metric | power | WILL_CHANGE_IN_PHASE_5C | Power-tree bypass cap — value may be tuned when Rfb/layout parasitics resolved in Phase 5c.
B1, B2, B3, B4 | 4 | TPS54320 | Package_DFN_QFN:VQFN-14-1EP_3.5x4.5mm_P0.65mm_EP2.1x3.1mm | power | WILL_CHANGE_IN_PHASE_5C | Phase 5c must add Rfb divider to set Vout; symbol placed, resistor network pending.
B5 | 1 | TPS54531 | Package_TO_SOT_SMD:PowerPAD_SO-8_EP_3.9x4.9mm_P1.27mm | power | WILL_CHANGE_IN_PHASE_5C | Phase 5c must add Rfb divider to set Vout; symbol placed, resistor network pending.
L1, L2, L3, L4 | 4 | TPS7A85 | Package_DFN_QFN:VQFN-20-1EP_3.5x3.5mm_P0.5mm_EP2.1x2.1mm | power | WILL_CHANGE_IN_PHASE_5C | TPS7A85 adjustable-only; Rfb divider not in schematic. Phase 5c finalizes Vout setpoint.
R4, R5, R6, R7, R8, R9 | 6 | 0R_DNP | Resistor_SMD:R_0402_1005Metric | support_io | STABLE
C29 | 1 | 100nF | Capacitor_SMD:C_0402_1005Metric | support_io | STABLE
R3, R10, R12 | 3 | 10k | Resistor_SMD:R_0402_1005Metric | support_io | STABLE
R11 | 1 | 1k | Resistor_SMD:R_0402_1005Metric | support_io | STABLE
R1, R2 | 2 | 2.2k | Resistor_SMD:R_0402_1005Metric | support_io | STABLE
D1 | 1 | GREEN | LED_SMD:LED_0603_1608Metric | support_io | STABLE
J7 | 1 | JTAG_HDR | Connector_PinHeader_2.54mm:PinHeader_1x06_P2.54mm_Vertical | support_io | STABLE
SW1 | 1 | RESET | Button_Switch_SMD:SW_SPST_CK_RS282G05A3 | support_io | STABLE
J6 | 1 | UART_HDR | Connector_PinHeader_2.54mm:PinHeader_1x04_P2.54mm_Vertical | support_io | STABLE
— (not on carrier) | 1 | AD-FMCOMMS4-EBZ (ADI ADRV9009 FMC card) | N/A — plugs into J4 FMC HPC | — | EXTERNAL/DEV-ONLY | Development evaluation card. NOT part of carrier BOM. Plugs into J4 at bring-up; production designs integrate ADRV9009 directly on RF daughter card.

Sheet: Legend
Status | Meaning
STABLE | Part and footprint finalized; will not change before fab.
WILL_CHANGE_IN_PHASE_5C | Power tree part or associated cap — Phase 5c adds Rfb resistors and finalizes Vout setpoints.
NEEDS_FOOTPRINT | Footprint field empty; cannot proceed to layout.
UNKNOWN_VALUE | Empty value or duplicate refdes with conflicting values (ERC error).
EXTERNAL/DEV-ONLY | Not part of carrier PCB BOM. Ordered separately or development-only item.
SOM pricing | AES-ZU7EV-1-SOM-G: $1,469 confirmed. Distributor TBD at time of order.
No prices on carrier parts | Prices stale within weeks. Pull at purchase time via Digi-Key cart or distributor API.
