AgileRadioCom-LLC/ARC-Re-Packaging-Design/COMPONENT_INVENTORY_raw.csv

ref | value | lib_sym | footprint | sheet
#FLG01 | PWR_FLAG | power:PWR_FLAG |  | connectors
#FLG_SD01 | PWR_FLAG | power:PWR_FLAG |  | support_io
#FLG_V01 | PWR_FLAG | power:PWR_FLAG |  | power
#FLG_V02 | PWR_FLAG | power:PWR_FLAG |  | power
#PWR000A01 | GND | power:GND |  | support_io
#PWR000D01 | GND | power:GND |  | support_io
#PWR01 | GND | power:GND |  | power
#PWR010 | GND | power:GND |  | power
#PWR0101 | GND | power:GND |  | support_io
#PWR0102 | GND | power:GND |  | support_io
#PWR0103 | GND | power:GND |  | support_io
#PWR011 | GND | power:GND |  | power
#PWR012 | GND | power:GND |  | power
#PWR013 | GND | power:GND |  | power
#PWR014 | GND | power:GND |  | power
#PWR015 | GND | power:GND |  | power
#PWR016 | GND | power:GND |  | power
#PWR017 | GND | power:GND |  | power
#PWR018 | GND | power:GND |  | power
#PWR019 | GND | power:GND |  | power
#PWR02 | GND | power:GND |  | power
#PWR020 | GND | power:GND |  | power
#PWR021 | GND | power:GND |  | power
#PWR022 | GND | power:GND |  | power
#PWR023 | GND | power:GND |  | power
#PWR024 | GND | power:GND |  | power
#PWR025 | GND | power:GND |  | power
#PWR026 | GND | power:GND |  | power
#PWR027 | GND | power:GND |  | power
#PWR028 | GND | power:GND |  | power
#PWR029 | GND | power:GND |  | power
#PWR03 | GND | power:GND |  | power
#PWR041 | GND | power:GND |  | power
#PWR042 | GND | power:GND |  | power
#PWR043 | GND | power:GND |  | power
#PWR044 | GND | power:GND |  | power
#PWR045 | GND | power:GND |  | power
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
J1 | JX1 | UZEV_Connectors:SEAF-40-05.0-S-10-2-A-K-TR_JX1 | UZEV_Connectors:SEAF-40-05.0-S-10-2-A-K-TR_200P | connectors
J1 | JX1 | UZEV_Connectors:SEAF-40-05.0-S-10-2-A-K-TR_JX1 | UZEV_Connectors:SEAF-40-05.0-S-10-2-A-K-TR_200P | connectors
J2 | JX2 | UZEV_Connectors:SEAF-40-05.0-S-10-2-A-K-TR_JX2 | UZEV_Connectors:SEAF-40-05.0-S-10-2-A-K-TR_200P | connectors
J2 | JX2 | UZEV_Connectors:SEAF-40-05.0-S-10-2-A-K-TR_JX2 | UZEV_Connectors:SEAF-40-05.0-S-10-2-A-K-TR_200P | connectors
J2 | JX2 | UZEV_Connectors:SEAF-40-05.0-S-10-2-A-K-TR_JX2 | UZEV_Connectors:SEAF-40-05.0-S-10-2-A-K-TR_200P | connectors
J2 | JX2 | UZEV_Connectors:SEAF-40-05.0-S-10-2-A-K-TR_JX2 | UZEV_Connectors:SEAF-40-05.0-S-10-2-A-K-TR_200P | connectors
J3 | JX3 | UZEV_Connectors:SEAF-30-05.0-S-10-2-A-K-TR_JX3 | UZEV_Connectors:SEAF-30-05.0-S-10-2-A-K-TR_120P | connectors
J3 | JX3 | UZEV_Connectors:SEAF-30-05.0-S-10-2-A-K-TR_JX3 | UZEV_Connectors:SEAF-30-05.0-S-10-2-A-K-TR_120P | connectors
J3 | JX3 | UZEV_Connectors:SEAF-30-05.0-S-10-2-A-K-TR_JX3 | UZEV_Connectors:SEAF-30-05.0-S-10-2-A-K-TR_120P | connectors
J3 | JX3 | UZEV_Connectors:SEAF-30-05.0-S-10-2-A-K-TR_JX3 | UZEV_Connectors:SEAF-30-05.0-S-10-2-A-K-TR_120P | connectors
J4 | FMC_HPC_ADRV9009 | UZEV_Connectors:FMC_HPC_ADRV9009 | Connector_Samtec:Samtec_FMC_ASP-134602-01_10x40_P1.27mm_Vertical | connectors
J4 | FMC_HPC_ADRV9009 | UZEV_Connectors:FMC_HPC_ADRV9009 | Connector_Samtec:Samtec_FMC_ASP-134602-01_10x40_P1.27mm_Vertical | connectors
J4 | FMC_HPC_ADRV9009 | UZEV_Connectors:FMC_HPC_ADRV9009 | Connector_Samtec:Samtec_FMC_ASP-134602-01_10x40_P1.27mm_Vertical | connectors
J4 | FMC_HPC_ADRV9009 | UZEV_Connectors:FMC_HPC_ADRV9009 | Connector_Samtec:Samtec_FMC_ASP-134602-01_10x40_P1.27mm_Vertical | connectors
J4 | FMC_HPC_ADRV9009 | UZEV_Connectors:FMC_HPC_ADRV9009 | Connector_Samtec:Samtec_FMC_ASP-134602-01_10x40_P1.27mm_Vertical | connectors
J4 | FMC_HPC_ADRV9009 | UZEV_Connectors:FMC_HPC_ADRV9009 | Connector_Samtec:Samtec_FMC_ASP-134602-01_10x40_P1.27mm_Vertical | connectors
J4 | FMC_HPC_ADRV9009 | UZEV_Connectors:FMC_HPC_ADRV9009 | Connector_Samtec:Samtec_FMC_ASP-134602-01_10x40_P1.27mm_Vertical | connectors
J4 | FMC_HPC_ADRV9009 | UZEV_Connectors:FMC_HPC_ADRV9009 | Connector_Samtec:Samtec_FMC_ASP-134602-01_10x40_P1.27mm_Vertical | connectors
J4 | FMC_HPC_ADRV9009 | UZEV_Connectors:FMC_HPC_ADRV9009 | Connector_Samtec:Samtec_FMC_ASP-134602-01_10x40_P1.27mm_Vertical | connectors
J4 | FMC_HPC_ADRV9009 | UZEV_Connectors:FMC_HPC_ADRV9009 | Connector_Samtec:Samtec_FMC_ASP-134602-01_10x40_P1.27mm_Vertical | connectors
J5 | USB_C_Receptacle | UZEV_Connectors:USB_C_Receptacle |  | power
J6 | UART_HDR | Connector:Conn_01x04_Male | Connector_PinHeader_2.54mm:PinHeader_1x04_P2.54mm_Vertical | support_io
J7 | JTAG_HDR | Connector:Conn_01x06_Male | Connector_PinHeader_2.54mm:PinHeader_1x06_P2.54mm_Vertical | support_io
J8 | MICRO_SD_DNP | Connector:Micro_SD_Card_Det | Connector_Card:microSD_HC_Hirose_DM3AT-SF-PEJM5 | support_io
L1 | TPS7A85 | UZEV_Connectors:LDO_ENPG | Package_DFN_QFN:QFN-20-1EP_3.5x3.5mm_P0.5mm_EP2x2mm | power
L2 | TPS7A85 | UZEV_Connectors:LDO_ENPG | Package_DFN_QFN:QFN-20-1EP_3.5x3.5mm_P0.5mm_EP2x2mm | power
L3 | TPS7A85 | UZEV_Connectors:LDO_ENPG | Package_DFN_QFN:QFN-20-1EP_3.5x3.5mm_P0.5mm_EP2x2mm | power
L4 | TPS7A85 | UZEV_Connectors:LDO_ENPG | Package_DFN_QFN:QFN-20-1EP_3.5x3.5mm_P0.5mm_EP2x2mm | power
R1 | 2.2k | Device:R | Resistor_SMD:R_0402_1005Metric | support_io
R2 | 2.2k | Device:R | Resistor_SMD:R_0402_1005Metric | support_io
R3 | 10k | Device:R | Resistor_SMD:R_0402_1005Metric | support_io
R4 | 0R_DNP | Device:R | Resistor_SMD:R_0402_1005Metric | support_io
R5 | 0R_DNP | Device:R | Resistor_SMD:R_0402_1005Metric | support_io
R6 | 0R_DNP | Device:R | Resistor_SMD:R_0402_1005Metric | support_io
R7 | 0R_DNP | Device:R | Resistor_SMD:R_0402_1005Metric | support_io
R8 | 0R_DNP | Device:R | Resistor_SMD:R_0402_1005Metric | support_io
R9 | 0R_DNP | Device:R | Resistor_SMD:R_0402_1005Metric | support_io
R10 | 10k | Device:R | Resistor_SMD:R_0402_1005Metric | support_io
R11 | 1k | Device:R | Resistor_SMD:R_0402_1005Metric | support_io
R12 | 10k | Device:R | Resistor_SMD:R_0402_1005Metric | support_io
R13 | 88.7k | Device:R | Resistor_SMD:R_0402_1005Metric | power
R14 | 100k | Device:R | Resistor_SMD:R_0402_1005Metric | power
R15 | 124k | Device:R | Resistor_SMD:R_0402_1005Metric | power
R16 | 100k | Device:R | Resistor_SMD:R_0402_1005Metric | power
R17 | 215k | Device:R | Resistor_SMD:R_0402_1005Metric | power
R18 | 100k | Device:R | Resistor_SMD:R_0402_1005Metric | power
R19 | 215k | Device:R | Resistor_SMD:R_0402_1005Metric | power
R20 | 100k | Device:R | Resistor_SMD:R_0402_1005Metric | power
R21 | 316k | Device:R | Resistor_SMD:R_0402_1005Metric | power
R22 | 100k | Device:R | Resistor_SMD:R_0402_1005Metric | power
R23 | 12.4k | Device:R | Resistor_SMD:R_0402_1005Metric | power
R24 | 100k | Device:R | Resistor_SMD:R_0402_1005Metric | power
R25 | 49.9k | Device:R | Resistor_SMD:R_0402_1005Metric | power
R26 | 100k | Device:R | Resistor_SMD:R_0402_1005Metric | power
R27 | 124k | Device:R | Resistor_SMD:R_0402_1005Metric | power
R28 | 100k | Device:R | Resistor_SMD:R_0402_1005Metric | power
R29 | 124k | Device:R | Resistor_SMD:R_0402_1005Metric | power
R30 | 100k | Device:R | Resistor_SMD:R_0402_1005Metric | power
R31 | 1.78k | Device:R | Resistor_SMD:R_0402_1005Metric | power
R32 | 1.78k | Device:R | Resistor_SMD:R_0402_1005Metric | power
R33 | 1.78k | Device:R | Resistor_SMD:R_0402_1005Metric | power
R34 | 1.78k | Device:R | Resistor_SMD:R_0402_1005Metric | power
R35 | 37.4k | Device:R | Resistor_SMD:R_0402_1005Metric | power
R36 | 100k | Device:R | Resistor_SMD:R_0402_1005Metric | power
R37 | 100k | Device:R | Resistor_SMD:R_0402_1005Metric | power
R38 | 100k | Device:R | Resistor_SMD:R_0402_1005Metric | power
R39 | 100k | Device:R | Resistor_SMD:R_0402_1005Metric | power
R40 | 91k | Device:R | Resistor_SMD:R_0402_1005Metric | power
R41 | 11k | Device:R | Resistor_SMD:R_0402_1005Metric | power
R42 | 82k | Device:R | Resistor_SMD:R_0402_1005Metric | power
R43 | 20k | Device:R | Resistor_SMD:R_0402_1005Metric | power
R44 | 100k | Device:R | Resistor_SMD:R_0402_1005Metric | power
R45 | 4.7k | Device:R | Resistor_SMD:R_0402_1005Metric | power
R46 | 10k | Device:R | Resistor_SMD:R_0402_1005Metric | power
R47 | 10k | Device:R | Resistor_SMD:R_0402_1005Metric | power
R48 | 10k | Device:R | Resistor_SMD:R_0402_1005Metric | power
R49 | 10k | Device:R | Resistor_SMD:R_0402_1005Metric | power
SW1 | RESET | Switch:SW_Push | Button_Switch_SMD:SW_SPST_CK_RS282G05A3 | support_io
U6 | TPS25730D | UZEV_Connectors:TPS25730D |  | power
U7 | TPS7A1633 | UZEV_Connectors:TPS7A1633 |  | power
