AgileRadioCom-LLC/ARC-Re-Packaging-Design/uzev_adrv9009_carrier.kicad_pcb

## KiCad design uzev_adrv9009_carrier.kicad_pcb (2026-06-29)

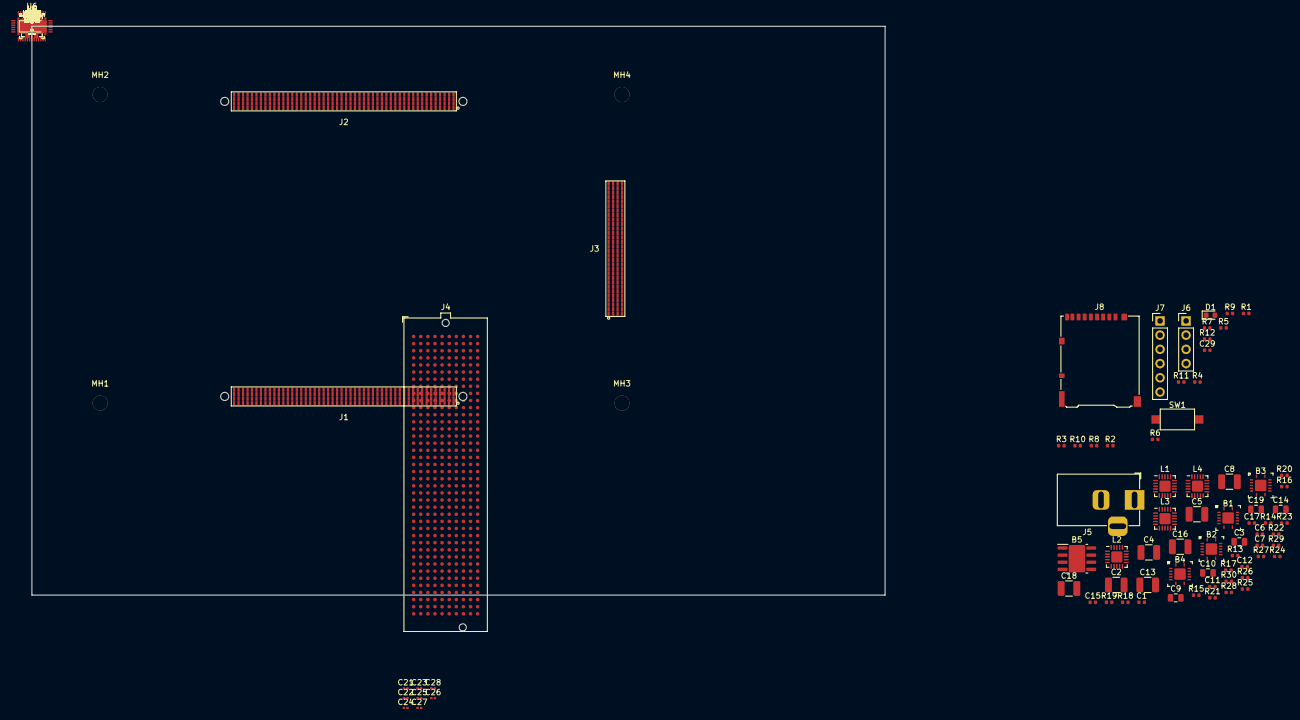
[picture p1: board uzev_adrv9009_carrier.kicad_pcb from above]

Board: 8 copper layers, 152.4 x 101.6 mm, 179 parts (0 on the bottom side), 169 nets, no tracks yet.

Parts:
B1, B2, B3, B4, B6, B7: TPS54320; VQFN-14-1EP_3.5x3.5mm_P0.5mm_EP2.05x2.05mm
B5: TPS54531; SOIC-8-1EP_3.9x4.9mm_P1.27mm_EP2.95x4.9mm_Mask2.71x3.4mm
C1, C6, C7, C11, C12, C15, C17, C29, C40, C41, C42, C43, C44, C61, C66, C67, C68, C69, C75, C76: 100nF; C_0402_1005Metric
C2, C8, C13, C16, C18, C65, C70, C77: 47uF; C_1210_3225Metric
C3, C9, C14, C19, C60, C62, C71, C78: 10uF; C_0805_2012Metric
C4, C5: 33uF; C_1210_3225Metric
C10: 4.7uF; C_0805_2012Metric
C21, C22, C23, C24, C25, C26, C27, C28: 100nF; C_0201_0603Metric
C45, C46, C47, C48, C72, C79: 15nF; C_0402_1005Metric
C49: 2200pF; C_0402_1005Metric
C50, C51, C52, C53, C63, C64, C73, C80: 330pF; C_0402_1005Metric
C54: 22pF; C_0402_1005Metric
C55, C56, C57, C58, C59, C74, C81: 10nF; C_0402_1005Metric
D1: GREEN; LED_0603_1608Metric
D2: CDBC540-G; D_SOD-123
FB1: "120R@100MHz 0603"; L_0603_1608Metric
IND1, IND2, IND3, IND4, IND5, IND6, IND7: 4.7uH; L_1210_3225Metric
J1, J2: SEAF-40-05.0-S-10-2-A-K-TR_200P
J3: SEAF-30-05.0-S-10-2-A-K-TR_120P
J4: FMC_HPC_ADRV9009; Samtec_FMC_ASP-134602-01_10x40_P1.27mm_Vertical
J5: 12V_DC_IN; BarrelJack_Horizontal
J6: UART_HDR; PinHeader_1x04_P2.54mm_Vertical
J7: JTAG_HDR; PinHeader_1x06_P2.54mm_Vertical
J8: MICRO_SD_DNP; microSD_HC_Hirose_DM3AT-SF-PEJM5
L1, L2, L3, L4, L5, L6: TPS7A85; QFN-20-1EP_3.5x3.5mm_P0.5mm_EP2x2mm
MH1, MH2, MH3, MH4: MountingHole_2.7mm
R1, R2: 2.2k; R_0402_1005Metric
R3, R10, R12, R46, R47, R48, R49: 10k; R_0402_1005Metric
R4, R5, R6, R7, R8, R9: 0R_DNP; R_0402_1005Metric
R11: 1k; R_0402_1005Metric
R13: 88.7k; R_0402_1005Metric
R14, R16, R18, R20, R22, R24, R26, R28, R30, R36, R37, R38, R39, R44, R50, R51, R52, R53, R55, R57, R59, R60, R62, R64, R66, R67, R68, R69, R70, R71: 100k; R_0402_1005Metric
R15, R27, R29, R63: 124k; R_0402_1005Metric
R17, R19: 215k; R_0402_1005Metric
R21: 316k; R_0402_1005Metric
R23: 12.4k; R_0402_1005Metric
R25: 49.9k; R_0402_1005Metric
R31, R32, R33, R34, R58, R65: 1.78k; R_0402_1005Metric
R35: 37.4k; R_0402_1005Metric
R40: 91k; R_0402_1005Metric
R41: 11k; R_0402_1005Metric
R42: 82k; R_0402_1005Metric
R43: 20k; R_0402_1005Metric
R45: 4.7k; R_0402_1005Metric
R54: 61.9k; R_0402_1005Metric
R56: 6.19k; R_0402_1005Metric
R61: 162k; R_0402_1005Metric
SW1: RESET; SW_SPST_CK_RS282G05A3
U6: TPS25730D; WQFN-38_TPS25730D
U7: TPS7A1633; HVSSOP-8_TPS7A1633

Connections:
/Power/B6_PG: B6.5, L5.4, R60.2
/Power/B7_PG: B7.5, L6.4, R67.2
/Power/CC1: C63.1, J5.3, U6.28
/Power/CC2: C64.1, R42.2, R43.1, U6.5, U6.29
/Power/L1_PG: B2.4, L1.5, R68.2
/Power/L2_PG: B3.4, B4.4, B5.4, L2.5, R69.2
/Power/L5_PG: B7.4, L5.5, R70.2
/Power/L6_PG: B1.4, L6.5, R71.2
/Power/LDO_1V5: U6.3, U6.4
/Power/LDO_3V3: R40.1, R42.1, R44.1, R44.2, R45.1, R49.1, U6.1, U6.7
/Power/VIN_3V3: C62.1, C67.1, U6.38, U7.7, U7.8
FMC_3P3V: B5.3, IND5.1, J4.C39, J4.D36, J4.D38, J4.D40, R21.1
FMC_A02_DP1_M2C_P: J2.A21, J4.A2
FMC_A03_DP1_M2C_N: J2.A22, J4.A3
FMC_A06_DP2_M2C_P: J2.C21, J4.A6
FMC_A07_DP2_M2C_N: J2.C22, J4.A7
FMC_A10_DP3_M2C_P: J2.A24, J4.A10
FMC_A11_DP3_M2C_N: J2.A25, J4.A11
FMC_A22_DP1_C2M_P: J2.D20, J4.A22
FMC_A23_DP1_C2M_N: J2.D21, J4.A23
FMC_A26_DP2_C2M_P: J2.B20, J4.A26
FMC_A27_DP2_C2M_N: J2.B21, J4.A27
FMC_A30_DP3_C2M_P: J2.B23, J4.A30
FMC_A31_DP3_C2M_N: J2.B24, J4.A31
FMC_B20_GBTCLK1_M2C_P: J2.C27, J4.B20
FMC_B21_GBTCLK1_M2C_N: J2.C28, J4.B21
FMC_C02_DP0_C2M_P: J2.D23, J4.C2
FMC_C03_DP0_C2M_N: J2.D24, J4.C3
FMC_C06_DP0_M2C_P: J2.C24, J4.C6
FMC_C07_DP0_M2C_N: J2.C25, J4.C7
FMC_C10_LA06_P: J1.D42, J4.C10
FMC_C11_LA06_N: J1.D43, J4.C11
FMC_C18_LA14_P: J1.C41, J4.C18
FMC_C19_LA14_N: J1.C42, J4.C19
FMC_C22_LA18_CC_P: J1.A27, J4.C22
FMC_C23_LA18_CC_N: J1.A28, J4.C23
FMC_D04_GBTCLK0_M2C_P: J2.D26, J4.D4
FMC_D05_GBTCLK0_M2C_N: J2.D27, J4.D5
FMC_D08_LA01_CC_P: J1.D32, J4.D8
FMC_D09_LA01_CC_N: J1.D33, J4.D9
FMC_D14_LA09_P: J1.D36, J4.D14
FMC_D15_LA09_N: J1.D37, J4.D15
FMC_D17_LA13_P: J1.A31, J4.D17
FMC_D18_LA13_N: J1.A32, J4.D18
FMC_D26_LA26_P: J1.A41, J4.D26
FMC_D27_LA26_N: J1.A42, J4.D27
FMC_G06_LA00_CC_P: J1.C31, J4.G6
FMC_G07_LA00_CC_N: J1.C32, J4.G7
FMC_G09_LA03_P: J1.B42, J4.G9
FMC_G10_LA03_N: J1.B43, J4.G10
FMC_G12_LA08_P: J1.D39, J4.G12
FMC_G15_LA12_P: J1.C35, J4.G15
FMC_G16_LA12_N: J1.C36, J4.G16
FMC_G18_LA16_P: J1.C27, J4.G18
FMC_G19_LA16_N: J1.C28, J4.G19
FMC_G21_LA20_P: J1.D25, J4.G21
FMC_G22_LA20_N: J1.D26, J4.G22
FMC_G24_LA22_P: J1.C38, J4.G24
FMC_G25_LA22_N: J1.C39, J4.G25
FMC_G27_LA25_P: J1.B25, J4.G27
FMC_G28_LA25_N: J1.B26, J4.G28
FMC_H07_LA02_P: J1.B28, J4.H7
FMC_H08_LA02_N: J1.B29, J4.H8
FMC_H10_LA04_P: J1.A35, J4.H10
FMC_H11_LA04_N: J1.A36, J4.H11
FMC_H13_LA07_P: J1.B32, J4.H13
FMC_H14_LA07_N: J1.B33, J4.H14
FMC_H16_LA11_P: J1.A38, J4.H16
FMC_H17_LA11_N: J1.A39, J4.H17
FMC_H19_LA15_P: J1.D28, J4.H19
FMC_H20_LA15_N: J1.D29, J4.H20
FMC_H22_LA19_P: J1.C24, J4.H22
FMC_H23_LA19_N: J1.C25, J4.H23
FMC_H25_LA21_P: J1.A24, J4.H25
FMC_H26_LA21_N: J1.A25, J4.H26
GND: B1.2, B2.2, B3.2, B4.2, B5.2, B5.6, B6.2, B7.2, C10.2, C11.2, C45.2, C46.2, C47.2, C48.2, C49.2, C50.2, C51.2, C52.2, C53.2, C54.2, C55.2, C56.2, C57.2, C58.2, C59.2, C60.2, C61.2, C62.2, C63.2, C64.2, C65.2, C66.2, C67.2, C68.2, C70.2, C71.2, C72.2, C73.2, C74.2, C75.2, C77.2, C78.2, C79.2, C80.2, C81.2, D2.2, J5.2, J6.4, J7.6, J8.6, J8.11, L1.2, L2.2, L3.2, L4.2, L5.2, L5.6, L6.2, L6.6, R14.2, R16.2, R18.2, R20.2, R21.2, R22.1, R22.2, R24.2, R26.2, R28.2, R30.2, R36.2, R37.2, R38.2, R39.2, R41.2, R43.2, R45.2, R46.1, R47.1, R48.1, R55.2, R56.2, R57.1, R57.2, R59.2, R62.2, R63.2, R64.1, R64.2, R66.2, SW1.2, U6.8, U6.9, U6.11, U6.12, U6.14, U6.16, U6.17, U6.31, U6.34, U6.35, U6.39, U7.2, U7.9
JTAG_TCK: J1.D1, R6.1
JTAG_TDI: J1.C2, R7.1
JTAG_TDO: J1.D2, R8.1
JTAG_TMS: J1.C1, R9.1
MGTAVCC: J2.C1, J2.C2, J2.D4, J2.D7, J2.D10, J2.D13, L1.3, R23.1
MGTAVTT: J2.A1, J2.A2, J2.B4, J2.B7, J2.B10, J2.B13, L2.3, R25.1
MGTRAVCC: C71.1, J3.B29, L5.3
MGTRAVCC_SENSE: J3.D20, R56.1
MGTRAVTT: C78.1, J3.B25, L6.3
MGTRAVTT_SENSE: J3.C25, R63.1
MGTVCCAUX: C10.1, C11.1, FB1.2, J2.A5, J2.A8
unnamed: B1.3, IND1.1, L1.1, R13.1, R50.1
unnamed: B1.5, L1.4, R50.2
unnamed: B1.6, R13.2, R14.1
unnamed: B1.7, C40.2, IND1.2
unnamed: B1.8, C40.1
unnamed: B1.9, C50.1, R31.1
unnamed: B1.10, R36.1
unnamed: B1.11, C55.1
unnamed: B2.3, IND2.1, L2.1, R15.1, R51.1
unnamed: B2.5, L2.4, R51.2
unnamed: B2.6, R15.2, R16.1
unnamed: B2.7, C41.2, IND2.2
unnamed: B2.8, C41.1
unnamed: B2.9, C51.1, R32.1
unnamed: B2.10, R37.1
unnamed: B2.11, C56.1
unnamed: B3.3, IND3.1, L3.1, R17.1, R52.1
unnamed: B3.5, L3.4, R52.2
unnamed: B3.6, R17.2, R18.1
unnamed: B3.7, C42.2, IND3.2
unnamed: B3.8, C42.1
unnamed: B3.9, C52.1, R33.1
unnamed: B3.10, R38.1
unnamed: B3.11, C57.1
unnamed: B4.3, IND4.1, L4.1, R19.1, R53.1
unnamed: B4.5, L4.4, R53.2
unnamed: B4.6, R19.2, R20.1
unnamed: B4.7, C43.2, IND4.2
unnamed: B4.8, C43.1
unnamed: B4.9, C53.1, R34.1
unnamed: B4.10, R39.1
unnamed: B4.11, C58.1
unnamed: B5.7, C44.2, D2.1, IND5.2
unnamed: B5.8, C44.1
unnamed: B5.9, C54.1, R35.1
unnamed: B6.3, C70.1, IND6.1, L5.1, R54.1, R60.1
unnamed: B6.6, R54.2, R55.1
unnamed: B6.7, C69.2, IND6.2
unnamed: B6.8, C69.1
unnamed: B6.9, C73.1, R58.1
unnamed: B6.10, R59.1
unnamed: B6.11, C74.1
unnamed: B7.3, C77.1, IND7.1, L6.1, R61.1, R67.1
unnamed: B7.6, R61.2, R62.1
unnamed: B7.7, C76.2, IND7.2
unnamed: B7.8, C76.1
unnamed: B7.9, C80.1, R65.1
unnamed: B7.10, R66.1
unnamed: B7.11, C81.1
unnamed: C45.1, R31.2
unnamed: C46.1, R32.2
unnamed: C47.1, R33.2
unnamed: C48.1, R34.2
unnamed: C49.1, R35.2
unnamed: C61.1, U7.5
unnamed: C72.1, R58.2
unnamed: C79.1, R65.2
unnamed: J7.2, R9.2
unnamed: J7.3, R6.2
unnamed: J7.4, R8.2
unnamed: J7.5, R7.2
unnamed: L1.6, R23.2, R24.1
unnamed: L2.6, R25.2, R26.1
unnamed: L3.6, R27.2, R28.1
unnamed: L4.6, R29.2, R30.1
unnamed: R4.2, R5.1
unnamed: R40.2, R41.1, U6.2
unnamed: R46.2, U6.26
unnamed: R47.2, U6.27
unnamed: R48.2, U6.36
unnamed: R49.2, U6.18
SD1_CD_N: J3.A23, J8.10
SD1_CLK: J3.B24, J8.5
SD1_CMD: J3.A25, J8.3
SD1_D0: J3.B26, J8.7
SD1_D1: J3.A27, J8.8
SD1_D2: J3.B28, J8.1
SD1_D3: J3.A29, J8.2
SOM_PG_OUT: B6.4, J1.D47
VADJ: FB1.1, J1.C3, J1.D3, J1.D4, J4.E39, J4.F40, J4.G39, J4.H40, J7.1, L3.3, R27.1
VCCO_HP_64: J1.A3, J1.B3, J1.B4, L4.3, R29.1
VIN: B1.1, B2.1, B3.1, B4.1, B5.1, B6.1, B7.1, C60.1, C65.1, C66.1, C68.1, C75.1, J1.A43, J1.A46, J1.A49, J1.A50, J1.B44, J1.B47, J1.B50, J1.C50, J5.1, R68.1, R69.1, R70.1, R71.1, U6.15, U6.20, U6.21, U6.22, U6.23, U6.24, U6.25, U6.30, U6.32, U6.33, U6.40, U7.1, U7.3
